cansat-tsniimash/KNPN-2023/construction/Sat/plata_dop_asm_final_naverno.stl

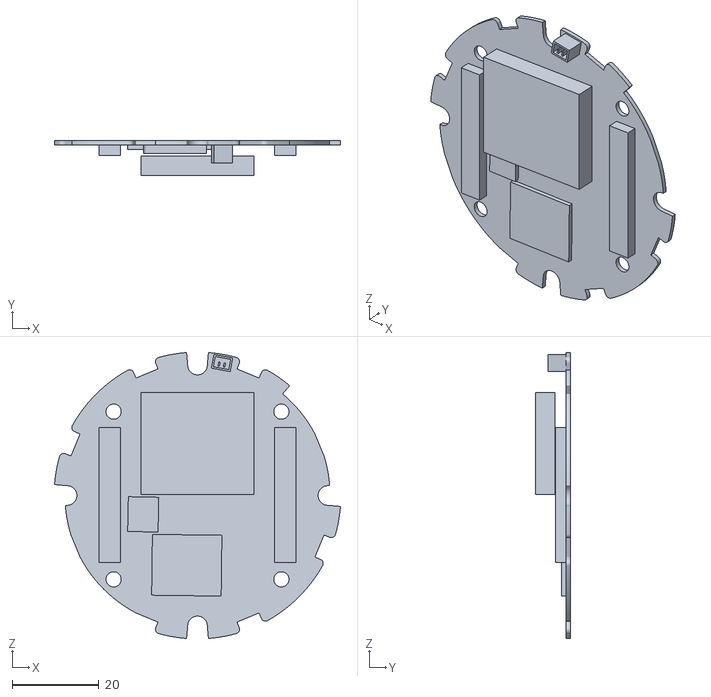
[picture p1: CAD file, 2023-04-08]
construction/Sat/plata_dop_asm_final_naverno.stl
65.8 x 8.00 x 65.8
