cansat-tsniimash/KNPN-2023/construction/Sat/print/plata_dop_pla_down.stl

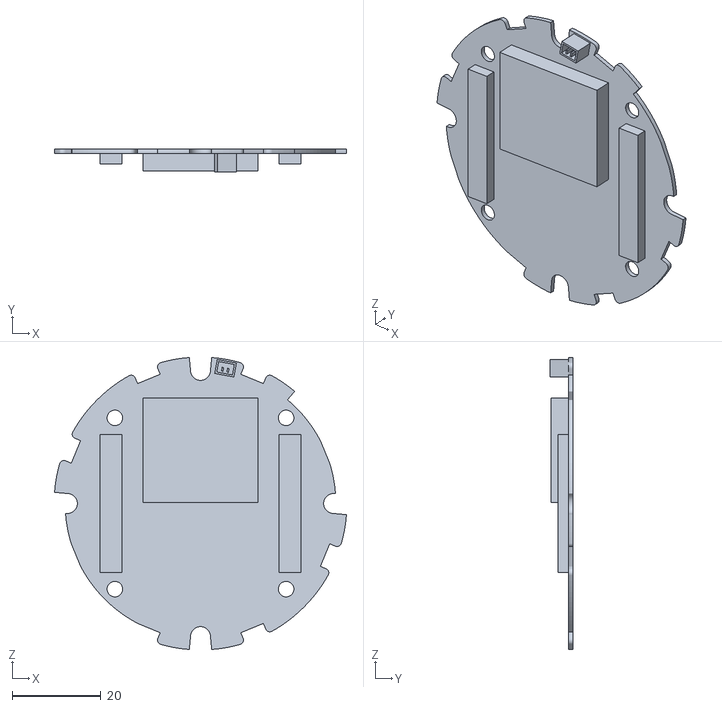
[picture p2: CAD file, 2023-05-27]
construction/Sat/print/plata_dop_pla_down.stl
65.8 x 5.20 x 65.8
