cansat-tsniimash/KNPN-2023/construction/Sat/sp_base.stl

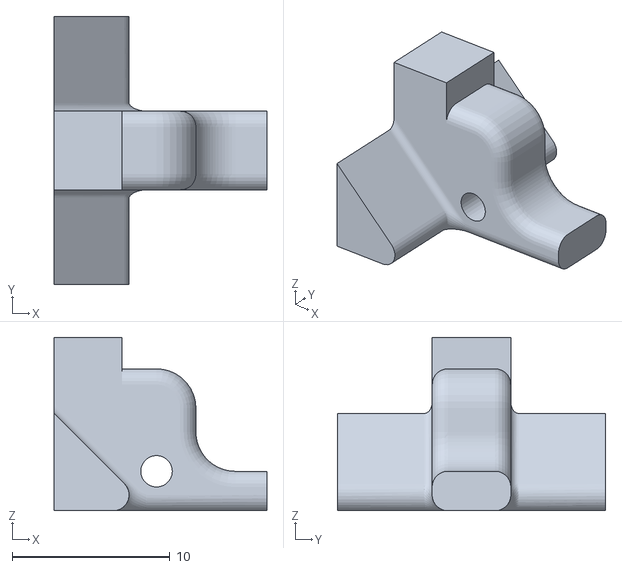
[picture p3: CAD file, 2023-07-02]
construction/Sat/sp_base.stl
13.5 x 17.0 x 11.0
