cansat-tsniimash/KNPN-2023/construction/STL/box.stl

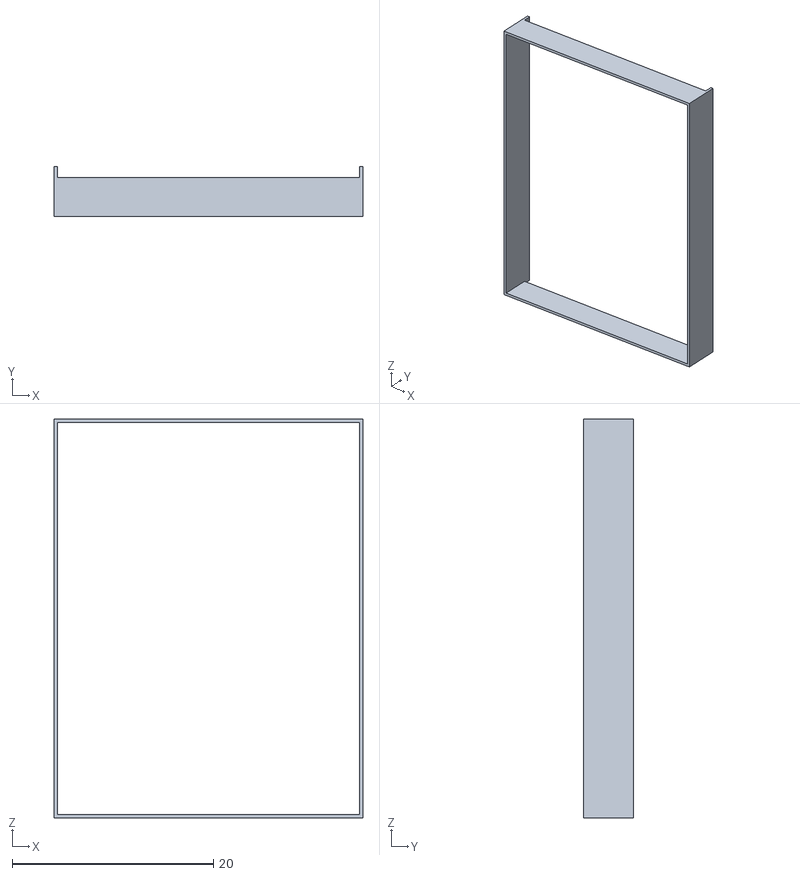
[picture p4: CAD file, 2023-07-02]
construction/STL/box.stl
30.7 x 5.00 x 39.7
