cansat-tsniimash/KNPN-2023/construction/Sat/gear-bot-big.stp

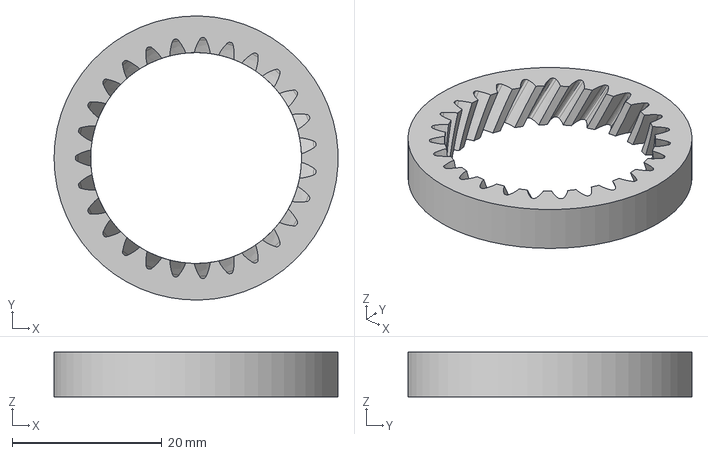
[picture p5: CAD file, 2023-06-05]
construction/Sat/gear-bot-big.stp
38.0 x 38.0 x 6.00 mm
