cansat-tsniimash/KNPN-2023/construction/Sat/print/sp_krepezh_plata2.stl

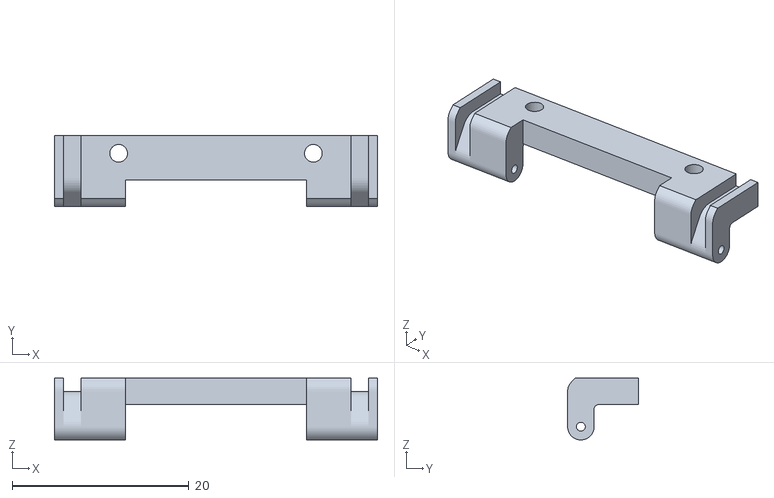
[picture p6: CAD file, 2023-05-27]
construction/Sat/print/sp_krepezh_plata2.stl
36.5 x 8.00 x 7.00
