cansat-tsniimash/KNPN-2023/construction/STL/sp_krepezh_plata1.stl

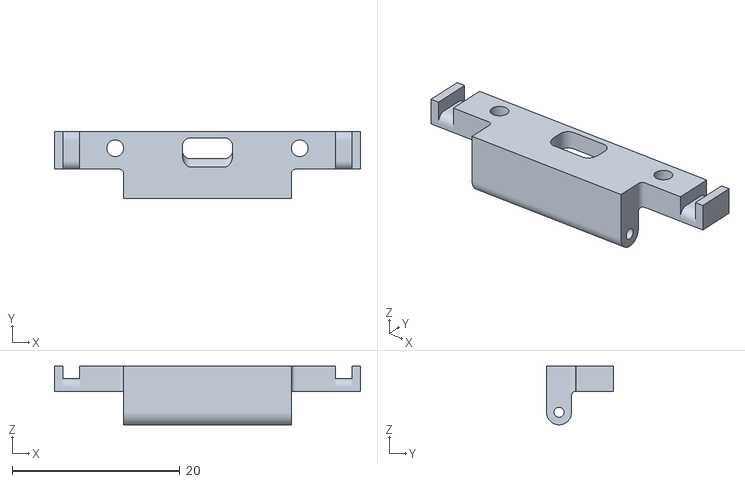
[picture p7: CAD file, 2023-07-02]
construction/STL/sp_krepezh_plata1.stl
36.5 x 8.00 x 7.00
