cansat-tsniimash/KNPN-2023/construction/Sat/gear-bot-small.stp

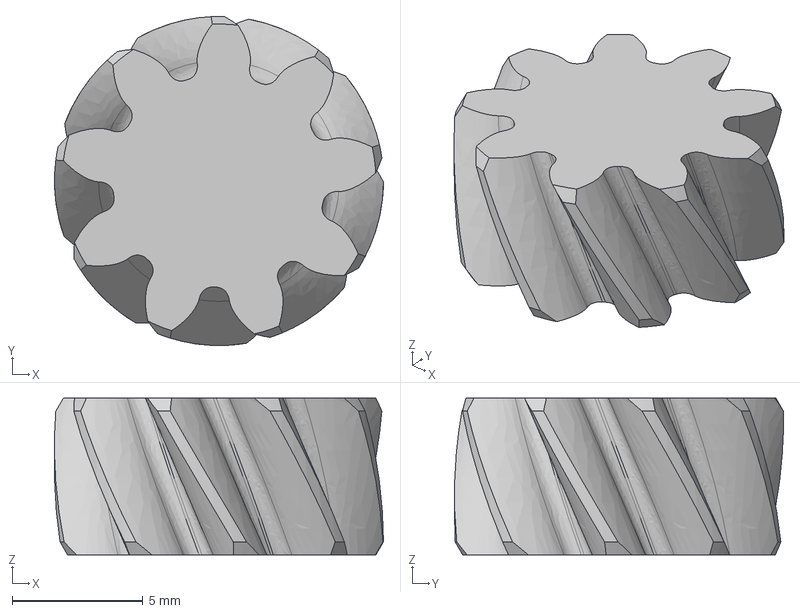
[picture p8: CAD file, 2023-06-05]
construction/Sat/gear-bot-small.stp
12.6 x 12.6 x 6.00 mm
