cansat-tsniimash/KNPN-2023/construction/STL/gear_motor_2axis_max.stl

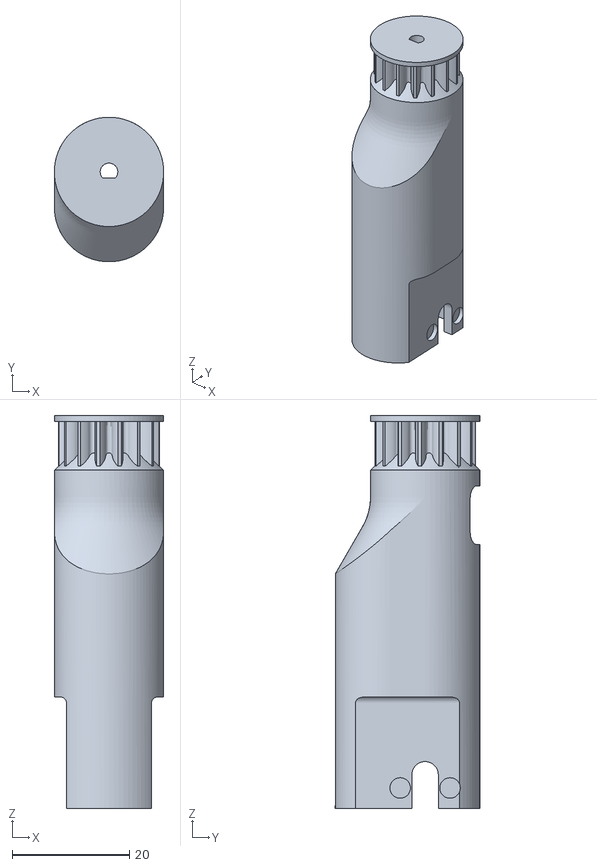
[picture p9: CAD file, 2023-07-02]
construction/STL/gear_motor_2axis_max.stl
18.6 x 24.6 x 67.0
