cansat-tsniimash/KNPN-2023/construction/Sat/krishka_akkum.stl

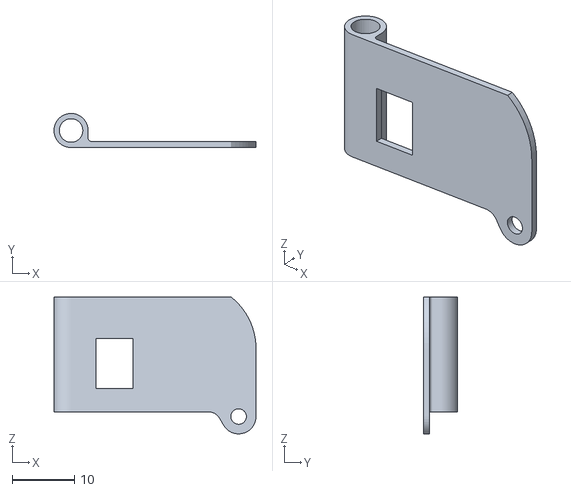
[picture p10: CAD file, 2023-05-27]
construction/Sat/krishka_akkum.stl
32.5 x 5.50 x 22.0
