cansat-tsniimash/KNPN-2023/construction/Sat/print/parachut_gps.stl

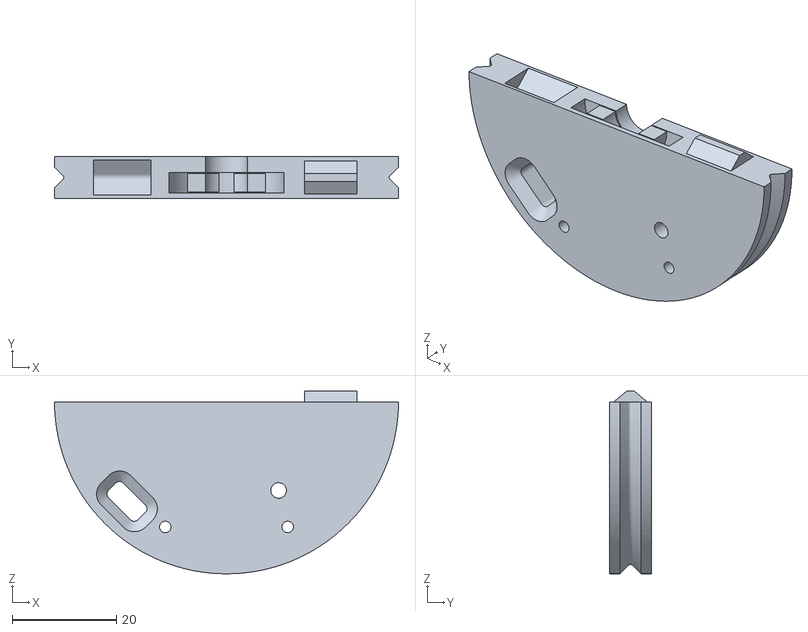
[picture p11: CAD file, 2023-05-27]
construction/Sat/print/parachut_gps.stl
66.0 x 8.00 x 35.1
