cansat-tsniimash/KNPN-2023/construction/STL/blinchik-down_1_low.stl

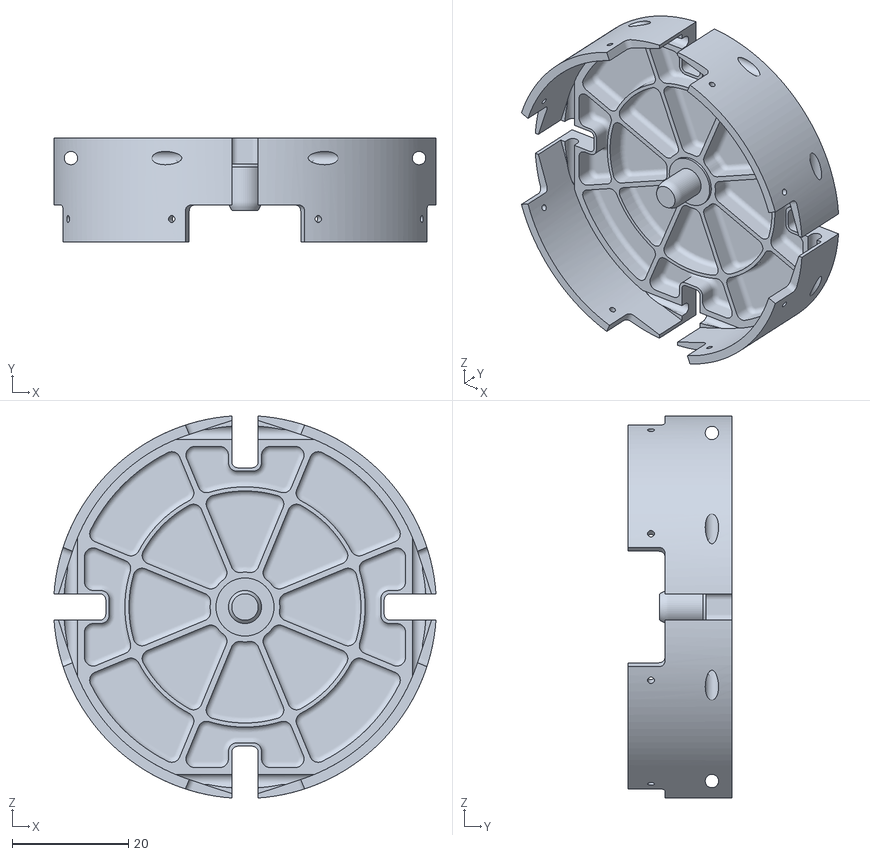
[picture p12: CAD file, 2023-07-02]
construction/STL/blinchik-down_1_low.stl
65.8 x 18.0 x 65.8
