cansat-tsniimash/KNPN-2023/construction/Sat/kreplenie_motor_i_akkum_niz.stl

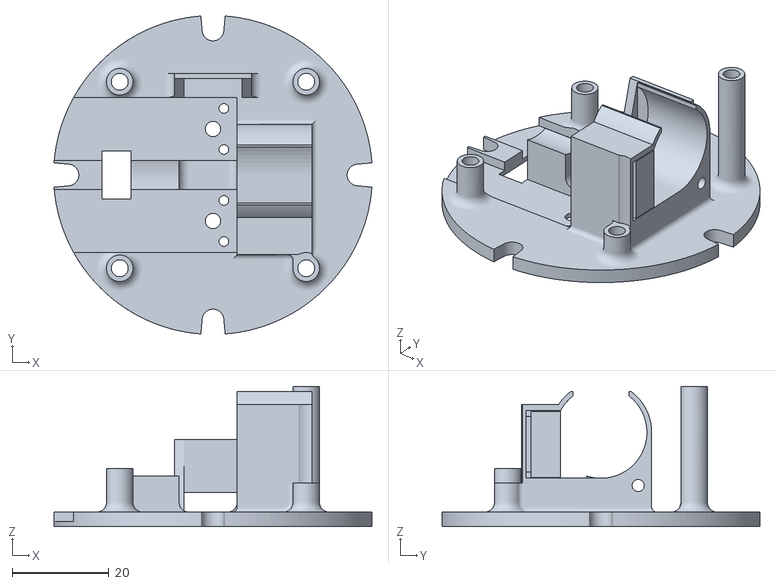
[picture p13: CAD file, 2023-05-27]
construction/Sat/kreplenie_motor_i_akkum_niz.stl
65.8 x 65.8 x 29.0
