cansat-tsniimash/KNPN-2023/construction/Sat/print/blinchik_for_kreplenie.stl

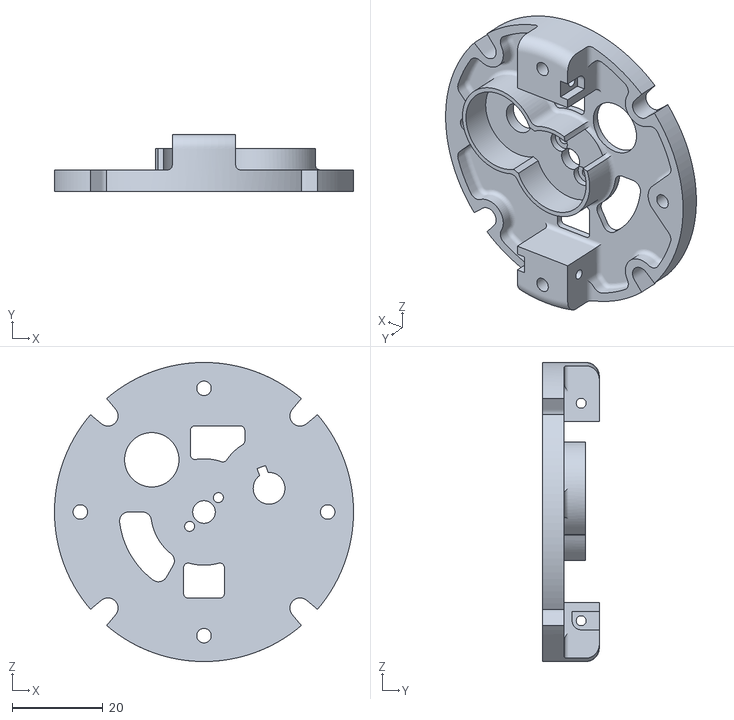
[picture p14: CAD file, 2023-05-27]
construction/Sat/print/blinchik_for_kreplenie.stl
66.0 x 12.5 x 66.0
