cansat-tsniimash/KNPN-2023/construction/STL/sp_zaglushka.stl

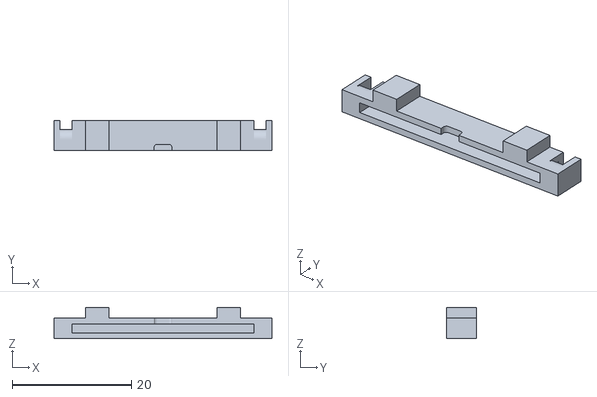
[picture p15: CAD file, 2023-07-02]
construction/STL/sp_zaglushka.stl
36.5 x 5.00 x 5.20
