cansat-tsniimash/KNPN-2023/construction/Sat/disk.stl

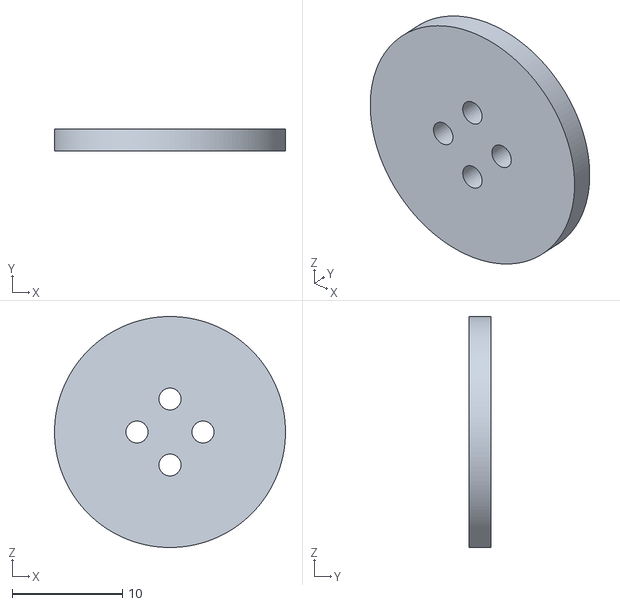
[picture p16: CAD file, 2023-05-27]
construction/Sat/disk.stl
21.0 x 2.00 x 21.0
