cansat-tsniimash/KNPN-2023/construction/STL/kreplenie_motor_i_akkum_niz_2.stl

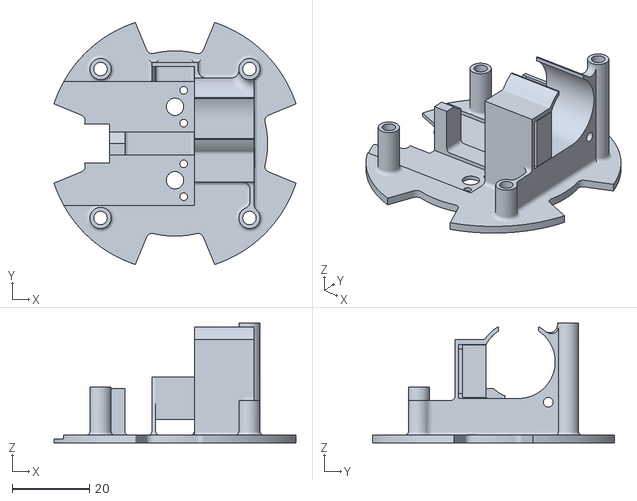
[picture p17: CAD file, 2023-07-02]
construction/STL/kreplenie_motor_i_akkum_niz_2.stl
62.7 x 62.7 x 31.0
