cansat-tsniimash/KNPN-2023/construction/Sat/kreplenie_plata.stl

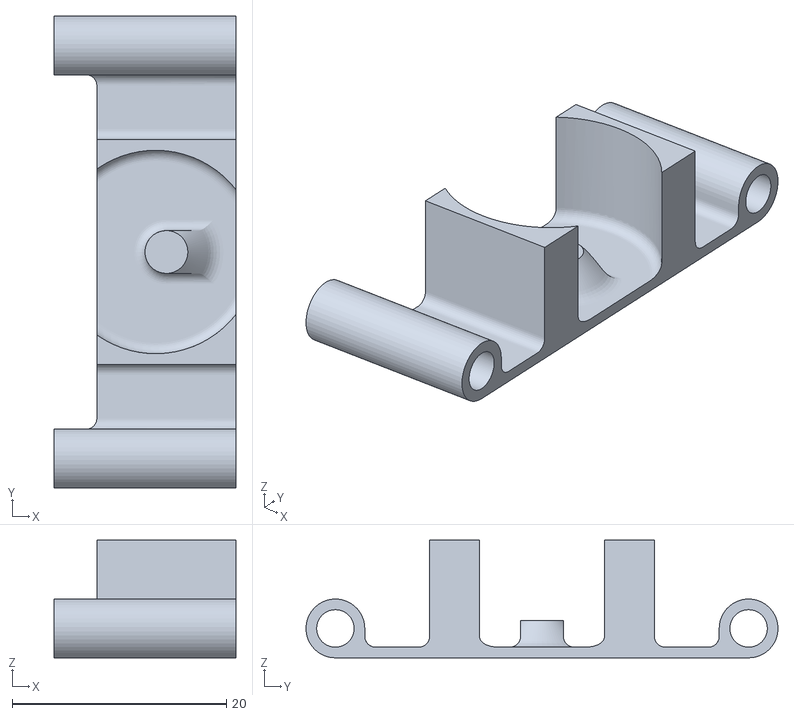
[picture p18: CAD file, 2023-05-27]
construction/Sat/kreplenie_plata.stl
17.0 x 44.1 x 11.0
