cansat-tsniimash/KNPN-2023/construction/STL/cilindr.stl

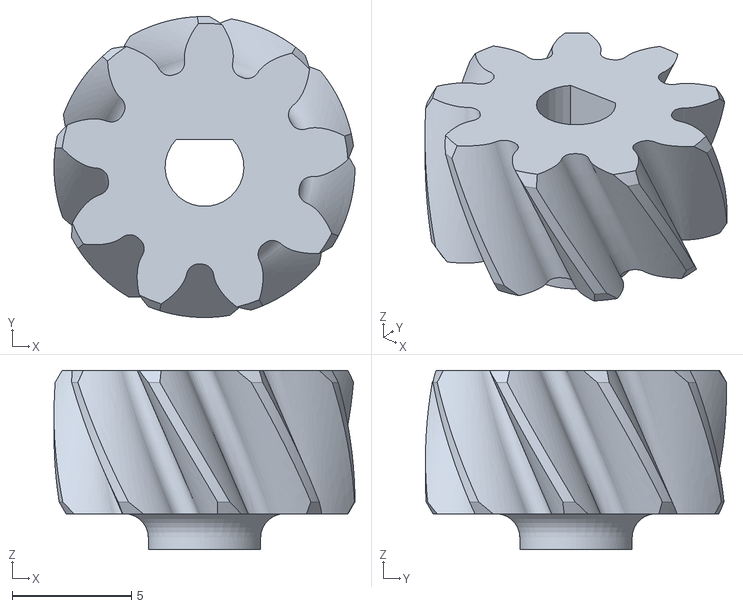
[picture p19: CAD file, 2023-07-02]
construction/STL/cilindr.stl
12.6 x 12.6 x 7.50
