cansat-tsniimash/KNPN-2023/construction/Sat/parachut_gps_final_pechat_100pro.stl

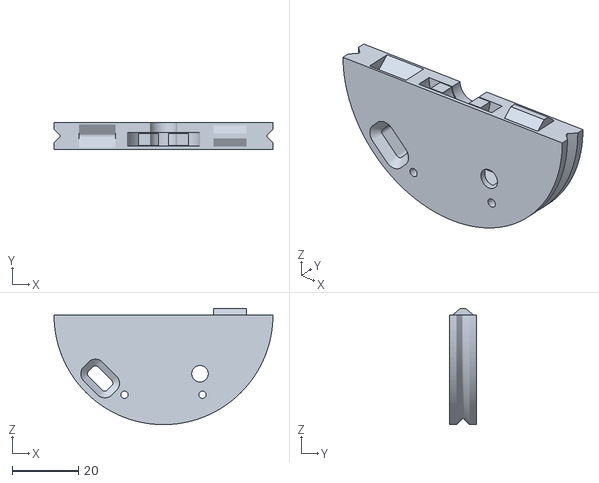
[picture p20: CAD file, 2023-05-27]
construction/Sat/parachut_gps_final_pechat_100pro.stl
66.0 x 8.00 x 35.1
