cansat-tsniimash/KNPN-2023/construction/Sat/print/sp_plata.stl

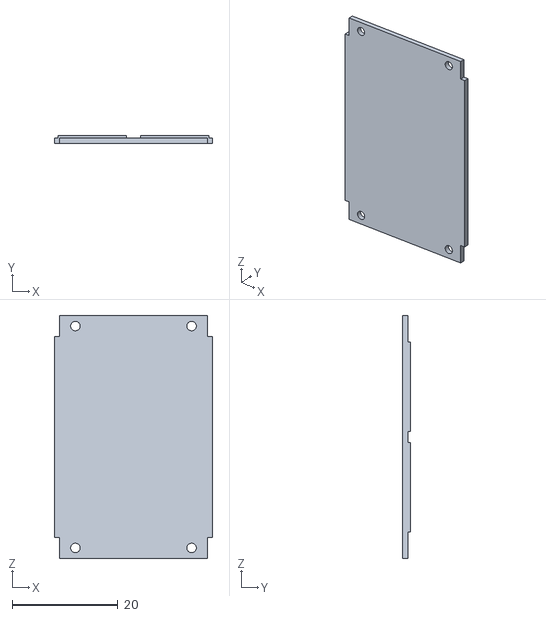
[picture p21: CAD file, 2023-05-27]
construction/Sat/print/sp_plata.stl
30.0 x 1.50 x 46.0
