cansat-tsniimash/KNPN-2023/construction/Sat/plata_dop_pla2.stl

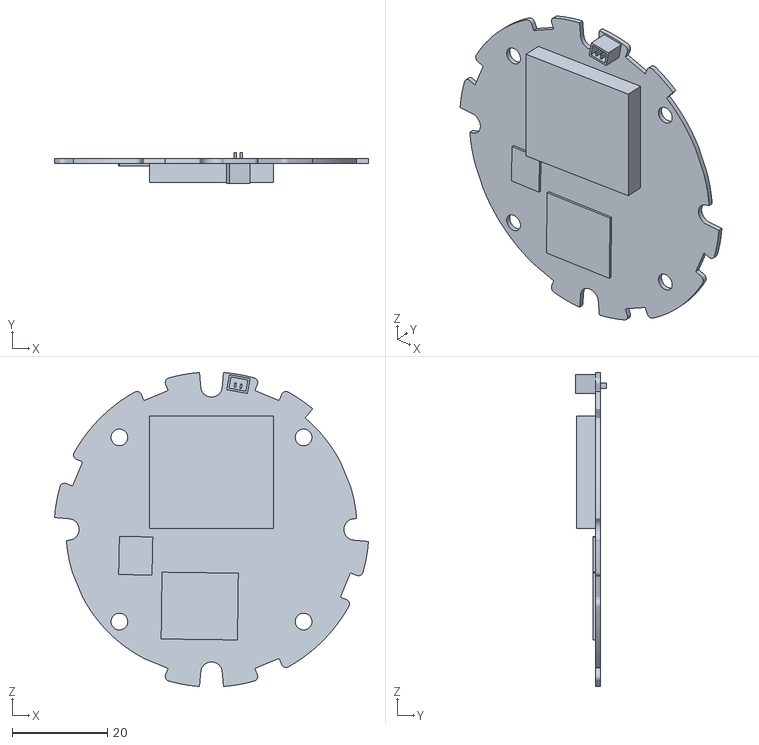
[picture p22: CAD file, 2023-04-08]
construction/Sat/plata_dop_pla2.stl
65.8 x 6.50 x 65.8
