cansat-tsniimash/KNPN-2023/construction/Sat/print/sp_zaglushka.stl

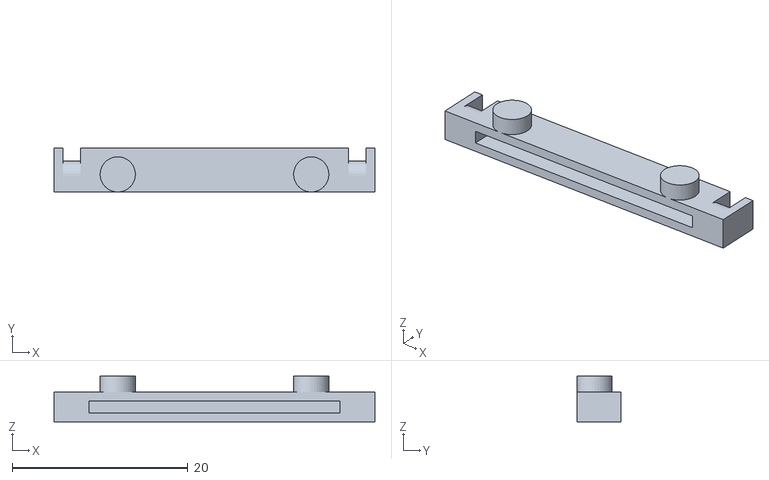
[picture p23: CAD file, 2023-05-27]
construction/Sat/print/sp_zaglushka.stl
36.5 x 5.00 x 5.20
