cansat-tsniimash/KNPN-2023/construction/Sat/plata_dop_pla_fixed2.stl

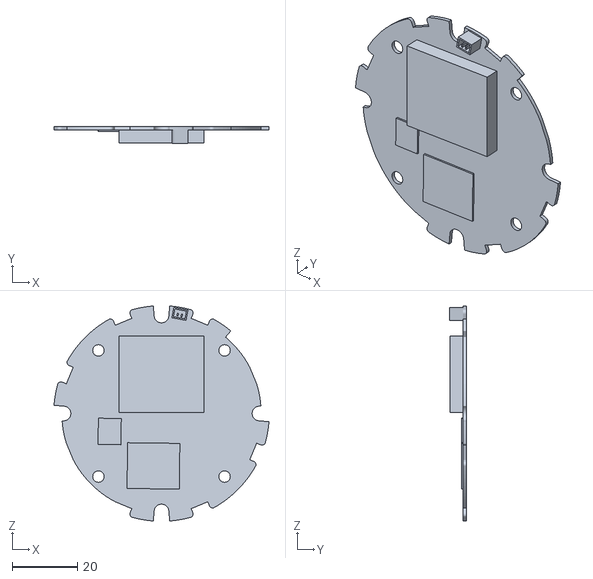
[picture p24: CAD file, 2023-04-08]
construction/Sat/plata_dop_pla_fixed2.stl
65.8 x 5.20 x 65.8
