cansat-tsniimash/KNPN-2023/construction/Sat/print/sp_krepezh_plata_motor.stl

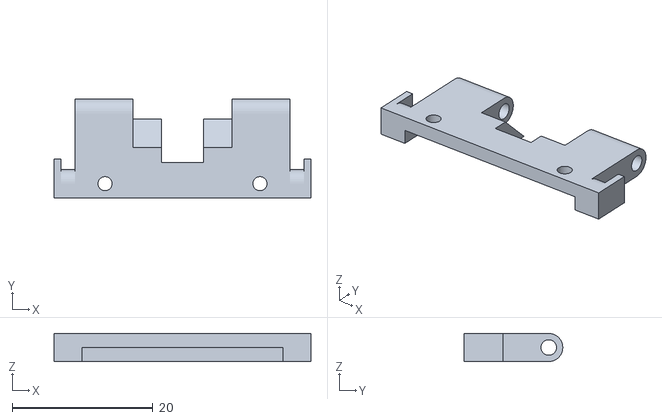
[picture p25: CAD file, 2023-05-27]
construction/Sat/print/sp_krepezh_plata_motor.stl
36.5 x 14.0 x 4.00
