cansat-tsniimash/KNPN-2023/construction/STL/detal_vrashenie_w_spring.stl

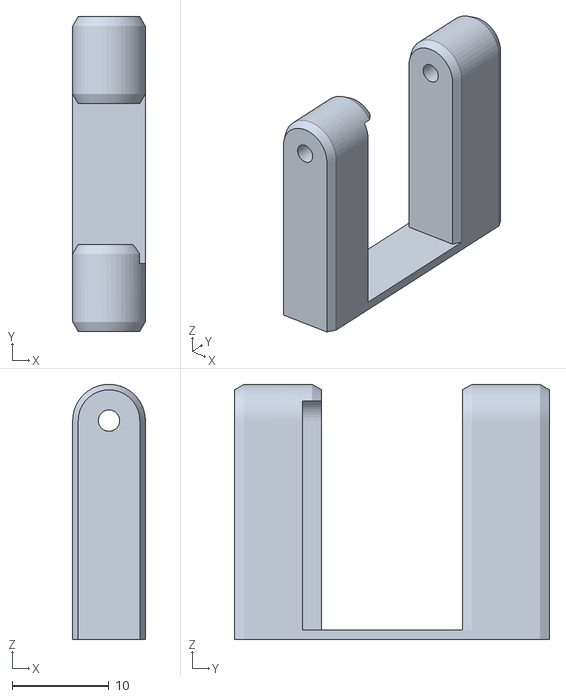
[picture p26: CAD file, 2023-07-02]
construction/STL/detal_vrashenie_w_spring.stl
7.50 x 32.5 x 26.3
