cansat-tsniimash/KNPN-2023/construction/Sat/blinchik-down_2.stl

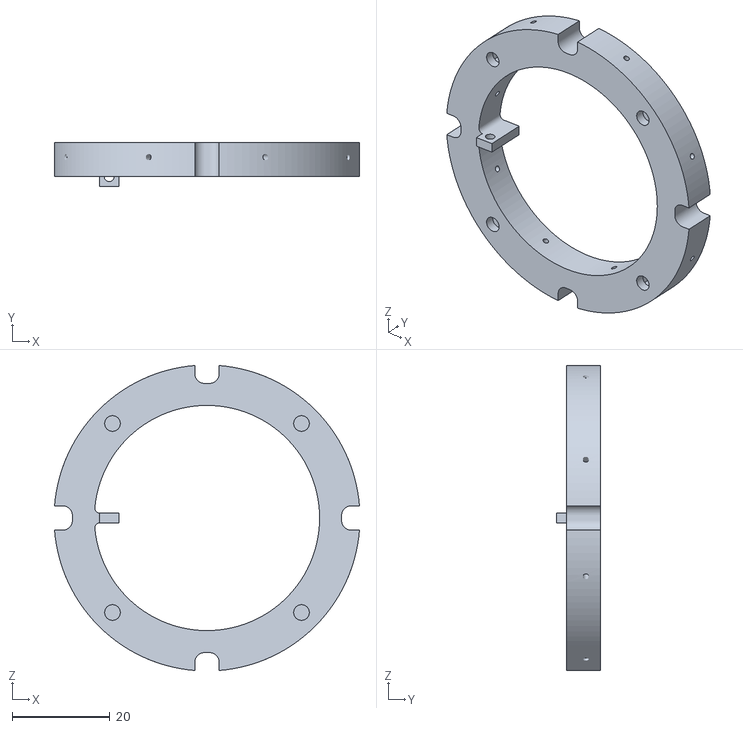
[picture p27: CAD file, 2023-04-08]
construction/Sat/blinchik-down_2.stl
62.3 x 9.00 x 62.3
