cansat-tsniimash/KNPN-2023/construction/Sat/print/plata_dop_pla_up.stl

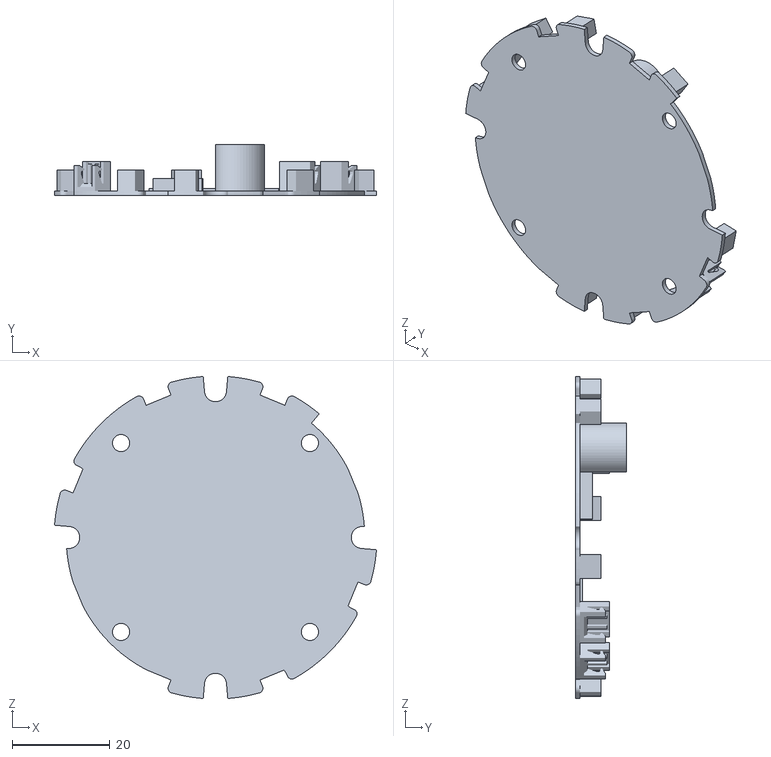
[picture p28: CAD file, 2023-05-27]
construction/Sat/print/plata_dop_pla_up.stl
65.8 x 10.5 x 65.8
