cansat-tsniimash/KNPN-2023/construction/STL/sp_krepezh_plata_motor.stl

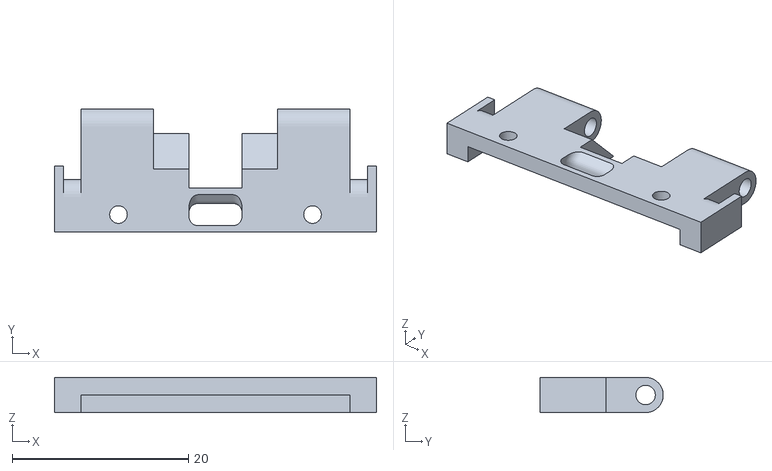
[picture p29: CAD file, 2023-07-02]
construction/STL/sp_krepezh_plata_motor.stl
36.5 x 14.0 x 4.00
