cansat-tsniimash/KNPN-2023/construction/Sat/plata_dop_pla1.stl

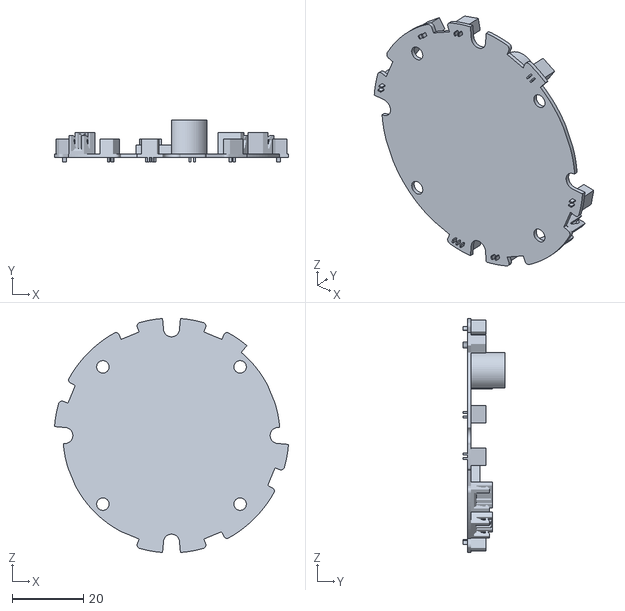
[picture p30: CAD file, 2023-04-08]
construction/Sat/plata_dop_pla1.stl
65.8 x 11.8 x 65.8
