cansat-tsniimash/KNPN-2023/construction/STL/blinchik-down_2_final.stl

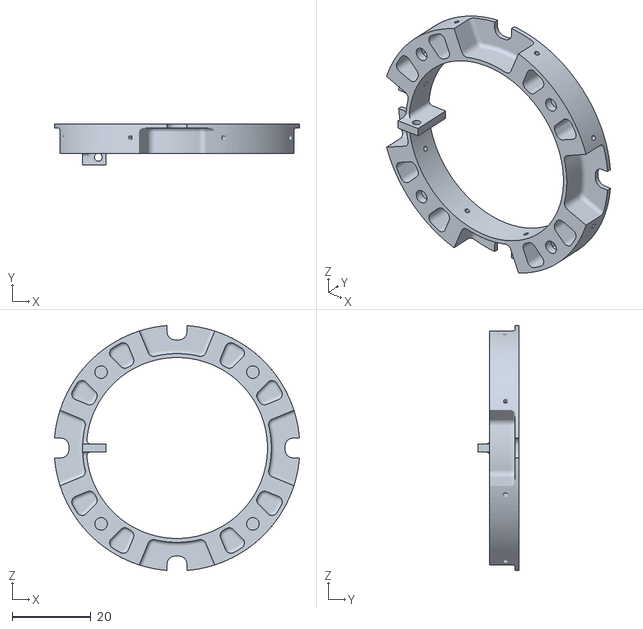
[picture p31: CAD file, 2023-07-02]
construction/STL/blinchik-down_2_final.stl
62.3 x 10.5 x 62.3
