cansat-tsniimash/KNPN-2023/construction/Sat/blinchik-down_1.stl

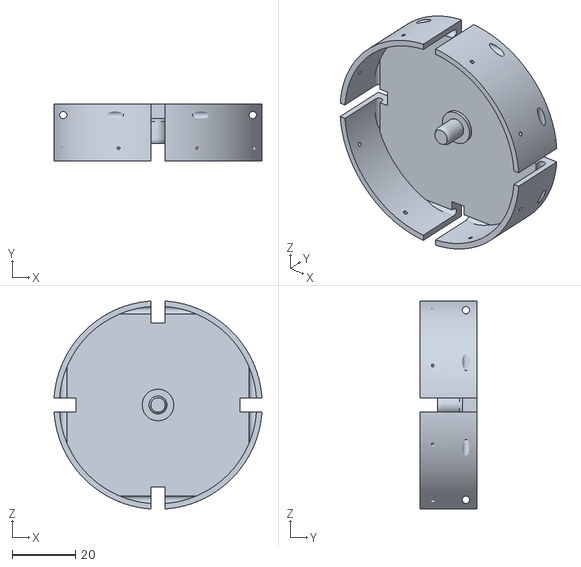
[picture p32: CAD file, 2023-04-08]
construction/Sat/blinchik-down_1.stl
65.8 x 18.0 x 65.8
