cansat-tsniimash/KNPN-2023/construction/Sat/plata_dop_pla_fixed1.stl

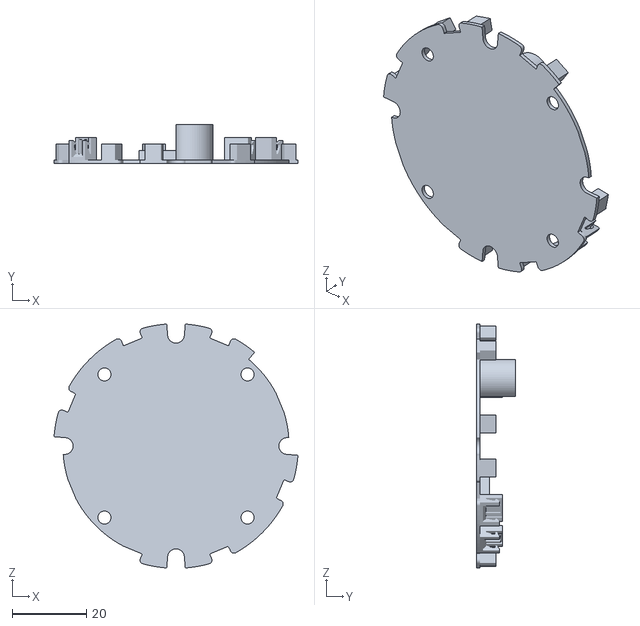
[picture p33: CAD file, 2023-04-08]
construction/Sat/plata_dop_pla_fixed1.stl
65.8 x 10.5 x 65.8
