cansat-tsniimash/KNPN-2023/construction/STL/kreplenie_plata.stl

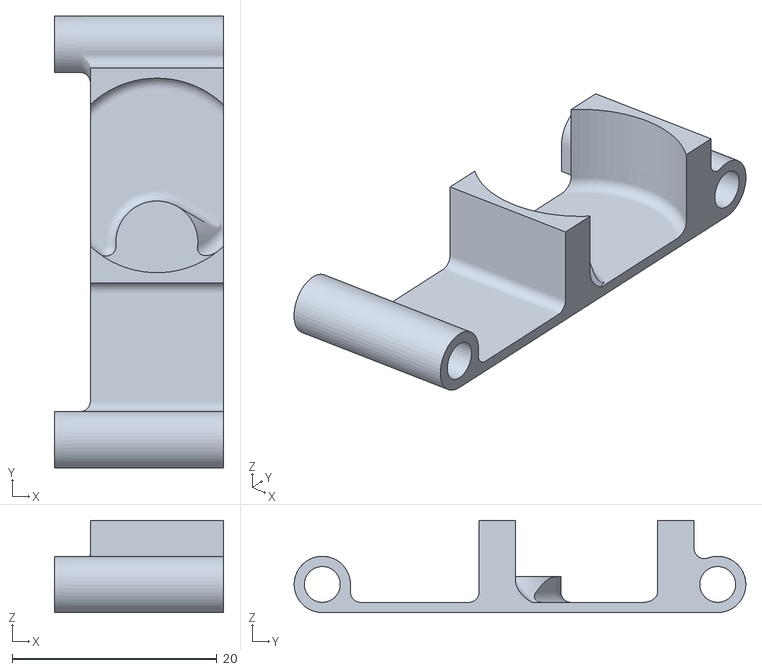
[picture p34: CAD file, 2023-06-05]
construction/STL/kreplenie_plata.stl
16.5 x 44.1 x 9.00
