cansat-tsniimash/KNPN-2023/construction/Sat/kreplenie_camera.stl

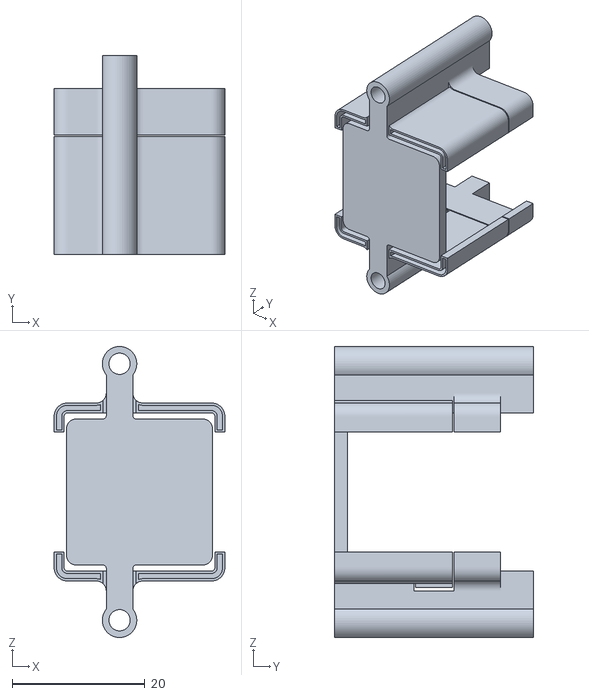
[picture p35: CAD file, 2023-04-08]
construction/Sat/kreplenie_camera.stl
25.7 x 30.0 x 43.8
