cansat-tsniimash/KNPN-2023/construction/Sat/tube_4mm.stl

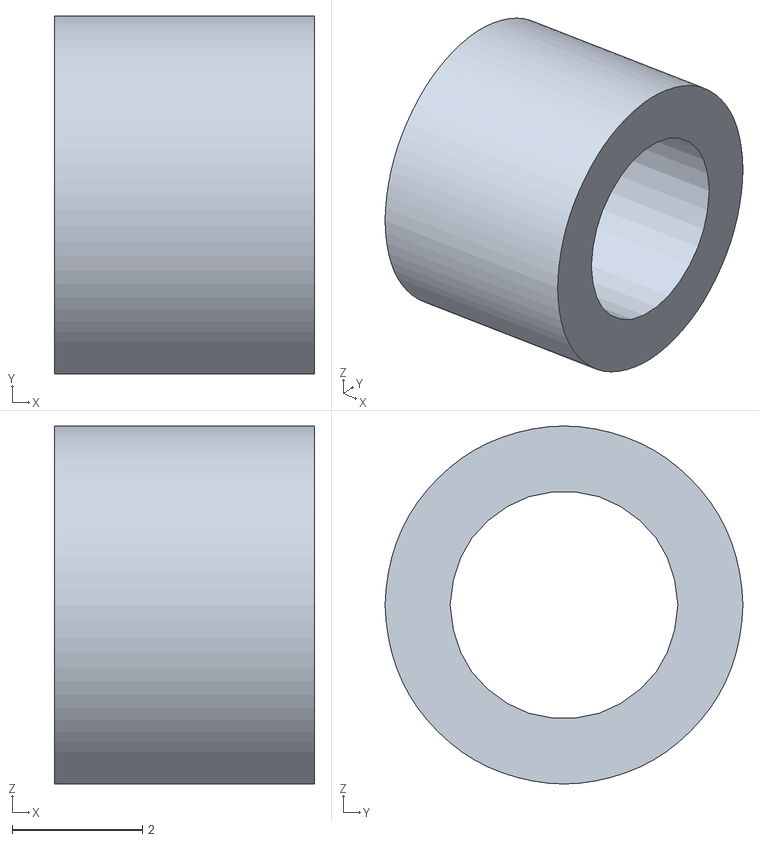
[picture p36: CAD file, 2023-04-08]
construction/Sat/tube_4mm.stl
4.00 x 5.50 x 5.50
