cansat-tsniimash/KNPN-2023/construction/STL/parachut_gps.stl

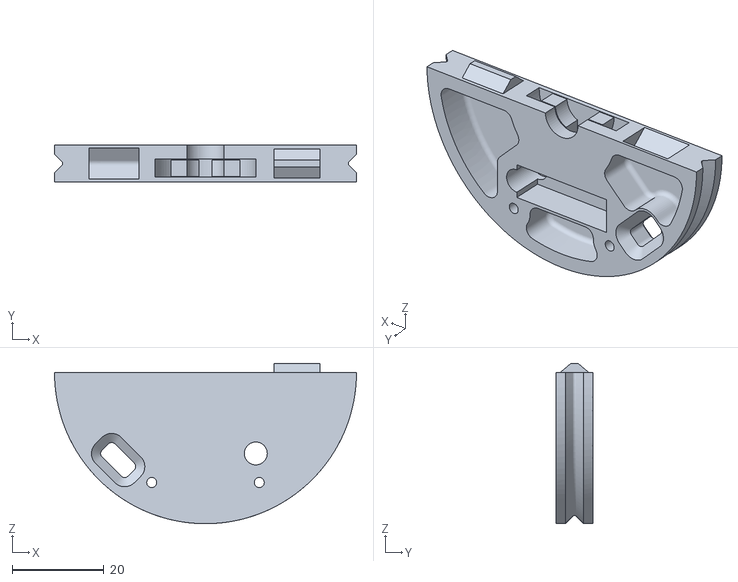
[picture p37: CAD file, 2023-06-05]
construction/STL/parachut_gps.stl
66.0 x 8.00 x 35.1
