cansat-tsniimash/KNPN-2023/construction/Sat/tube_7mm.stl

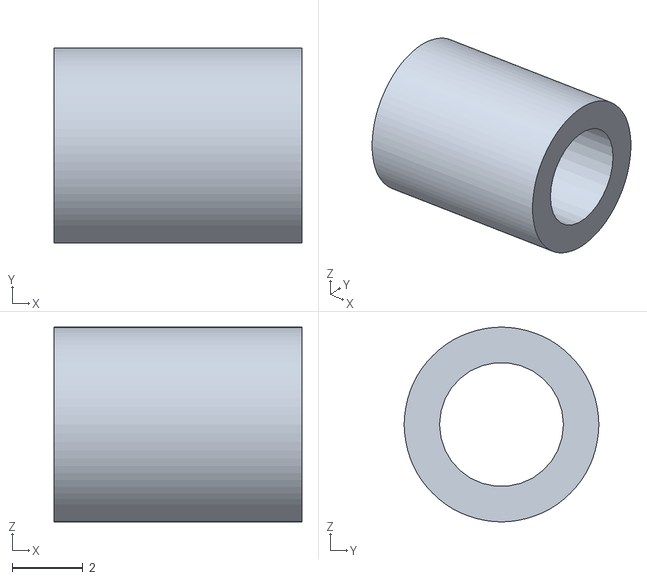
[picture p38: CAD file, 2023-04-08]
construction/Sat/tube_7mm.stl
7.00 x 5.50 x 5.50
