cansat-tsniimash/KNPN-2023/construction/STL/blinchik_kernel_up.stl

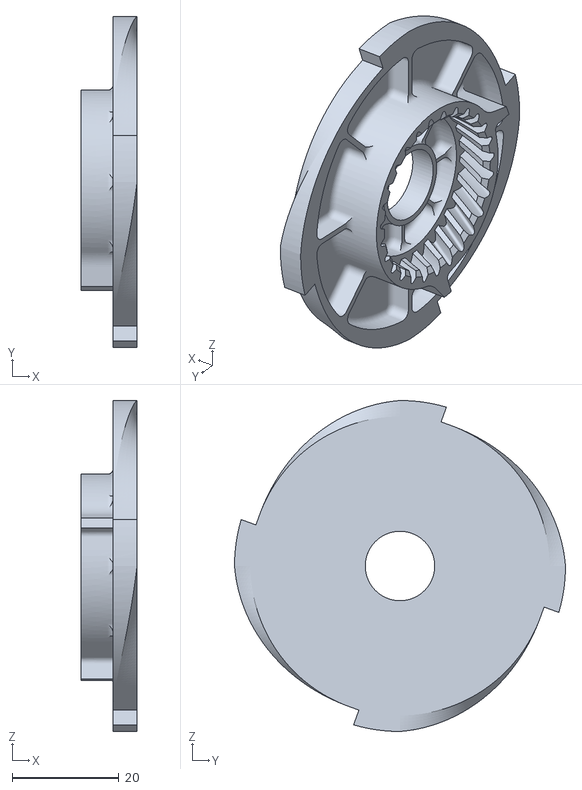
[picture p39: CAD file, 2023-06-05]
construction/STL/blinchik_kernel_up.stl
10.5 x 62.0 x 62.0
