cansat-tsniimash/KNPN-2023/construction/Sat/drw0001.dxf

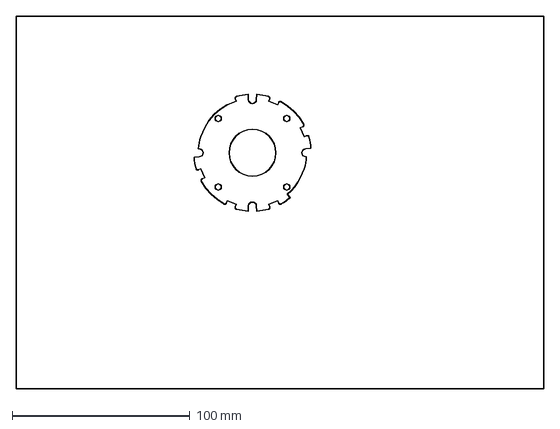
[picture p40: CAD file, 2023-03-27]
construction/Sat/drw0001.dxf
297.0 x 210.0 mm
