cansat-tsniimash/KNPN-2023/construction/STL/blinchik-down_2.stl

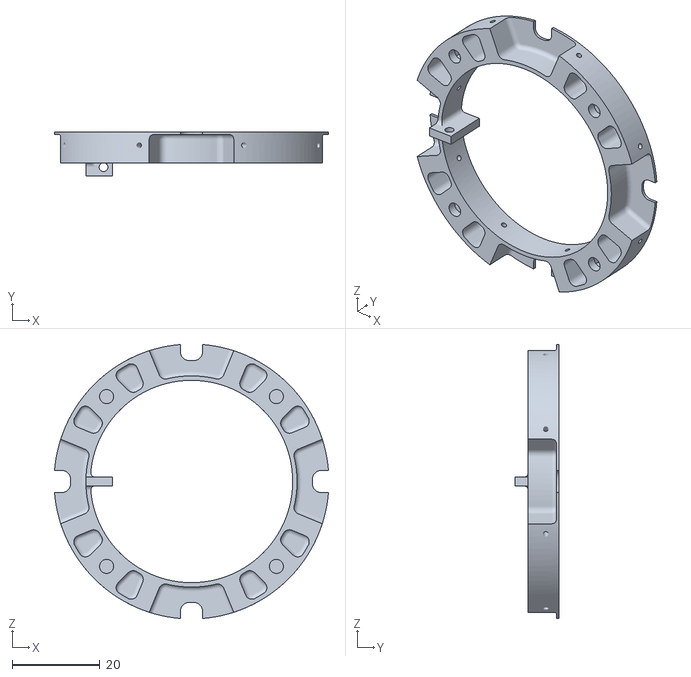
[picture p41: CAD file, 2023-06-05]
construction/STL/blinchik-down_2.stl
62.3 x 10.0 x 62.3
