cansat-tsniimash/KNPN-2023/construction/Sat/vt93n1.dxf

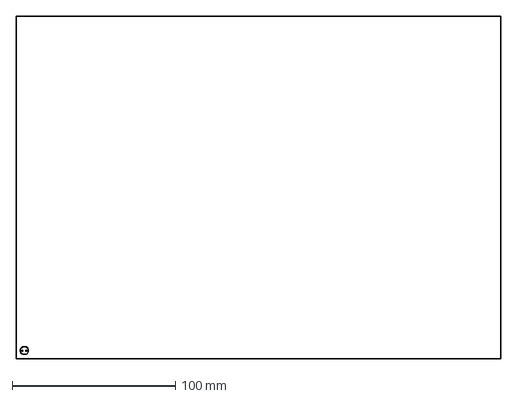
[picture p42: CAD file, 2023-03-25]
construction/Sat/vt93n1.dxf
297.0 x 210.0 mm
