cansat-tsniimash/KNPN-2023/construction/STL/blinchik_for_kreplenie.stl

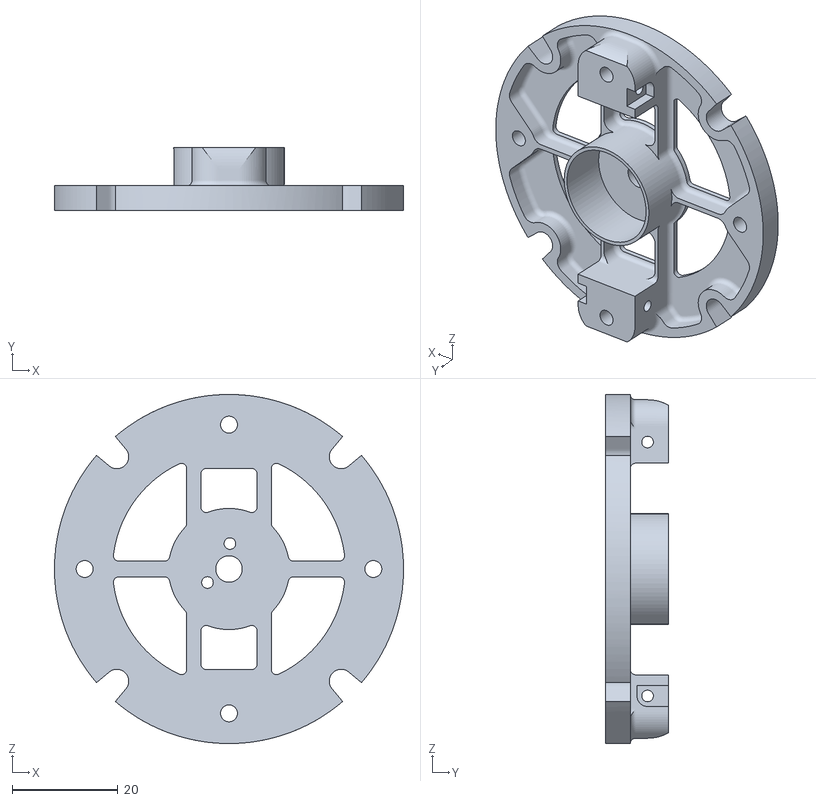
[picture p43: CAD file, 2023-06-05]
construction/STL/blinchik_for_kreplenie.stl
66.0 x 12.0 x 66.0
