cansat-tsniimash/KNPN-2023/construction/Sat/drw0001_2.dxf

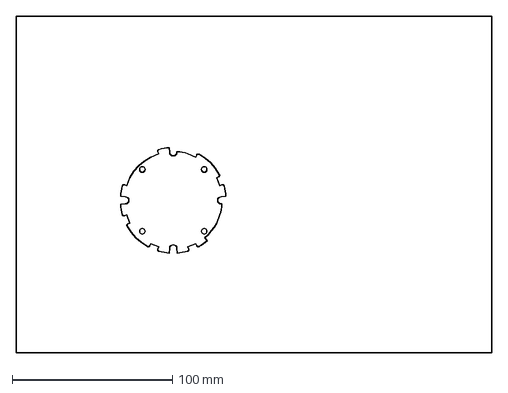
[picture p44: CAD file, 2023-03-25]
construction/Sat/drw0001_2.dxf
297.0 x 210.0 mm
