cansat-tsniimash/KNPN-2023/construction/Sat/blinchik_kernel_up.stl

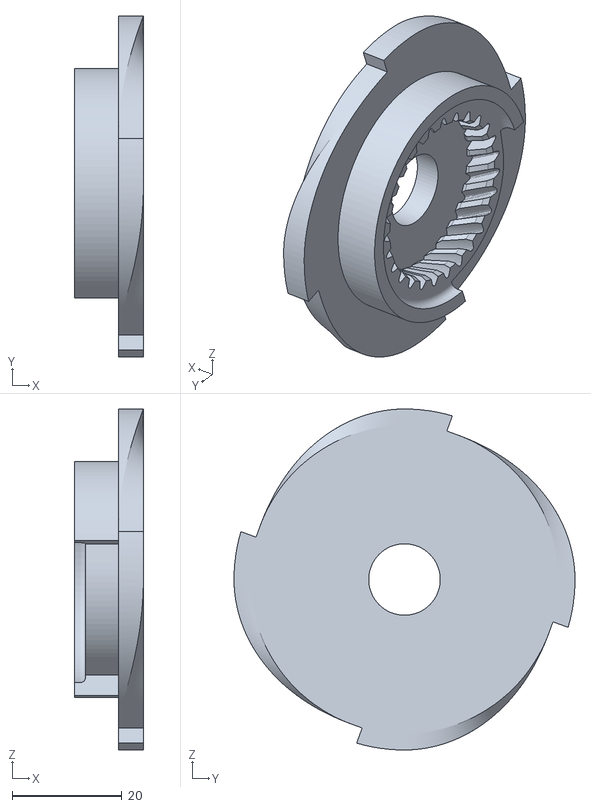
[picture p45: CAD file, 2023-03-03]
construction/Sat/blinchik_kernel_up.stl
12.5 x 62.0 x 62.0
