cansat-tsniimash/KNPN-2023/construction/STL/krishka_akkum.stl

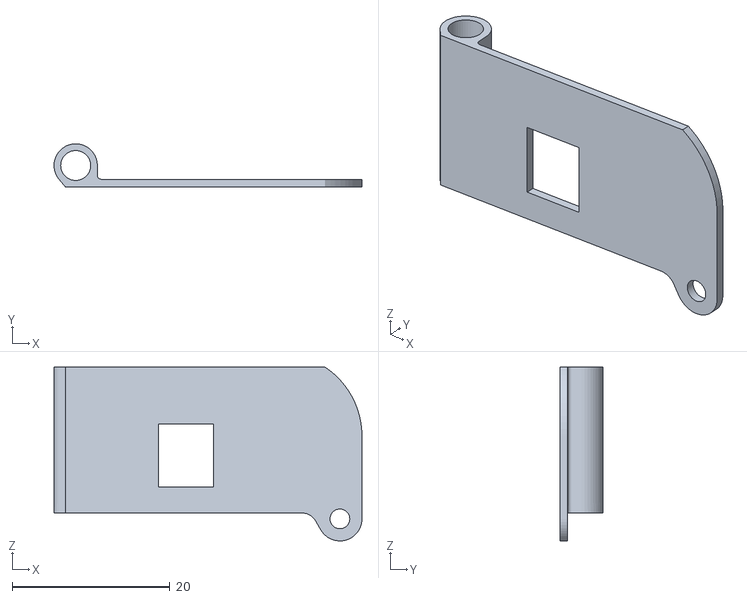
[picture p46: CAD file, 2023-06-05]
construction/STL/krishka_akkum.stl
39.0 x 5.50 x 22.0
