cansat-tsniimash/KNPN-2023/construction/Sat/gear-top-small.stp

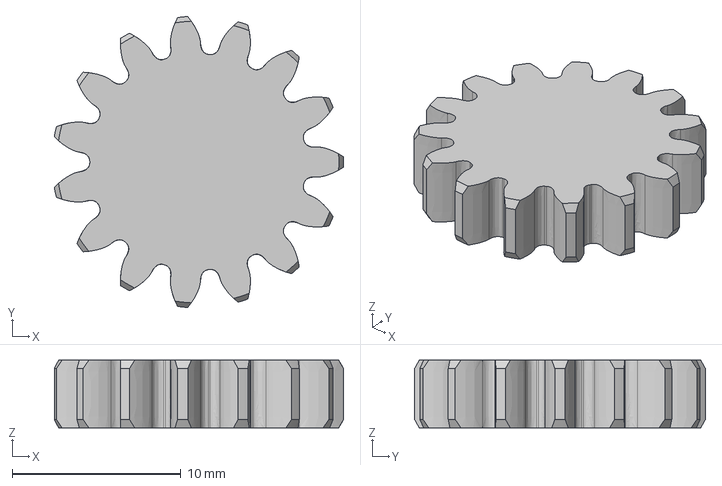
[picture p47: CAD file, 2023-02-19]
construction/Sat/gear-top-small.stp
17.1 x 17.2 x 4.00 mm
