cansat-tsniimash/KNPN-2023/construction/STL/parachut_perezhigatel.stl

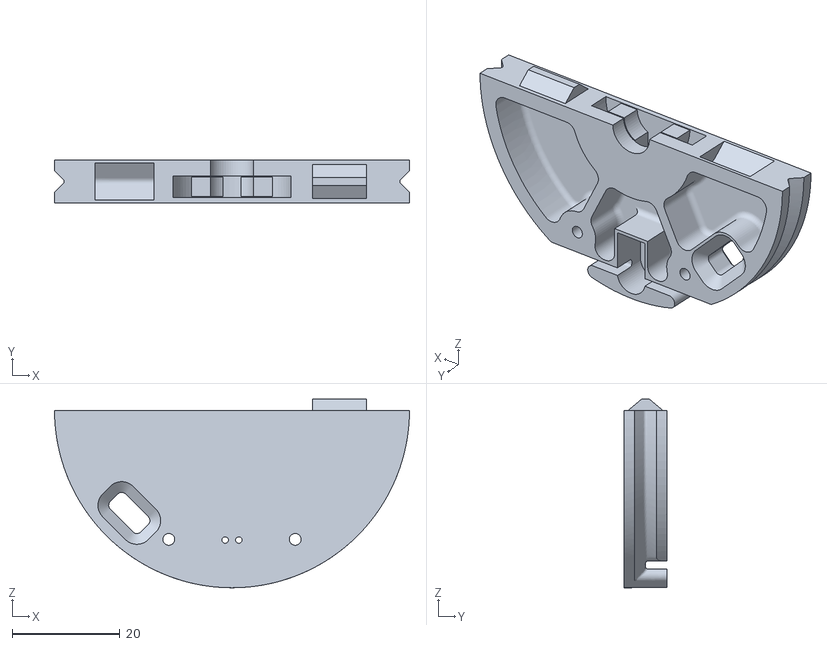
[picture p48: CAD file, 2023-06-05]
construction/STL/parachut_perezhigatel.stl
66.0 x 8.00 x 35.1
