cansat-tsniimash/KNPN-2023/construction/Sat/gear-top-big.stp

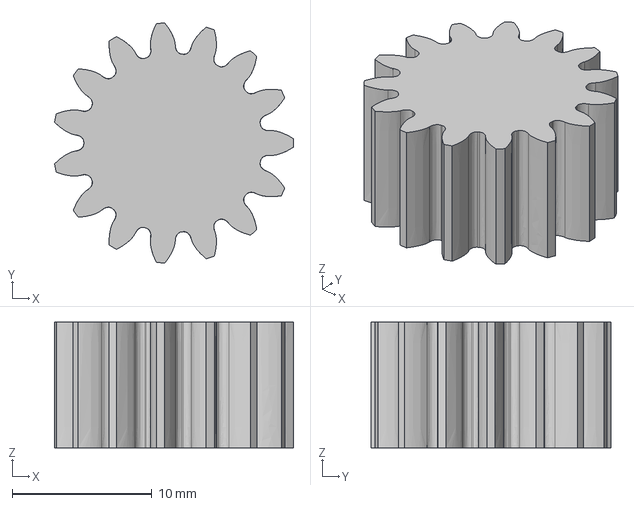
[picture p49: CAD file, 2023-02-19]
construction/Sat/gear-top-big.stp
17.1 x 17.2 x 9.00 mm
