cansat-tsniimash/KNPN-2023/construction/STL/gear_encoder.stl

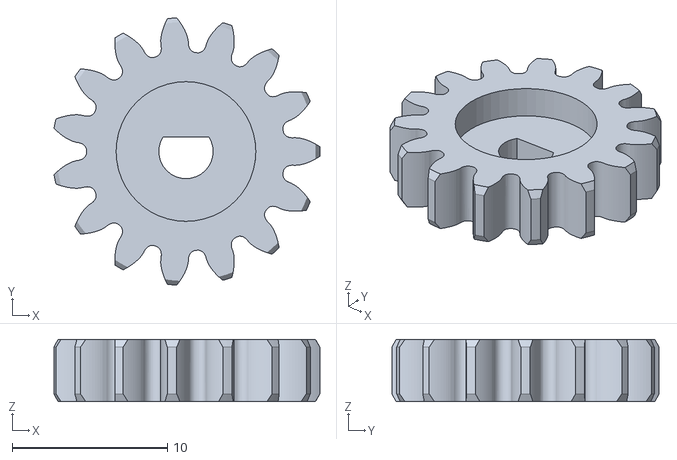
[picture p50: CAD file, 2023-03-25]
construction/STL/gear_encoder.stl
17.1 x 17.2 x 4.00
