cansat-tsniimash/KNPN-2023/construction/STL/sp_base.stl

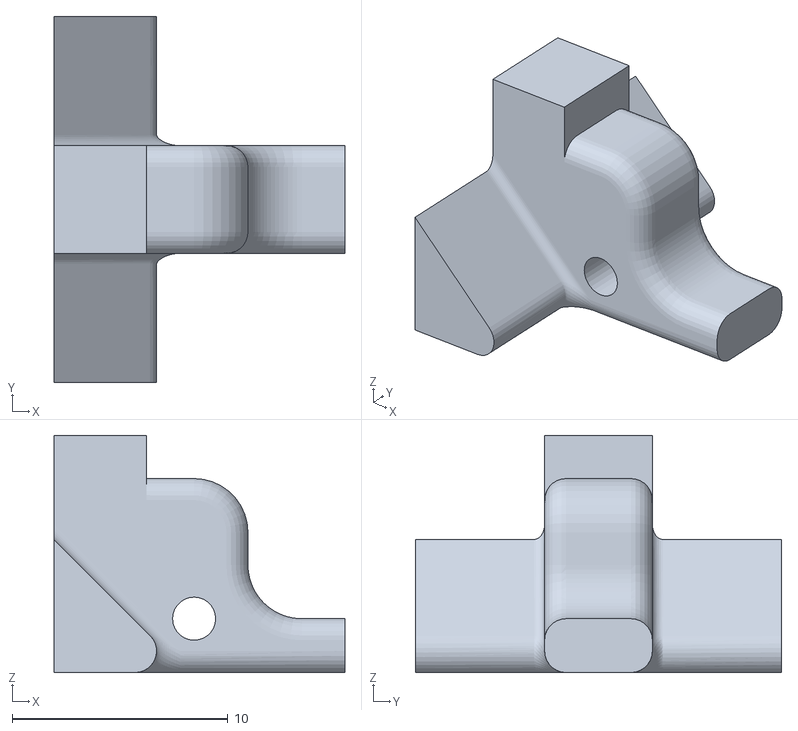
[picture p51: CAD file, 2023-03-25]
construction/STL/sp_base.stl
13.5 x 17.0 x 11.0
