cansat-tsniimash/KNPN-2023/construction/STL/kreplenie_mayak.stl

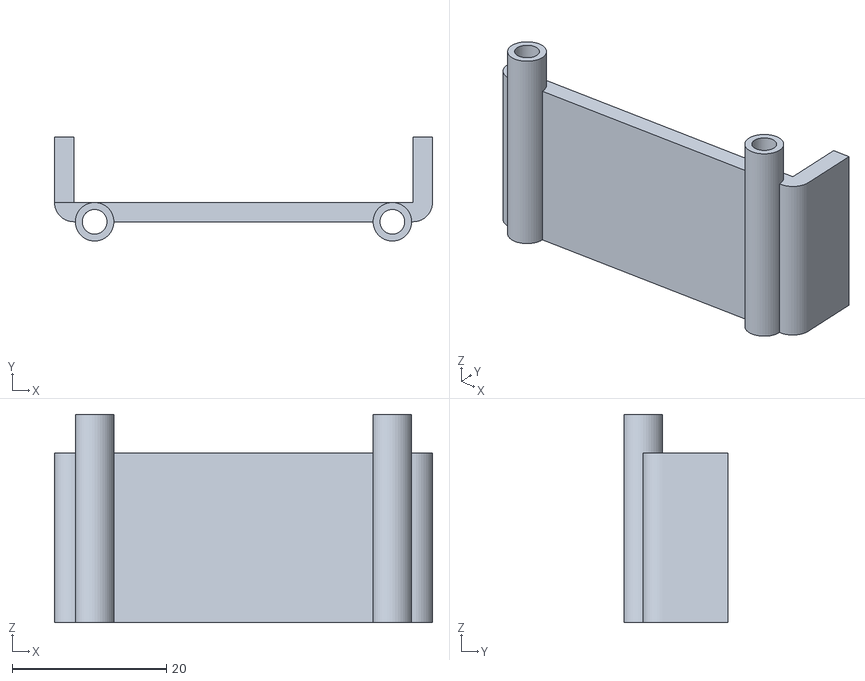
[picture p52: CAD file, 2023-03-25]
construction/STL/kreplenie_mayak.stl
49.0 x 13.5 x 27.0
