cansat-tsniimash/KNPN-2023/construction/STL/detal_vrashenie.stl

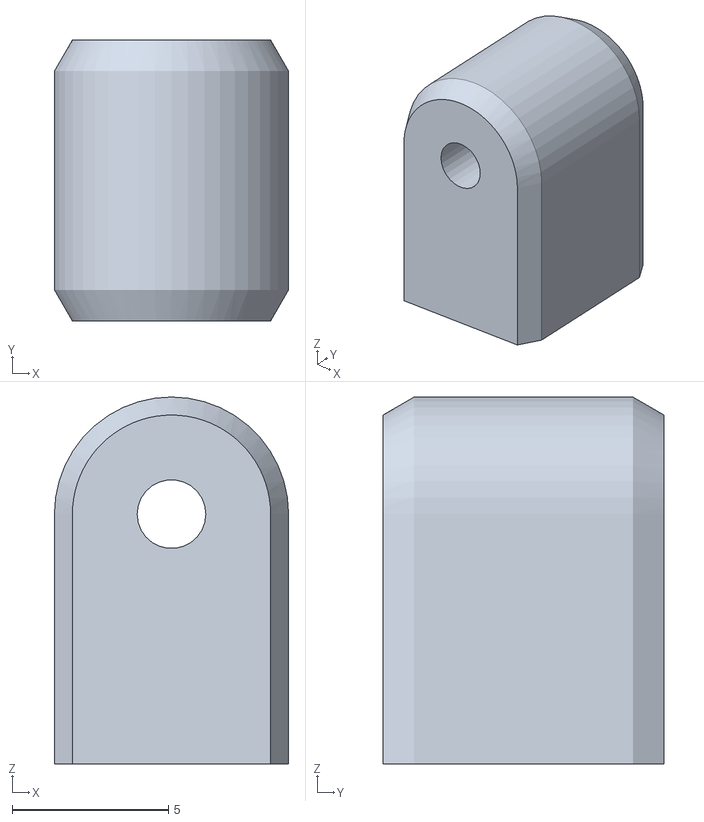
[picture p53: CAD file, 2023-03-25]
construction/STL/detal_vrashenie.stl
7.50 x 9.00 x 11.8
