cansat-tsniimash/KNPN-2023/construction/STL/kreplenie_camera.stl

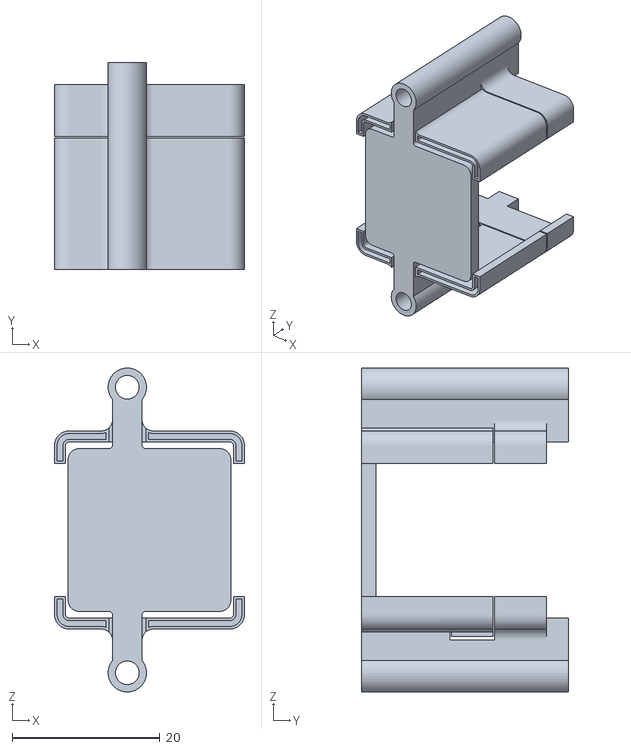
[picture p54: CAD file, 2023-03-03]
construction/STL/kreplenie_camera.stl
25.7 x 28.0 x 43.8
