cansat-tsniimash/KNPN-2023/construction/STL/try1.stl

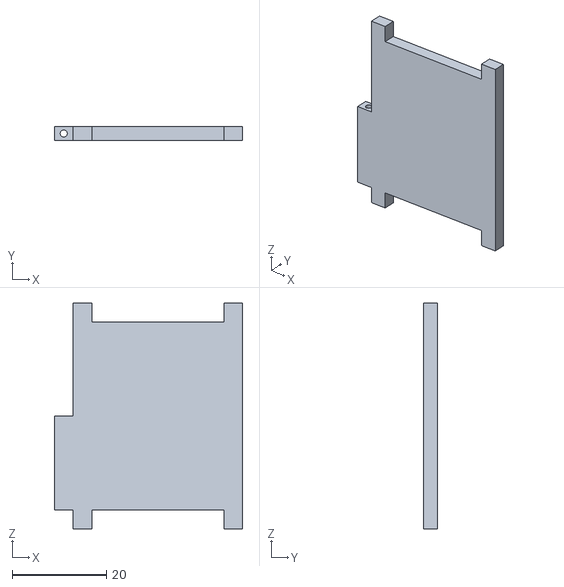
[picture p55: CAD file, 2023-02-19]
construction/STL/try1.stl
40.0 x 3.00 x 48.0
