cansat-tsniimash/KNPN-2023/construction/STL/sp-1.stl

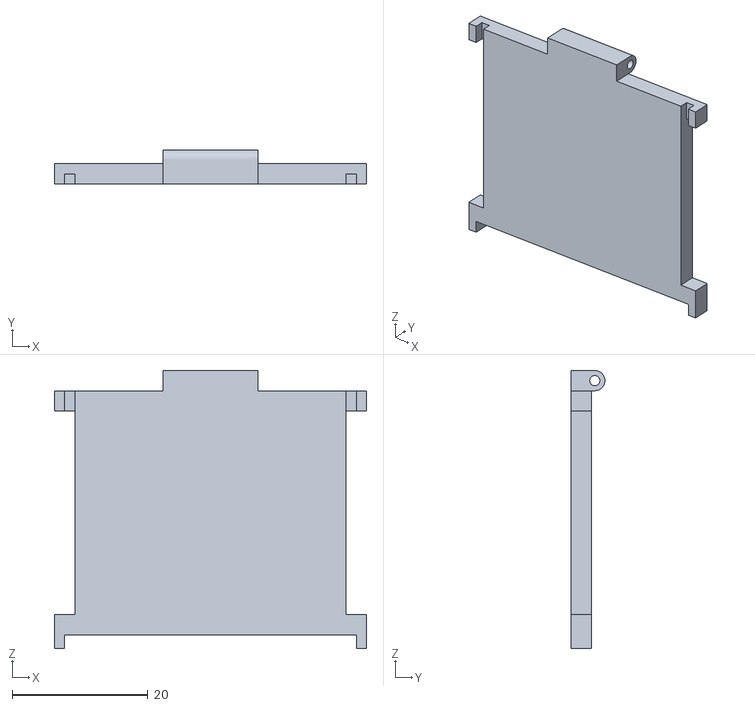
[picture p56: CAD file, 2023-02-19]
construction/STL/sp-1.stl
46.0 x 5.00 x 41.0
