cansat-tsniimash/KNPN-2023/construction/STL/sp-2.stl

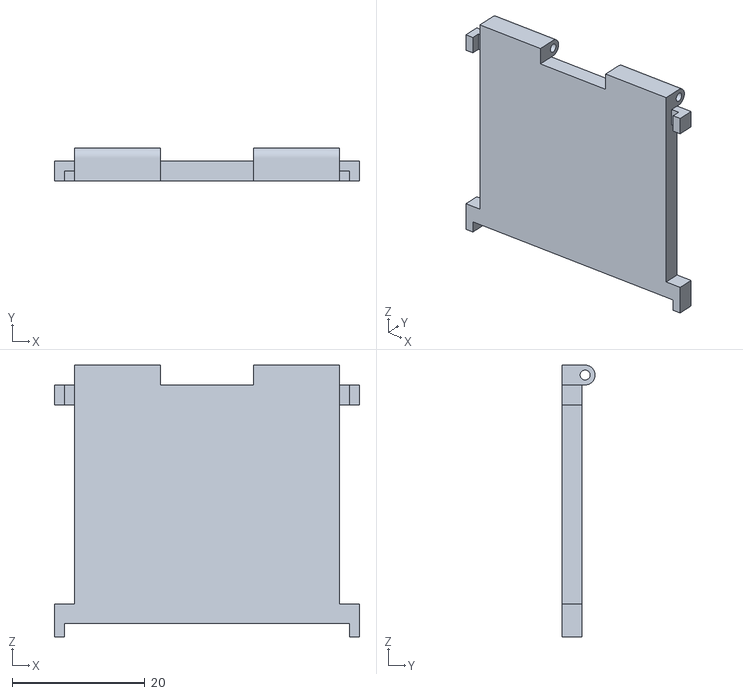
[picture p57: CAD file, 2023-02-19]
construction/STL/sp-2.stl
46.0 x 5.00 x 41.0
