cansat-tsniimash/KNPN-2023/construction/STL/sp_plata.stl

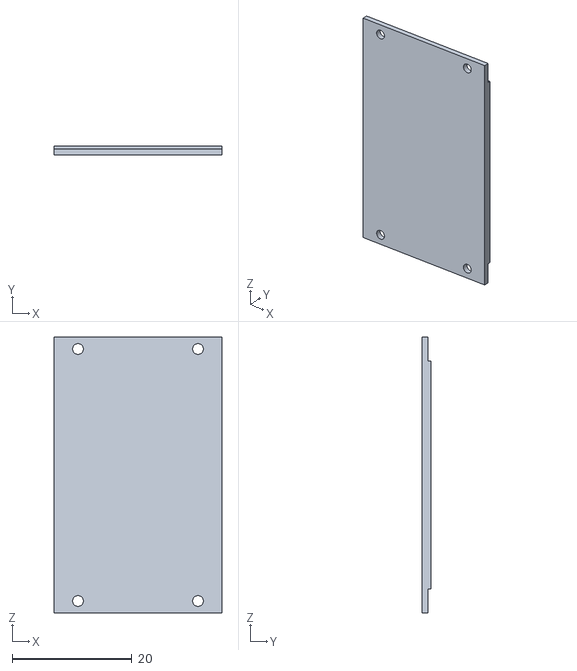
[picture p58: CAD file, 2023-02-19]
construction/STL/sp_plata.stl
28.0 x 1.50 x 46.0
