cansat-tsniimash/KNPN-2023/(list of files, cad)

Other CAD files:
construction/Sat/print/sp_krepezh_plata1.stl
construction/Sat/print/gear_motor_2axis.stl
construction/Sat/print/parachut_perezhigatel.stl
construction/STL/blinchik-down_1_final.stl
construction/STL/sp_krepezh_plata2.stl
construction/STL/gear_motor_2axis.stl
construction/STL/gear_motor_2axis_min.stl
construction/STL/blinchik-down_1.stl
construction/STL/kreplenie_motor_i_akkum_niz.stl
construction/Sat/ad5593.prt
construction/Sat/ads1115.prt
construction/Sat/akkum_18350.prt
construction/Sat/battery_holder.prt
construction/Sat/beacon_mini_rockwell_ibeacon.prt
construction/Sat/blin_up.prt
construction/Sat/blinchik-down.prt
construction/Sat/blinchik-down_1.prt
construction/Sat/blinchik-down_1_low.prt
construction/Sat/blinchik-down_2.prt
construction/Sat/blinchik_for_kreplenie-old.prt
construction/Sat/blinchik_for_kreplenie.prt
construction/Sat/blinchik_kernel.prt
construction/Sat/blinchik_kernel_up.prt
construction/Sat/box.prt
construction/Sat/button.prt
construction/Sat/buzzer.prt
construction/Sat/camera-sq11.prt
construction/Sat/cilindr.prt
construction/Sat/connector-pbs-24r.prt
construction/Sat/connector_b2b-eh-a.prt
construction/Sat/dc-dc_12v.prt
construction/Sat/detal_vrashenie.prt
construction/Sat/detal_vrashenie_w_spring.prt
construction/Sat/disk.prt
construction/Sat/encoder_3315c-101-016l.prt
construction/Sat/es_board.prt
construction/Sat/ftoroplast-botom.prt
construction/Sat/ftoroplast-top.prt
construction/Sat/gear-bot-big.prt
construction/Sat/gear-bot-small.prt
construction/Sat/gear-top-big.prt
construction/Sat/gear-top-small.prt
construction/Sat/gear_encoder.prt
construction/Sat/gear_motor_2axis.prt
construction/Sat/ina219_korpus.prt
construction/Sat/irf7905.prt
construction/Sat/kernel_1mm_10mm.prt
construction/Sat/kernel_2mm.prt
construction/Sat/kernel_2mm_down.prt
construction/Sat/kernel_2mm_rezba.prt
construction/Sat/kernel_2mm_up.prt
construction/Sat/kernel_long.prt
construction/Sat/korotki kernel.prt
construction/Sat/kreplenie_2osi_motot.prt
construction/Sat/kreplenie_akkum.prt
construction/Sat/kreplenie_camera.prt
construction/Sat/kreplenie_mayak.prt
construction/Sat/kreplenie_motor_2axis.prt
construction/Sat/kreplenie_motor_i_akkum_niz.prt
construction/Sat/kreplenie_motor_i_akkum_niz_2.prt
construction/Sat/kreplenie_plata.prt
construction/Sat/krishka_akkum.prt
construction/Sat/krug-up.prt
construction/Sat/mayak_lime.prt
construction/Sat/mayak_onyx.prt
construction/Sat/motor-1axis.prt
construction/Sat/motor-2axis.prt
construction/Sat/motor-reductor.prt
construction/Sat/parachut_gps.prt
construction/Sat/parachut_gps.stl
construction/Sat/parachut_perezhigatel.prt
construction/Sat/parachut_perezhigatel.stl
construction/Sat/parashut.prt
construction/Sat/plata_dop.prt
construction/Sat/plata_mtr.prt
construction/Sat/podshipnik.prt
construction/Sat/prt0003.prt
construction/Sat/razem_2pin.prt
construction/Sat/razem_3pin.prt
construction/Sat/razem_bolshoi_dlya_dop_platu.prt
construction/Sat/si2302.prt
construction/Sat/si2302_ao3407a.prt
construction/Sat/sp-1.prt
construction/Sat/sp-2.prt
construction/Sat/sp_base.prt
construction/Sat/sp_kernel_1mm_39mm.prt
construction/Sat/sp_krepezh_plata1-wide.prt
construction/Sat/sp_krepezh_plata1.prt
construction/Sat/sp_krepezh_plata2-wide.prt
construction/Sat/sp_krepezh_plata2.prt
construction/Sat/sp_krepezh_plata_motor-wide.prt
construction/Sat/sp_krepezh_plata_motor.prt
construction/Sat/sp_kreplenie.prt
construction/Sat/sp_kreplenie_old.prt
construction/Sat/sp_kron_base.prt
construction/Sat/sp_plata.prt
construction/Sat/sp_plata_old.prt
construction/Sat/sp_shtanga.prt
construction/Sat/sp_stik1.prt
construction/Sat/sp_stik2.prt
construction/Sat/sp_try1.prt
construction/Sat/sp_try2.prt
construction/Sat/sp_zaglushka-wide.prt
construction/Sat/sp_zaglushka.prt
construction/Sat/sp_zaglushka.stl
construction/Sat/spring_0_4x2_4x19_6.prt
construction/Sat/spring_0_5x3_5x180deg_6turns.prt
construction/Sat/spring_0_5x3_6x180deg_12turns.prt
construction/Sat/spring_0_6x4x180deg_12turns.prt
construction/Sat/spring_0_6x5x180deg_5turns.prt
construction/Sat/spring_0_8x5x180deg_4turns.prt
construction/Sat/spring_1x5x180deg_6turns.prt
construction/Sat/svetodiod.prt
construction/Sat/switch_ss-12d10.prt
construction/Sat/switch_ss-12d11.prt
construction/Sat/tube.prt
construction/Sat/tube_15mm.prt
construction/Sat/tube_26mm.prt
construction/Sat/tube_4mm.prt
construction/Sat/tube_7mm.prt
construction/Sat/tube_9mm.prt
construction/Sat/vt93n1.prt
construction/Модели устройств в Creo/10dof_imu_sensor.prt
construction/Модели устройств в Creo/air-valve.prt
construction/Модели устройств в Creo/antenna_2_4ghz.prt
construction/Модели устройств в Creo/antenna_gps-slim.prt
construction/Модели устройств в Creo/barometer_bmp280_module.prt
construction/Модели устройств в Creo/barometr-ms5611.prt
construction/Модели устройств в Creo/battery_li-pol_lp443442.prt
construction/Модели устройств в Creo/battery_li-pol_lp603450.prt
construction/Модели устройств в Creo/beacon_mini_rockwell_ibeacon.prt
construction/Модели устройств в Creo/bluetooth_hc-05.prt
construction/Модели устройств в Creo/bme280_module.prt
construction/Модели устройств в Creo/camera_sq13.prt
construction/Модели устройств в Creo/connector-pbd-20r.prt
construction/Модели устройств в Creo/connector-pbs-14r.prt
construction/Модели устройств в Creo/connector-pls-20.prt
construction/Модели устройств в Creo/connector-pls-4.prt
construction/Модели устройств в Creo/connector-pls-6.prt
construction/Модели устройств в Creo/connector_usb-type-c.prt
construction/Модели устройств в Creo/dc-dc-boost-converter_u007v.prt
construction/Модели устройств в Creo/dc-dc-boost-converter_xl6019.prt
construction/Модели устройств в Creo/dc-dc-buck-converter_d068v.prt
construction/Модели устройств в Creo/dcdc-lowering.prt
construction/Модели устройств в Creo/dosimeter.prt
construction/Модели устройств в Creo/end-sensor_kw11-3z.prt
construction/Модели устройств в Creo/gcs_battery-indicator.prt
construction/Модели устройств в Creo/gps_antenna.prt
construction/Модели устройств в Creo/gps_ublox_neo-6m.prt
construction/Модели устройств в Creo/gps_ublox_neo-7m-0-000.prt
construction/Модели устройств в Creo/gy-lsm6ds3_lsm6ds3.prt
construction/Модели устройств в Creo/ir-photodiode_bpv23nf.prt
construction/Модели устройств в Creo/kompressor-528.prt
construction/Модели устройств в Creo/li-ion-cell_imr26650.prt
construction/Модели устройств в Creo/li-ion-cell_inr18650-25r.prt
construction/Модели устройств в Creo/magnetometer_lis3mdl.prt
construction/Модели устройств в Creo/micro-sd_module_robotdyn.prt
construction/Модели устройств в Creo/microkontroller_esp32-wroom.prt
construction/Модели устройств в Creo/microsd_connector_502774-0891.prt
construction/Модели устройств в Creo/mics-6814.prt
construction/Модели устройств в Creo/motor-reductor.prt
construction/Модели устройств в Creo/onboard-antenna-433mhz.prt
construction/Модели устройств в Creo/oxigen-sensor_me2-o2-f20.prt
construction/Модели устройств в Creo/photoresistor_vt93n1.prt
construction/Модели устройств в Creo/radio-module_nrf24l01.prt
construction/Модели устройств в Creo/radio-mudule-e01-ml01dp5.prt
construction/Модели устройств в Creo/rasberry-pi_zero_w.prt
construction/Модели устройств в Creo/servo_mg90s.prt
construction/Модели устройств в Creo/servo_pz-15320.prt
construction/Модели устройств в Creo/spring_1x5x180deg_6turns.prt
construction/Модели устройств в Creo/step-motor_sy20sth30-0604a.prt
construction/Модели устройств в Creo/stm32-h405.prt
construction/Модели устройств в Creo/wireless_module_e22-400t30s.prt
construction/Модели устройств в Creo/xq_02a_usilitel.prt
