cansat-tsniimash/KNPN-2023/test/01.07.23 1/knpn_1.csv

Time Pack | Number | Temp BME | Pressure | Height BME | Current" | Bus voltage | State | Photo
366 | 1 | 2583 | 97178 | -0.09298974275588989 | 0.0 | 931 | 0 | 0
443 | 2 | 2585 | 97178 | -0.15323473513126373 | 0.6750860214233398 | 915 | 0 | 0
520 | 3 | 2588 | 97178 | -0.16668082773685455 | 0.6750860214233398 | 915 | 0 | 142
597 | 4 | 2590 | 97179 | -0.19046956300735474 | 0.6750860214233398 | 915 | 0 | 826
725 | 5 | 2595 | 97179 | -0.18096841871738434 | 0.6750860214233398 | 915 | 0 | 2003
802 | 6 | 2598 | 97179 | -0.23017695546150208 | 0.6750860214233398 | 915 | 0 | 1104
879 | 7 | 2601 | 97179 | -0.2462654560804367 | 0.6750860214233398 | 915 | 0 | 1130
956 | 8 | 2603 | 97180 | -0.28782451152801514 | 0.6750860214233398 | 915 | 0 | 567
1094 | 9 | 2608 | 97180 | -0.3205139935016632 | 0.6750860214233398 | 915 | 0 | 850
1171 | 10 | 2610 | 97181 | -0.36646899580955505 | 0.6750860214233398 | 915 | 0 | 2743
1248 | 11 | 2612 | 97181 | -0.3548402488231659 | 0.6750860214233398 | 915 | 0 | 4936
1325 | 12 | 2613 | 97181 | -0.35732901096343994 | 0.6750860214233398 | 915 | 0 | 7183
1453 | 13 | 2616 | 97180 | -0.34673038125038147 | 0.6750860214233398 | 915 | 0 | 8858
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
