cansat-tsniimash/KNPN-2023/test/01.07.23 1/knpn_2.csv

Time Pack | Number | Mag x | Mag y | Mag z | Accel x | Accel y | Accel z | Gyro x | Gyro y | Gyro z
392 | 1 | 499 | -67 | -259 | 947 | -860 | 23 | -24042 | -31462 | 17716
469 | 2 | 377 | -133 | -279 | 798 | -998 | 80 | -5880 | -12406 | -18808
546 | 3 | 292 | -177 | -278 | 566 | -946 | 8 | -25270 | -31376 | 17328
623 | 4 | 206 | -202 | -248 | 462 | -1003 | -153 | -11814 | -23940 | 32114
751 | 5 | 75 | -147 | -138 | 273 | -1127 | -157 | 15502 | 25200 | 17134
828 | 6 | 39 | -110 | -63 | 218 | -1117 | -2 | 20682 | -16536 | 9504
905 | 7 | 39 | -77 | -2 | 108 | -1222 | -93 | 17866 | 4394 | 15750
982 | 8 | 73 | -71 | 14 | 116 | -1314 | 71 | 2940 | 21124 | 20020
1120 | 9 | 141 | -82 | 14 | 132 | -1129 | -183 | -14576 | 23154 | 15470
1197 | 10 | 193 | -134 | -37 | 255 | -1171 | -245 | -24252 | 17694 | -30326
1274 | 11 | 208 | -185 | -104 | 265 | -1013 | -183 | 11744 | -3166 | 14420
1351 | 12 | 230 | -209 | -188 | 205 | -878 | -202 | 13284 | -5546 | -7210
1479 | 13 | 287 | -186 | -268 | 134 | -804 | -253 | -32706 | 26250 | 5110
1556 | 14 | 291 | -184 | -275 | 147 | -1042 | -421 | 1540 | -1540 | 18690
1633 | 15 | 278 | -192 | -247 | 47 | -1146 | -358 | -1524 | -15190 | 6580
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
