cansat-tsniimash/KNPN-2023/test/01.07.23 1/knpn_3.csv

Time Pack | Number | Temp DS | Latitude | Longitude | Height | Time, s | Time, mks | Fix
674 | 1 | -18328 | 0.0 | 0.0 | 0.0 | 0 | 0 | 0
1033 | 2 | -18328 | 0.0 | 0.0 | 0.0 | 0 | 0 | 0
1402 | 3 | 26 | 0.0 | 0.0 | 0.0 | 0 | 0 | 0
1761 | 4 | 26 | nan | nan | nan | 4294963635 | 4294967295 | 0
2129 | 5 | 26 | nan | nan | nan | 4294963635 | 4294967295 | 0
2488 | 6 | 26 | nan | nan | nan | 4294963635 | 4294967295 | 0
2857 | 7 | 30 | nan | nan | nan | 4294963635 | 4294967295 | 0
3216 | 8 | 30 | nan | nan | nan | 4294963635 | 4294967295 | 0
3585 | 9 | 26 | nan | nan | nan | 4294963635 | 4294967295 | 0
3944 | 10 | 26 | nan | nan | nan | 4294963635 | 4294967295 | 0
4312 | 11 | 26 | nan | nan | nan | 4294963635 | 4294967295 | 0
4671 | 12 | 26 | nan | nan | nan | 4294963635 | 4294967295 | 0
5040 | 13 | 26 | nan | nan | nan | 4294963635 | 4294967295 | 0
5399 | 14 | 26 | nan | nan | nan | 4294963635 | 4294967295 | 0
5768 | 15 | 26 | nan | nan | nan | 4294963635 | 4294967295 | 0
6127 | 16 | 26 | nan | nan | nan | 4294963635 | 4294967295 | 0
6486 | 17 | 26 | nan | nan | nan | 4294963635 | 4294967295 | 0
6855 | 18 | 26 | nan | nan | nan | 4294963635 | 4294967295 | 0
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
