cansat-tsniimash/KNPN-2023/test/01.07.23 2/knpn_1.csv

Time Pack | Number | Temp BME | Pressure | Height BME | Current" | Bus voltage | State | Photo
585 | 1 | 2535 | 97174 | -0.06149989366531372 | 0.6750860214233398 | 915 | 0 | 811
678 | 2 | 2539 | 97175 | -0.10927756875753403 | 0.6750860214233398 | 915 | 0 | 145
764 | 3 | 2542 | 97175 | -0.16175240278244019 | 0.6750860214233398 | 915 | 0 | 0
844 | 4 | 2545 | 97176 | -0.17557300627231598 | 0.6750860214233398 | 915 | 0 | 0
984 | 5 | 2550 | 97176 | -0.21513764560222626 | 0.6750860214233398 | 915 | 0 | 222
1066 | 6 | 2553 | 97176 | -0.23812730610370636 | 0.6750860214233398 | 915 | 0 | 198
1157 | 7 | 2556 | 97176 | -0.19166994094848633 | 0.6750860214233398 | 915 | 0 | 133
1238 | 8 | 2557 | 97175 | -0.1662435382604599 | 0.6750860214233398 | 915 | 0 | 247
1371 | 9 | 2560 | 97175 | -0.13270489871501923 | 0.6750860214233398 | 915 | 0 | 79
1455 | 10 | 2562 | 97175 | -0.13386701047420502 | 0.6750860214233398 | 915 | 0 | 123
1538 | 11 | 2564 | 97176 | -0.17411945760250092 | 0.6750860214233398 | 915 | 0 | 74
1625 | 12 | 2565 | 97176 | -0.17363449931144714 | 0.6750860214233398 | 915 | 0 | 57
1764 | 13 | 2567 | 97176 | -0.181255504488945 | 0.6750860214233398 | 915 | 0 | 12
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
