cansat-tsniimash/KNPN-2023/test/01.07.23 2/knpn_2.csv

Time Pack | Number | Mag x | Mag y | Mag z | Accel x | Accel y | Accel z | Gyro x | Gyro y | Gyro z
622 | 1 | 0 | 372 | -744 | 365 | 119 | 1047 | -6790 | -10990 | 26988
708 | 2 | 38 | 385 | -756 | 191 | -22 | 959 | 26826 | 22556 | -27978
794 | 3 | 81 | 390 | -766 | 305 | -175 | 972 | -490 | -18394 | -29136
875 | 4 | 119 | 396 | -776 | 420 | -203 | 949 | 8189 | -8540 | 30482
1014 | 5 | 87 | 382 | -762 | 418 | 21 | 969 | -1330 | 18270 | -24430
1105 | 6 | 72 | 385 | -767 | 355 | 18 | 976 | 14910 | 9870 | 10010
1187 | 7 | 68 | 384 | -764 | 340 | -22 | 1012 | 9730 | 11410 | -27090
1268 | 8 | 61 | 392 | -762 | 306 | -28 | 983 | 8400 | 11270 | -9240
1403 | 9 | 42 | 392 | -760 | 281 | 31 | 966 | 10500 | 7210 | -17430
1485 | 10 | 41 | 392 | -757 | 288 | 25 | 1007 | 4130 | -770 | 1330
1568 | 11 | 43 | 392 | -760 | 326 | 3 | 1001 | 1960 | -14140 | 10290
1658 | 12 | 50 | 394 | -758 | 301 | -2 | 936 | 2730 | -17710 | -30116
1794 | 13 | 64 | 394 | -762 | 353 | 16 | 1048 | 7210 | -15120 | -5250
1886 | 14 | 68 | 395 | -763 | 347 | 12 | 1016 | 1190 | 3920 | -10990
1967 | 15 | 60 | 393 | -760 | 348 | 14 | 1009 | -3710 | 16660 | -18550
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
