cansat-tsniimash/KNPN-2023/test/01.07.23 2/knpn_3.csv

Time Pack | Number | Temp DS | Latitude | Longitude | Height | Time, s | Time, mks | Fix
927 | 1 | -18360 | 0.0 | 0.0 | 0.0 | 0 | 0 | 0
1320 | 2 | 25 | 0.0 | 0.0 | 0.0 | 0 | 0 | 0
1712 | 3 | 25 | nan | nan | nan | 4294963635 | 4294967295 | 0
2100 | 4 | 25 | nan | nan | nan | 4294963635 | 4294967295 | 0
2490 | 5 | 25 | nan | nan | nan | 4294963635 | 4294967295 | 0
2882 | 6 | 25 | nan | nan | nan | 4294963635 | 4294967295 | 0
3270 | 7 | 25 | nan | nan | nan | 4294963635 | 4294967295 | 0
3663 | 8 | 25 | nan | nan | nan | 4294963635 | 4294967295 | 0
4046 | 9 | 25 | nan | nan | nan | 4294963635 | 4294967295 | 0
4442 | 10 | 25 | nan | nan | nan | 4294963635 | 4294967295 | 0
4820 | 11 | 25 | nan | nan | nan | 4294963635 | 4294967295 | 0
5214 | 12 | 25 | nan | nan | nan | 4294963635 | 4294967295 | 0
5588 | 13 | 25 | nan | nan | nan | 4294963635 | 4294967295 | 0
5988 | 14 | 25 | nan | nan | nan | 4294963635 | 4294967295 | 0
6372 | 15 | 25 | nan | nan | nan | 4294963635 | 4294967295 | 0
6763 | 16 | 27 | nan | nan | nan | 4294963635 | 4294967295 | 0
7146 | 17 | 27 | nan | nan | nan | 4294963635 | 4294967295 | 0
7535 | 18 | 25 | nan | nan | nan | 4294963635 | 4294967295 | 0
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
