cansat-tsniimash/KNPN-2023/test/01.07.23 3/knpn_1.csv

Time Pack | Number | Temp BME | Pressure | Height BME | Current" | Bus voltage | State | Photo
601 | 1 | 2680 | 97169 | -0.027496857568621635 | 0.6750860214233398 | 910 | 0 | 5824
715 | 2 | 2684 | 97169 | -0.05144987627863884 | 1.3501720428466797 | 910 | 0 | 6048
804 | 3 | 2687 | 97170 | -0.08839210867881775 | 1.3501720428466797 | 910 | 0 | 5804
887 | 4 | 2690 | 97170 | -0.11502091586589813 | 0.6750860214233398 | 910 | 0 | 5854
1031 | 5 | 2695 | 97170 | -0.16142287850379944 | 1.3501720428466797 | 910 | 0 | 5634
1122 | 6 | 2698 | 97171 | -0.21718516945838928 | 1.3501720428466797 | 910 | 0 | 5824
1204 | 7 | 2700 | 97172 | -0.2738795280456543 | 0.6750860214233398 | 910 | 0 | 5575
1285 | 8 | 2702 | 97172 | -0.27582383155822754 | 0.6750860214233398 | 910 | 0 | 5834
1420 | 9 | 2705 | 97172 | -0.3173685073852539 | 0.6750860214233398 | 910 | 0 | 5575
1504 | 10 | 2707 | 97172 | -0.3286722004413605 | 1.3501720428466797 | 910 | 0 | 6007
1590 | 11 | 2708 | 97172 | -0.332451194524765 | 1.3501720428466797 | 910 | 0 | 6255
1676 | 12 | 2709 | 97172 | -0.33622506260871887 | 0.6750860214233398 | 910 | 0 | 6172
1810 | 13 | 2711 | 97172 | -0.30317965149879456 | 1.3501720428466797 | 910 | 0 | 6079
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
