cansat-tsniimash/KNPN-2023/test/01.07.23 3/knpn_3.csv

Time Pack | Number | Temp DS | Latitude | Longitude | Height | Time, s | Time, mks | Fix
969 | 1 | -18360 | 0.0 | 0.0 | 0.0 | 0 | 0 | 0
1368 | 2 | 27 | 0.0 | 0.0 | 0.0 | 0 | 0 | 0
1758 | 3 | 27 | nan | nan | nan | 4294963635 | 4294967295 | 0
2148 | 4 | 27 | nan | nan | nan | 4294963635 | 4294967295 | 0
2532 | 5 | 27 | nan | nan | nan | 4294963635 | 4294967295 | 0
2962 | 6 | 27 | nan | nan | nan | 4294963635 | 4294967295 | 0
3355 | 7 | 27 | nan | nan | nan | 4294963635 | 4294967295 | 0
3781 | 8 | 27 | nan | nan | nan | 4294963635 | 4294967295 | 0
4166 | 9 | 27 | nan | nan | nan | 4294963635 | 4294967295 | 0
4562 | 10 | 27 | nan | nan | nan | 4294963635 | 4294967295 | 0
4949 | 11 | 27 | nan | nan | nan | 4294963635 | 4294967295 | 0
5350 | 12 | 27 | nan | nan | nan | 4294963635 | 4294967295 | 0
5754 | 13 | 27 | nan | nan | nan | 4294963635 | 4294967295 | 0
6140 | 14 | 27 | nan | nan | nan | 4294963635 | 4294967295 | 0
6531 | 15 | 27 | nan | nan | nan | 4294963635 | 4294967295 | 0
6920 | 16 | 27 | nan | nan | nan | 4294963635 | 4294967295 | 0
7314 | 17 | 27 | nan | nan | nan | 4294963635 | 4294967295 | 0
7696 | 18 | 27 | nan | nan | nan | 4294963635 | 4294967295 | 0
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
