cansat-tsniimash/KNPN-2023/test/02.07.23 1/knpn_1.csv

Time Pack | Number | Temp BME | Pressure | Height BME | Current" | Bus voltage | State | Photo
632 | 1 | 2920 | 97298 | -0.07805047184228897 | 0.6750860214233398 | 906 | 0 | 0
741 | 2 | 2925 | 97300 | -0.1739054173231125 | 0.6750860214233398 | 906 | 0 | 0
822 | 3 | 2928 | 97300 | -0.18467170000076294 | 0.6750860214233398 | 906 | 0 | 0
922 | 4 | 2931 | 97300 | -0.19816340506076813 | 0.6750860214233398 | 906 | 0 | 0
1066 | 5 | 2936 | 97300 | -0.17732134461402893 | 0.6750860214233398 | 906 | 0 | 0
1157 | 6 | 2939 | 97299 | -0.16700425744056702 | 0.6750860214233398 | 906 | 0 | 0
1239 | 7 | 2940 | 97300 | -0.21776182949543 | 0.6750860214233398 | 906 | 0 | 0
1322 | 8 | 2942 | 97300 | -0.24695055186748505 | 0.6750860214233398 | 906 | 0 | 0
1455 | 9 | 2944 | 97300 | -0.2483208328485489 | 0.6750860214233398 | 906 | 0 | 0
1538 | 10 | 2946 | 97300 | -0.2564888000488281 | 0.6750860214233398 | 906 | 0 | 0
1620 | 11 | 2948 | 97301 | -0.31621259450912476 | 0.6750860214233398 | 906 | 0 | 0
1701 | 12 | 2949 | 97301 | -0.2834493815898895 | 0.6750860214233398 | 906 | 0 | 0
1833 | 13 | 2950 | 97300 | -0.25123172998428345 | 0.6750860214233398 | 906 | 0 | 0
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
