cansat-tsniimash/KNPN-2023/test/02.07.23 1/knpn_2.csv

Time Pack | Number | Mag x | Mag y | Mag z | Accel x | Accel y | Accel z | Gyro x | Gyro y | Gyro z
672 | 1 | 198 | 257 | -946 | -205 | 3 | 994 | -18550 | -8189 | 6860
771 | 2 | 202 | 237 | -954 | -188 | -59 | 1028 | -10080 | -10290 | 4480
873 | 3 | 208 | 231 | -954 | -142 | -78 | 1058 | -10080 | -12880 | 1960
952 | 4 | 208 | 225 | -952 | -134 | -65 | 1023 | -2450 | 3430 | 3780
1106 | 5 | 198 | 212 | -950 | -166 | -74 | 1002 | -13510 | 910 | -3570
1187 | 6 | 193 | 202 | -952 | -160 | -147 | 1025 | -14770 | -70 | -8189
1269 | 7 | 198 | 198 | -948 | -161 | -153 | 1011 | -1540 | -1050 | -2380
1352 | 8 | 195 | 198 | -953 | -173 | -129 | 1018 | 910 | -1330 | -3920
1485 | 9 | 198 | 202 | -946 | -175 | -140 | 997 | 15330 | -18270 | -4270
1571 | 10 | 202 | 210 | -943 | -152 | -112 | 1033 | 20930 | -19810 | -2310
1652 | 11 | 216 | 216 | -946 | -140 | -44 | 1048 | -10500 | 1890 | -9730
1732 | 12 | 210 | 208 | -950 | -169 | -134 | 1039 | -28000 | 7910 | -18900
1874 | 13 | 210 | 187 | -939 | -157 | -183 | 1020 | 4480 | 1750 | -2870
1956 | 14 | 208 | 187 | -945 | -159 | -162 | 1024 | 6370 | 840 | -2100
2040 | 15 | 205 | 192 | -935 | -156 | -151 | 1023 | 1190 | -210 | -4760
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
