cansat-tsniimash/KNPN-2023/test/02.07.23 1/knpn_3.csv

Time Pack | Number | Temp DS | Latitude | Longitude | Height | Time, s | Time, mks | Fix
1004 | 1 | -18360 | 0.0 | 0.0 | 0.0 | 0 | 0 | 0
1403 | 2 | 29 | 0.0 | 0.0 | 0.0 | 0 | 0 | 0
1781 | 3 | 29 | nan | nan | nan | 4294963635 | 4294967295 | 0
2173 | 4 | 29 | nan | nan | nan | 4294963635 | 4294967295 | 0
2560 | 5 | 29 | nan | nan | nan | 4294963635 | 4294967295 | 0
2992 | 6 | 29 | nan | nan | nan | 4294963635 | 4294967295 | 0
3374 | 7 | 29 | nan | nan | nan | 4294963635 | 4294967295 | 0
3767 | 8 | 29 | nan | nan | nan | 4294963635 | 4294967295 | 0
4158 | 9 | 29 | nan | nan | nan | 4294963635 | 4294967295 | 0
4548 | 10 | 29 | nan | nan | nan | 4294963635 | 4294967295 | 0
4938 | 11 | 29 | nan | nan | nan | 4294963635 | 4294967295 | 0
5327 | 12 | 29 | nan | nan | nan | 4294963635 | 4294967295 | 0
5717 | 13 | 29 | nan | nan | nan | 4294963635 | 4294967295 | 0
6112 | 14 | 29 | nan | nan | nan | 4294963635 | 4294967295 | 0
6496 | 15 | 29 | nan | nan | nan | 4294963635 | 4294967295 | 0
6924 | 16 | 29 | nan | nan | nan | 4294963635 | 4294967295 | 0
7325 | 17 | 29 | nan | nan | nan | 4294963635 | 4294967295 | 0
7723 | 18 | 29 | nan | nan | nan | 4294963635 | 4294967295 | 0
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
