cansat-tsniimash/KNPN-2023/test/01.07.23 3/SD/file1.csv

flag | time_pak | n | temp_bme | press | height_bme | current | bus_voltage | state | photor | crc
170 | 601 | 1 | 2680 | 97169 | -0.027497 | 40.675086 | 910 | 0 | 5824 | 48328
170 | 715 | 2 | 2684 | 97169 | -0.051450 | 41.350172 | 910 | 0 | 6048 | 5269
170 | 804 | 3 | 2687 | 97170 | -0.088392 | 41.350172 | 910 | 0 | 5804 | 22693
170 | 887 | 4 | 2690 | 97170 | -0.115021 | 40.675086 | 910 | 0 | 5854 | 21921
170 | 1031 | 5 | 2695 | 97170 | -0.161423 | 41.350172 | 910 | 0 | 5634 | 23709
170 | 1122 | 6 | 2698 | 97171 | -0.217185 | 41.350172 | 910 | 0 | 5824 | 7452
170 | 1204 | 7 | 2700 | 97172 | -0.273880 | 40.675086 | 910 | 0 | 5575 | 14925
170 | 1285 | 8 | 2702 | 97172 | -0.275824 | 40.675086 | 910 | 0 | 5834 | 31018
170 | 1420 | 9 | 2705 | 97172 | -0.317369 | 40.675086 | 910 | 0 | 5575 | 36984
170 | 1504 | 10 | 2707 | 97172 | -0.328672 | 41.350172 | 910 | 0 | 6007 | 1579
170 | 1590 | 11 | 2708 | 97172 | -0.332451 | 41.350172 | 910 | 0 | 6255 | 11801
170 | 1676 | 12 | 2709 | 97172 | -0.336225 | 40.675086 | 910 | 0 | 6172 | 48607
170 | 1810 | 13 | 2711 | 97172 | -0.303180 | 41.350172 | 910 | 0 | 6079 | 24200
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
