cansat-tsniimash/KNPN-2023/test/01.07.23 3/SD/file2.csv

flag | time_pak | n | lis_x | lis_y | lis_z | lsm_a_x | lsm_a_y | lsm_a_z | lsm_g_x | lsm_g_y | lsm_g_z | crc
187 | 749 | 2 | 169 | 435 | -1018 | -21 | 0 | 1036 | 2240 | -3500 | -280 | 30875
187 | 836 | 3 | 169 | 432 | -1020 | -27 | -6 | 1036 | 2170 | -3570 | -350 | 47628
187 | 917 | 4 | 171 | 435 | -1019 | -37 | -23 | 1043 | 1890 | -3430 | -350 | 58245
187 | 1061 | 5 | 167 | 434 | -1018 | -27 | -4 | 1038 | 1890 | -3290 | -210 | 34833
187 | 1152 | 6 | 170 | 438 | -1015 | -23 | -2 | 1039 | 1960 | -3500 | -420 | 9425
187 | 1234 | 7 | 165 | 437 | -1011 | -35 | -12 | 1039 | 2030 | -3220 | -350 | 46024
187 | 1316 | 8 | 168 | 436 | -1016 | -28 | -14 | 1038 | 2170 | -3850 | -280 | 45292
187 | 1451 | 9 | 170 | 436 | -1021 | -21 | -2 | 1040 | 1820 | -3290 | -280 | 3413
187 | 1534 | 10 | 169 | 430 | -1015 | -32 | -11 | 1040 | 1890 | -3640 | -350 | 3287
187 | 1623 | 11 | 170 | 433 | -1018 | -30 | -17 | 1038 | 2100 | -3640 | -350 | 22436
187 | 1706 | 12 | 173 | 438 | -1018 | -27 | -17 | 1036 | 1750 | -3430 | -420 | 20083
187 | 1931 | 14 | 177 | 435 | -1017 | -28 | -6 | 1042 | 1820 | -3500 | -420 | 8880
187 | 2013 | 15 | 172 | 433 | -1019 | -33 | -15 | 1040 | 1820 | -3290 | -350 | 55964
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
