cansat-tsniimash/KNPN-2023/schematics/плата dop.pdf

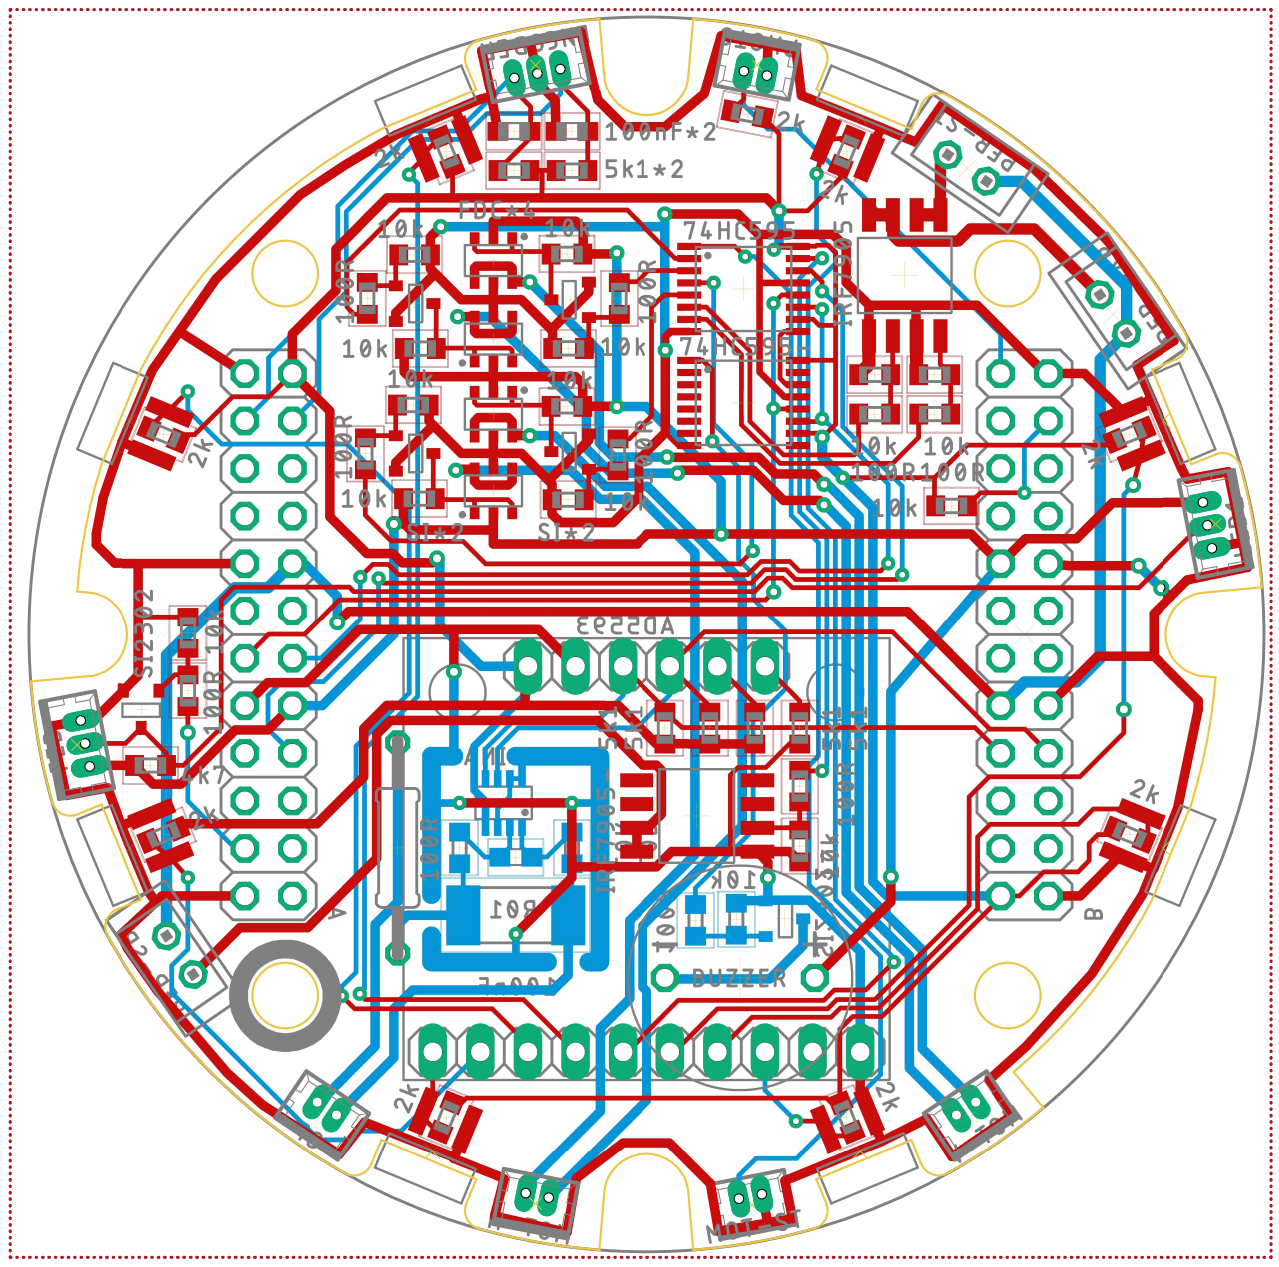
[picture p59: page 1]
