cansat-tsniimash/KNPN-2023/schematics/плата mtr.pdf

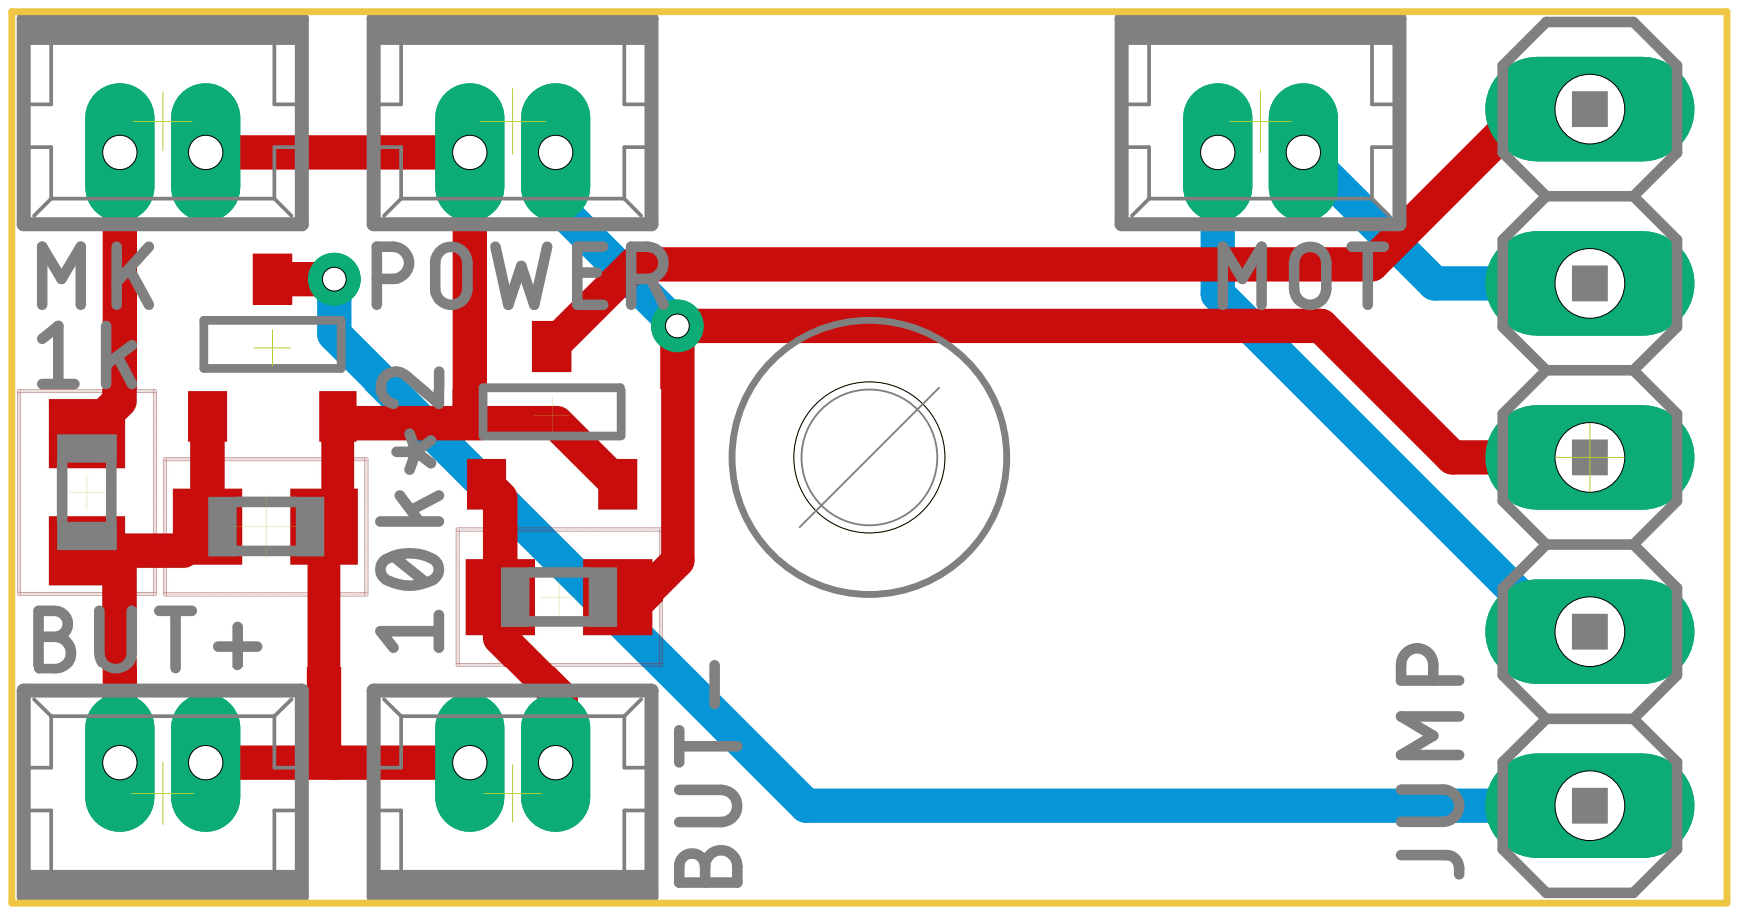
[picture p60: page 1]
