cansat-tsniimash/KNPN-2023/schematics/схема dop.pdf

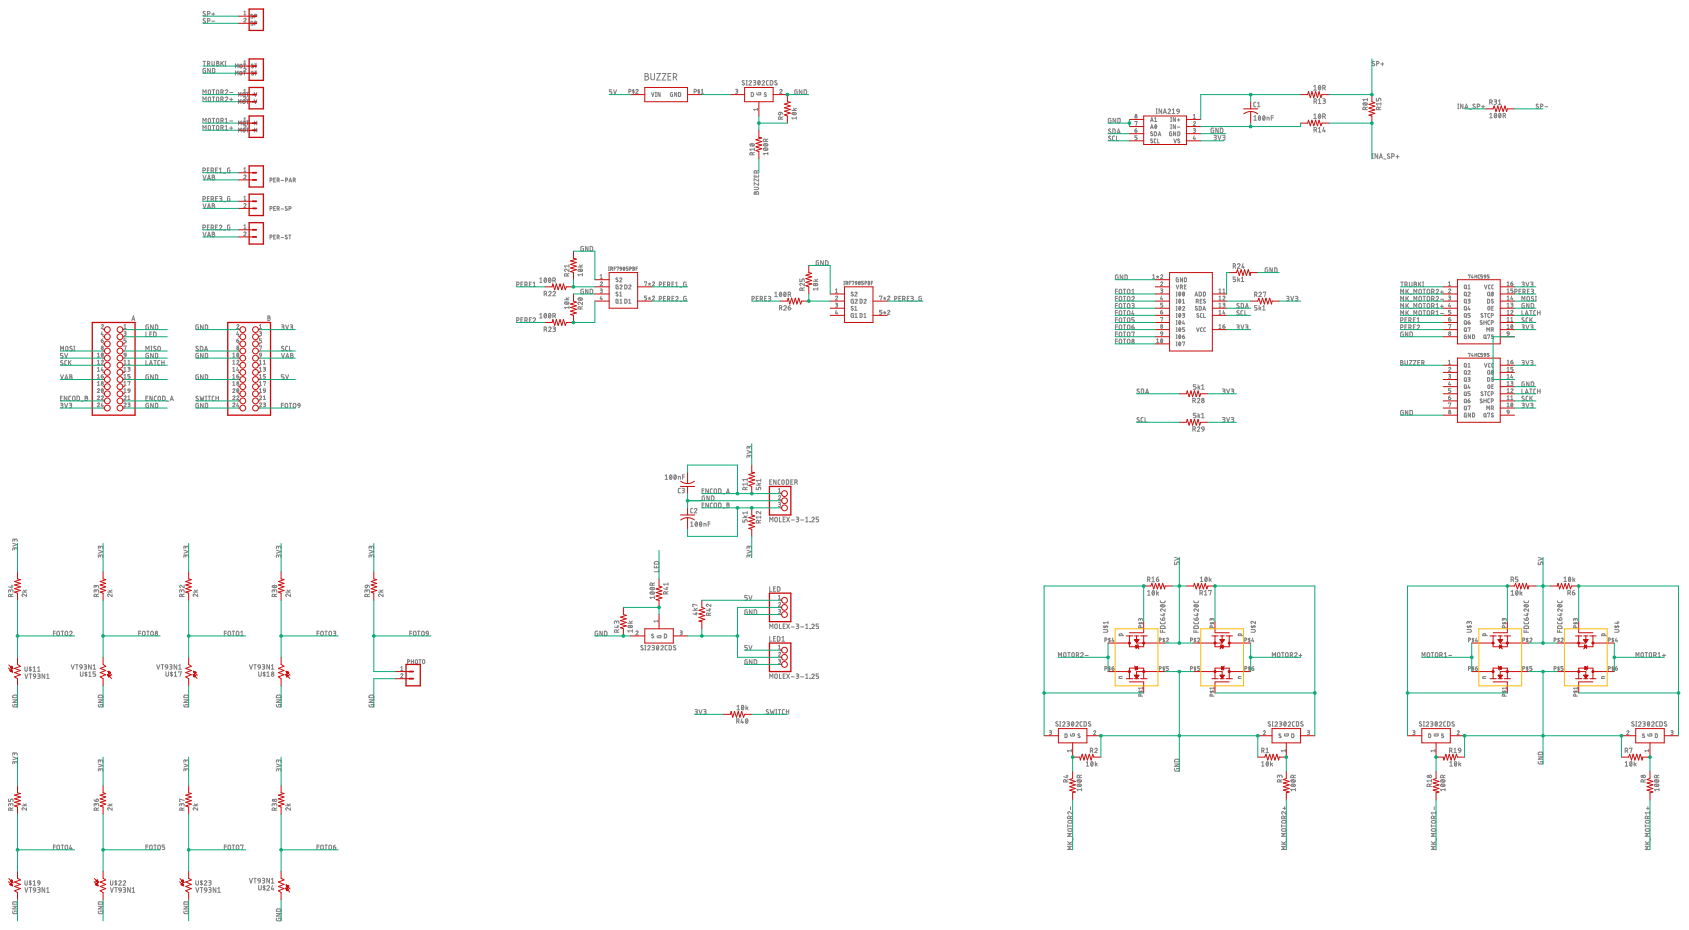
[picture p61: page 1]
