cansat-tsniimash/KNPN-2023/schematics/схема mtr.pdf

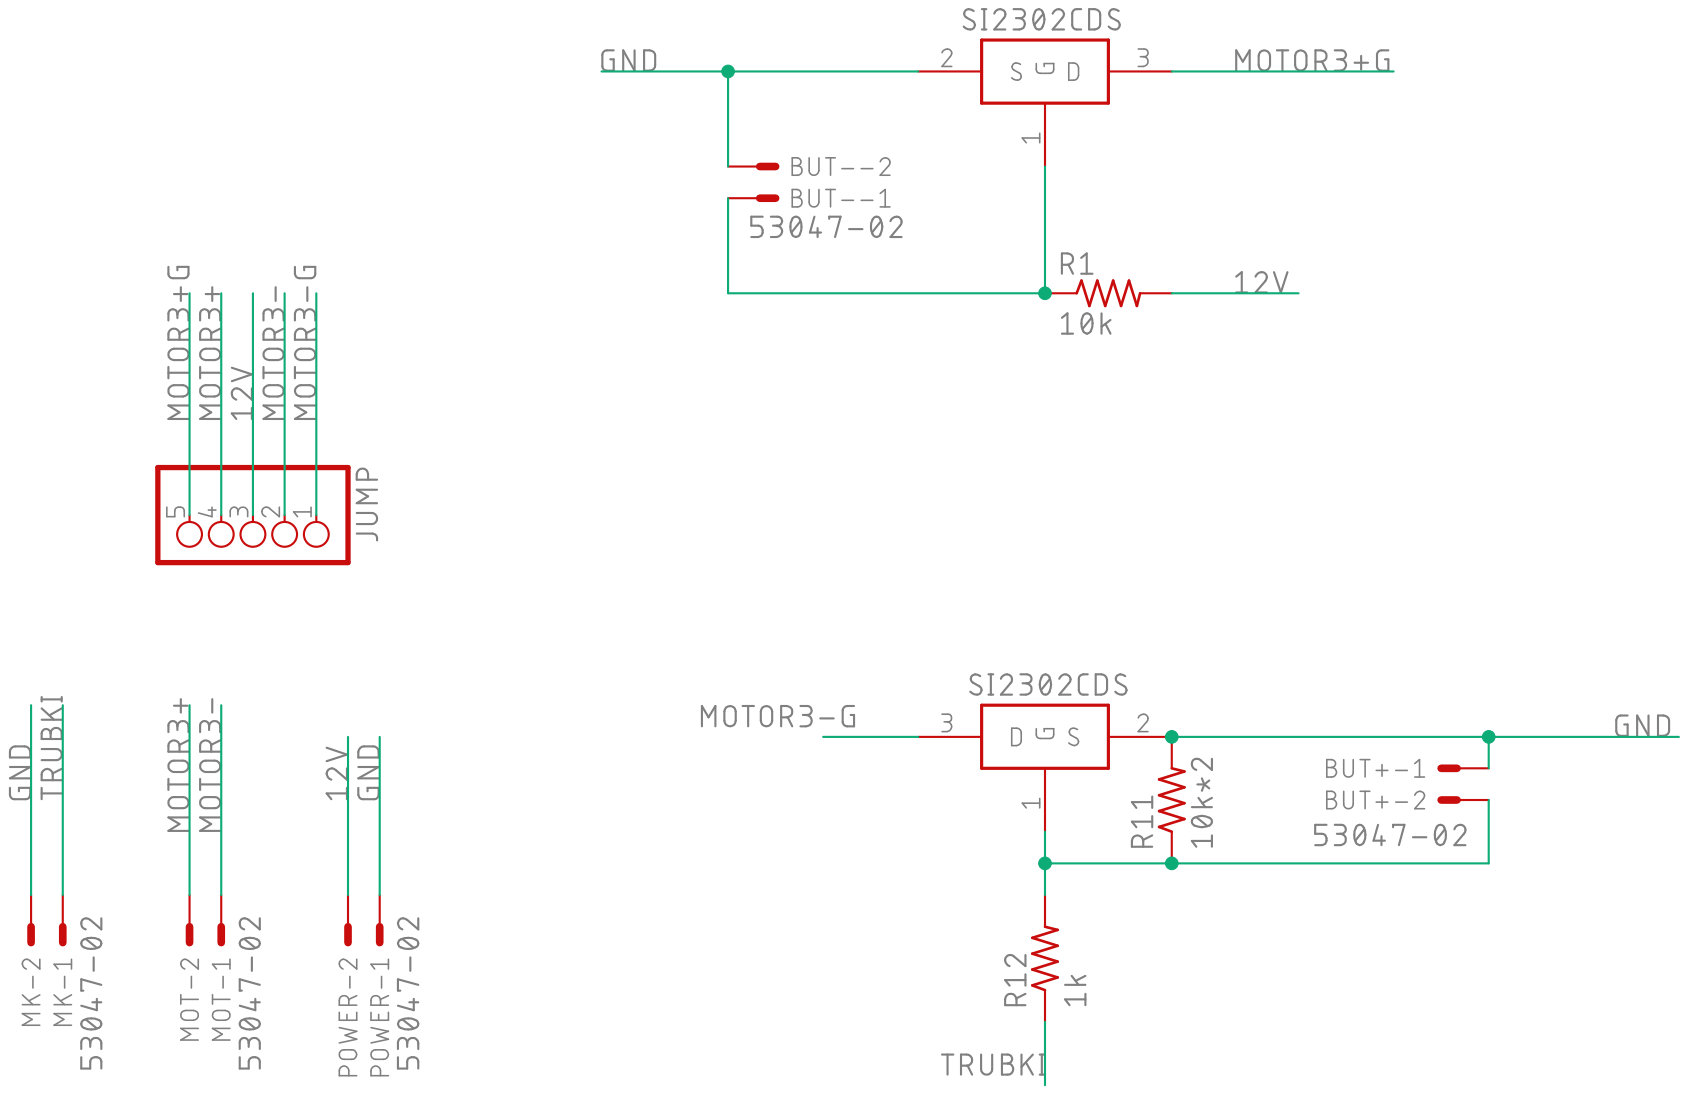
[picture p62: page 1]
