cansat-tsniimash/KNPN-2023/construction/КНПН.0000-0.pdf

## Утв. Формат

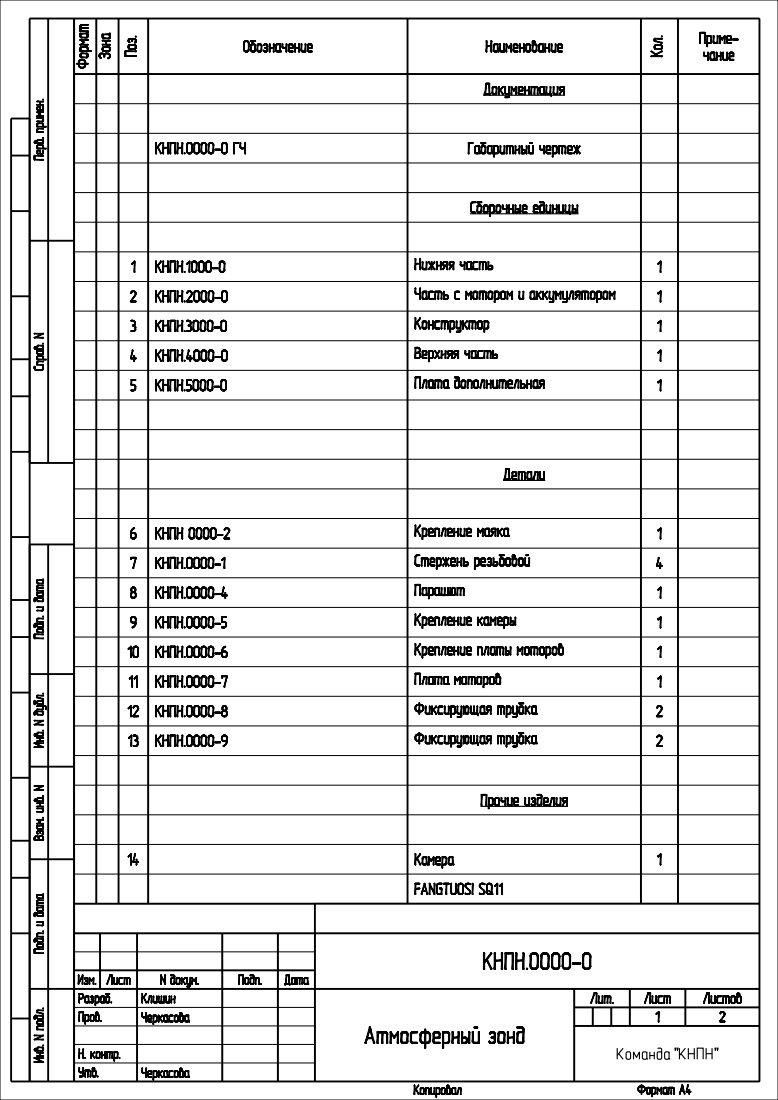
[picture p63: page 1]
Копировал; Формат А4; Черкасова; КНПН.0000-0 ГЧ; Габаритный чертеж; Сборочные единицы; Детали; Прочие изделия; Н. контр.; Команда "КНПН"; Зона; Поз.; Кол.

Обозначение | Наименование | Приме-чание

Документация

Инв. N подл. Подп. и дата Взам. инв. N Инв. N дубл. Подп. и дата Справ. N Перв. примен.

1 | КНПН.1000-0 | Нижняя часть | 1
2 | КНПН.2000-0 | Часть с мотором и аккумулятором | 1
3 | КНПН.3000-0 | Конструктор | 1
4 | КНПН.4000-0 | Верхняя часть | 1
5 | КНПН.5000-0 | Плата дополнительная | 1

6 | КНПН 0000-2 | Крепление маяка | 1
7 | КНПН.0000-1 | Стержень резьбовой | 4
8 | КНПН.0000-4 | Парашют | 1
9 | КНПН.0000-5 | Крепление камеры | 1
10 | КНПН.0000-6 | Крепление платы моторов | 1
11 | КНПН.0000-7 | Плата моторов | 1
12 | КНПН.0000-8 | Фиксирующая трубка | 2
13 | КНПН.0000-9 | Фиксирующая трубка | 2

14 | Камера | 1

FANGTUOSI SQ11

КНПН.0000-0

Изм. | Лист | N докум. | Подп. | Дата
Разраб. | Клишин | | Атмосферный зонд | Лит. | Лист | Листов
Пров. | Черкасова | | | | | | 1 | 2

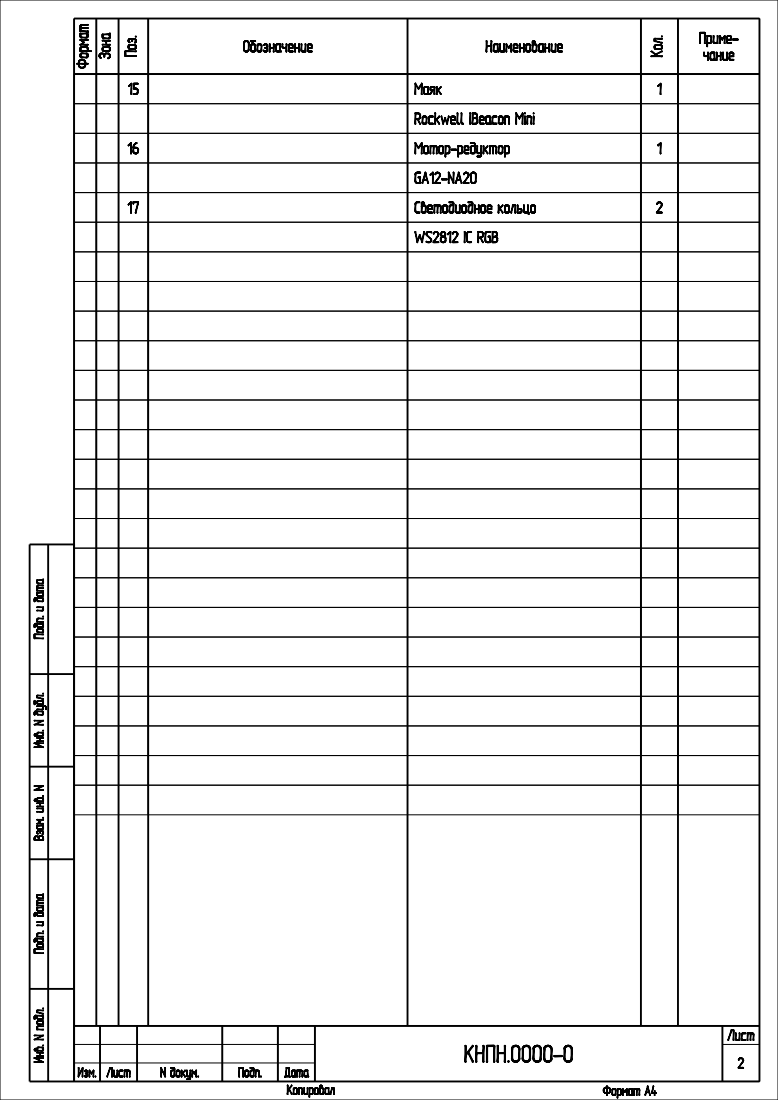
[picture p64: page 2]
Копировал; Формат А4; КНПН.0000-0; Лист; 2 Изм.; N докум.; Подп.; Дата; Формат; Зона; Поз.; Кол.

Обозначение | Наименование | | Приме-чание

15 | | Маяк | 1

Rockwell IBeacon Mini

16 | | Мотор-редуктор | 1

17 | | Светодиодное кольцо | 2

WS2812 IC RGB

Инв. N подл. Подп. и дата Взам. инв. N Инв. N дубл. Подп. и дата
