cansat-tsniimash/KNPN-2023/construction/КНПН.0000-0ГЧ.pdf

# Атмосферный зонд в транспортном состоянии

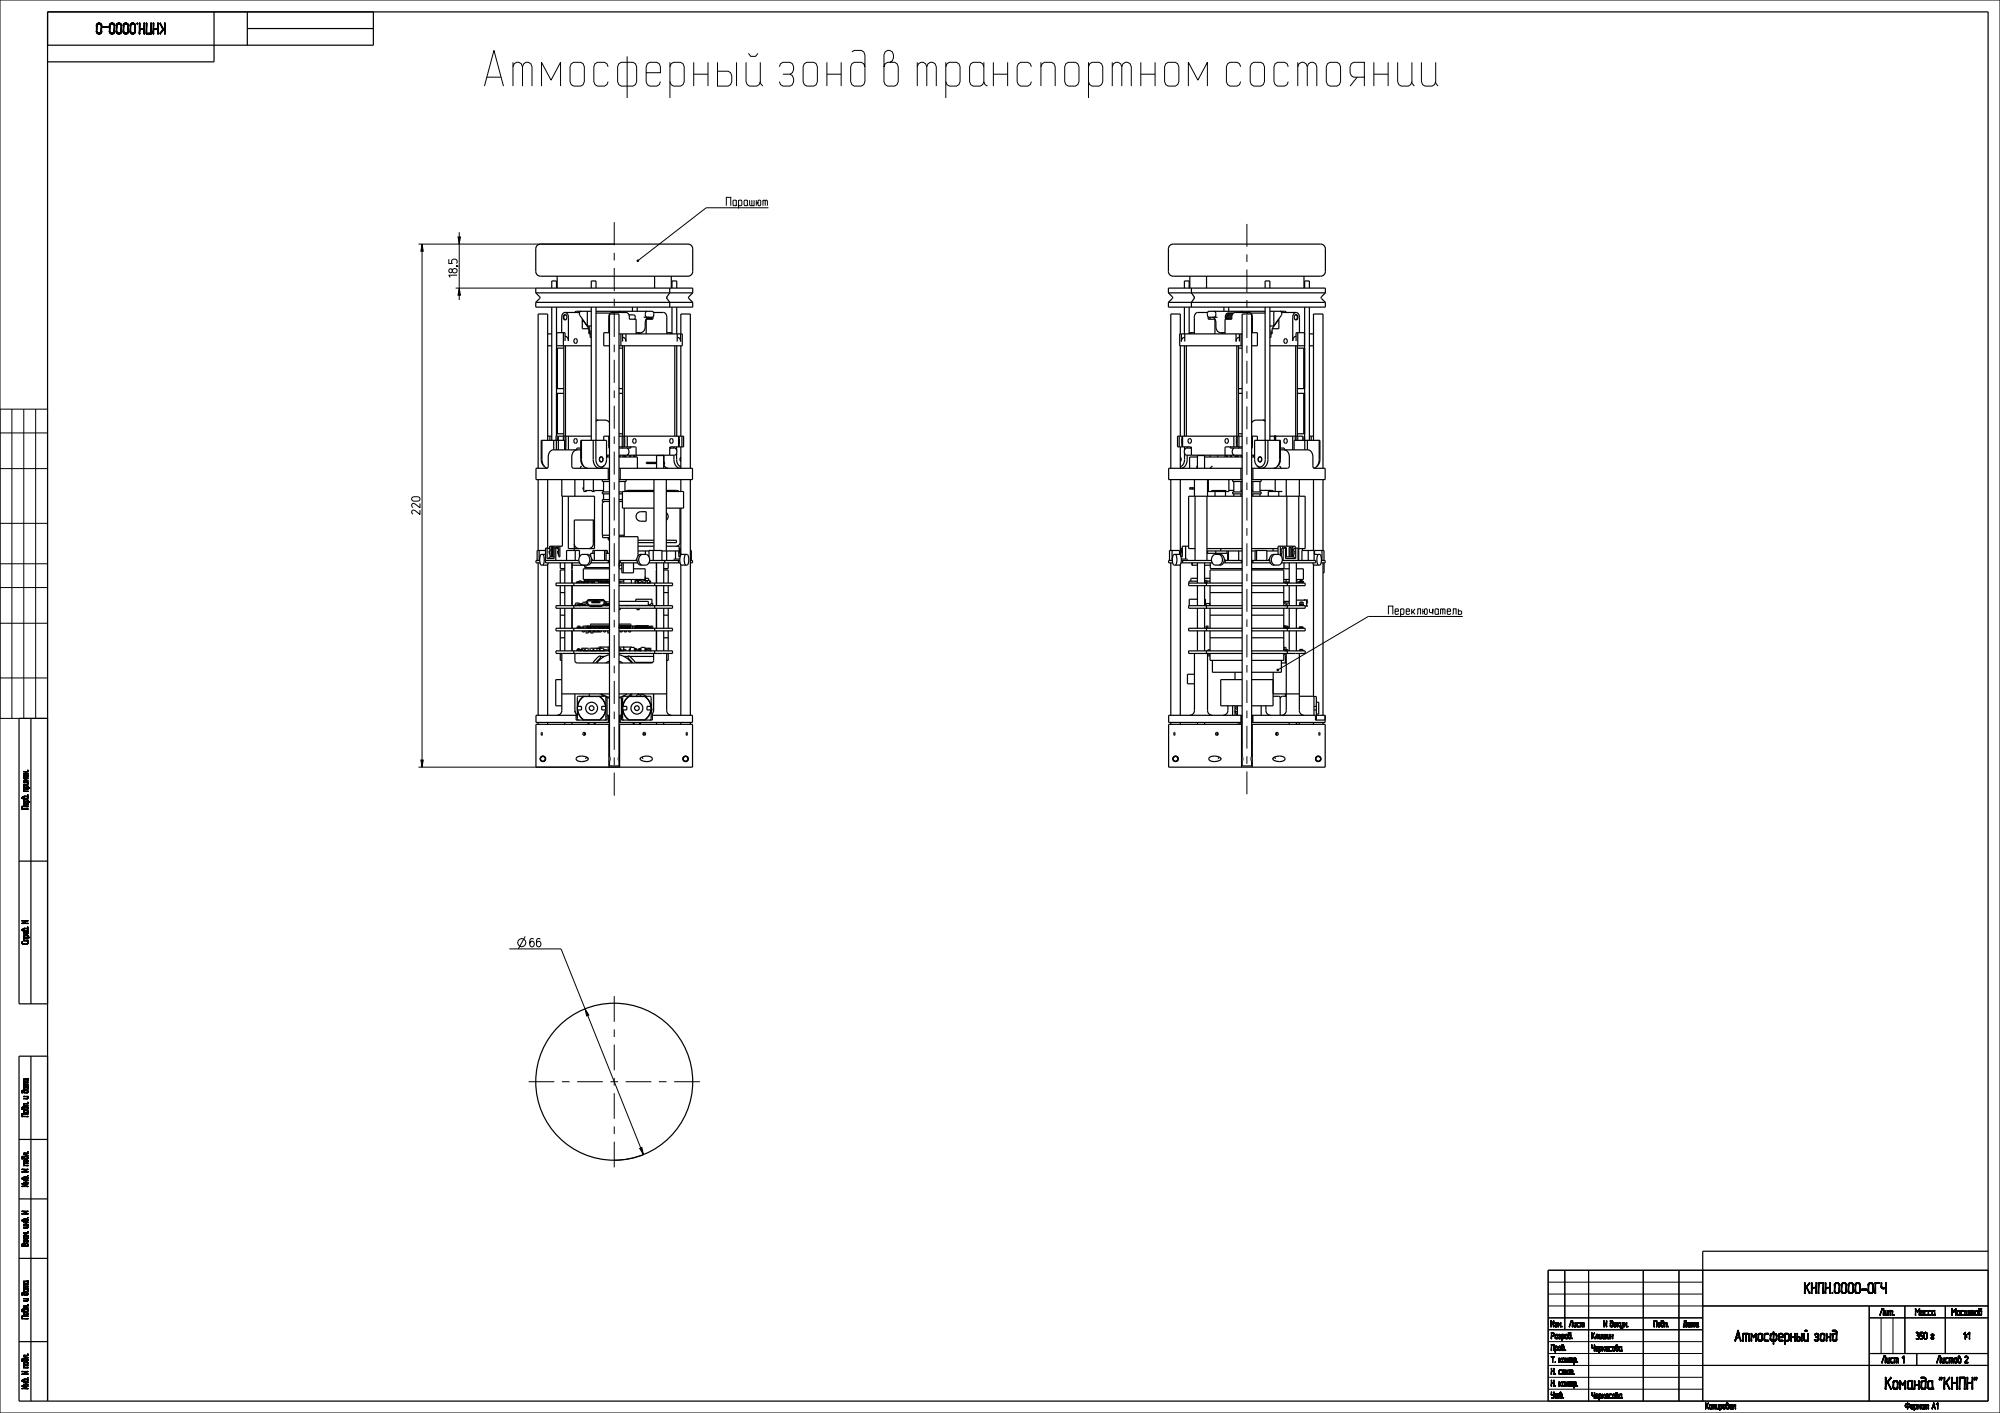
[picture p65: page 1]
Êîïèðîâàë; Ôîðìàò À1; Атмосферный зонд; Óòâ.; Черкасова; Парашют; Переключатель

Èíâ. N ïîäë. Ïîäï. è äàòà Âçàì. èíâ. N Èíâ. N ïîäë. Ïîäï. è äàòà Ñïðàâ. N Ïåðâ. ïðèìåí.

КНПН.0000-0 ГЧ

Ëèò. | Ìàññà | Ìàñøòàá

Èçì. Ëèñò | N äîêóì. | Ïîäï. | Äàòà | | | | | 350 г | 1:1
Ðàçðàá. | Клишин

Ïðîâ. | Черкасова
Ò. êîíòð. | | | | Ëèñò 1 | Ëèñòîâ 2
Í. ñåêò. | | | | Команда "КНПН" Í. êîíòð.

А

# Атмосферный зонд в рабочем состоянии

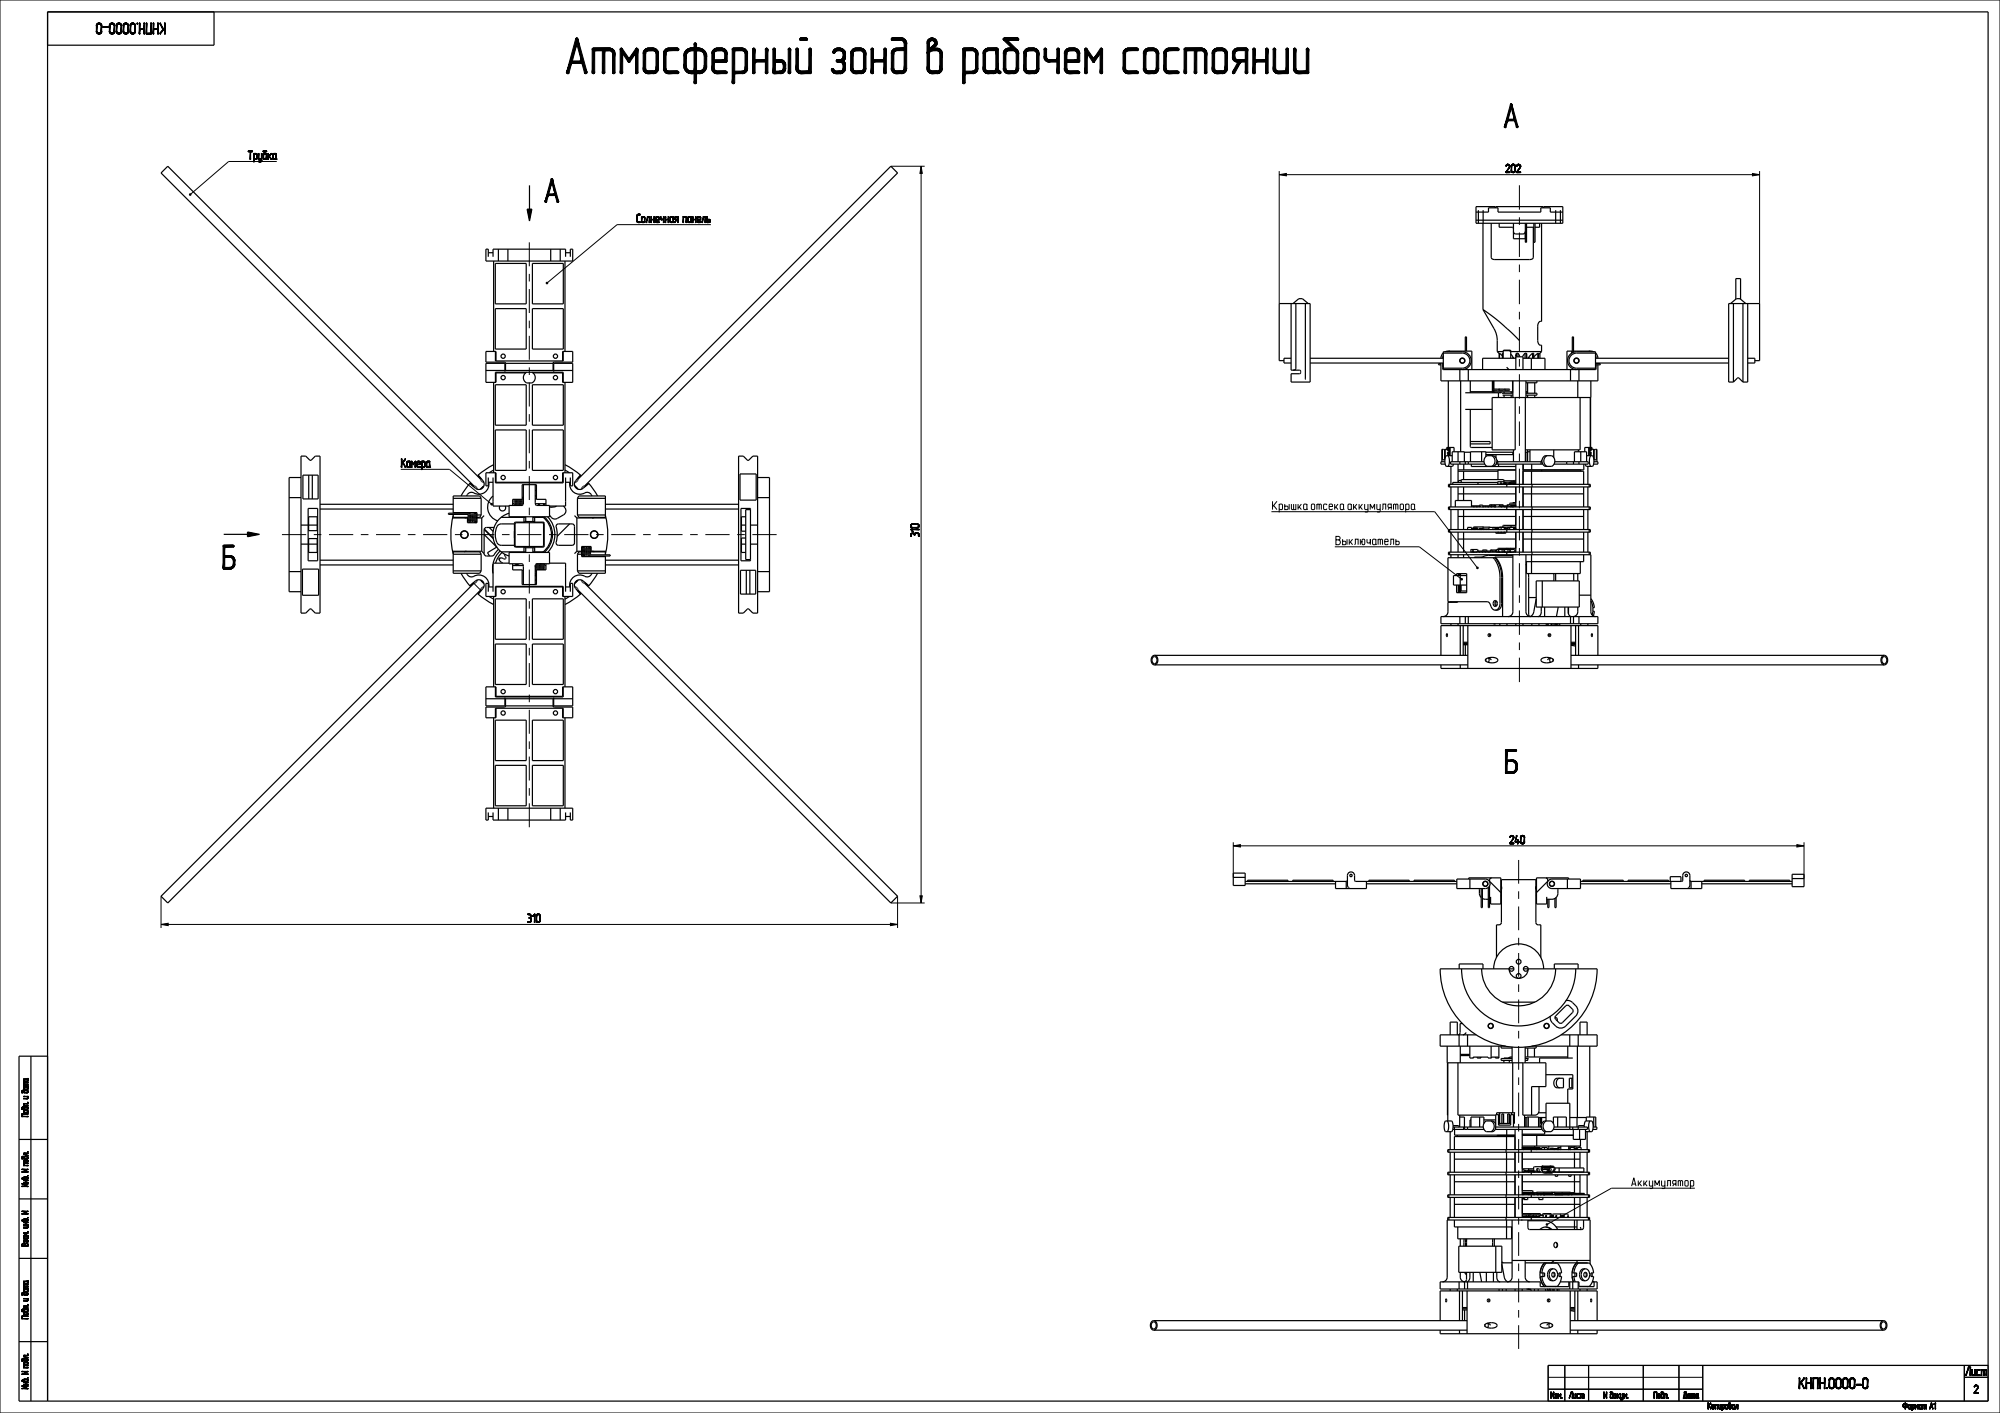
[picture p66: page 2]
Êîïèðîâàë; Ôîðìàò À1; Ëèñò; Солнечная панель; Трубка; Камера; Выключатель; Аккумулятор

Крышка отсека аккумулятора

Èíâ. N ïîäë. Ïîäï. è äàòà Âçàì. èíâ. N Èíâ. N ïîäë. Ïîäï. è äàòà

КНПН.0000-0 | 2 Èçì. Ëèñò
N äîêóì. | Ïîäï. | Äàòà
