cansat-tsniimash/KNPN-2023/construction/КНПН.1000-0.pdf

## Утв. Формат

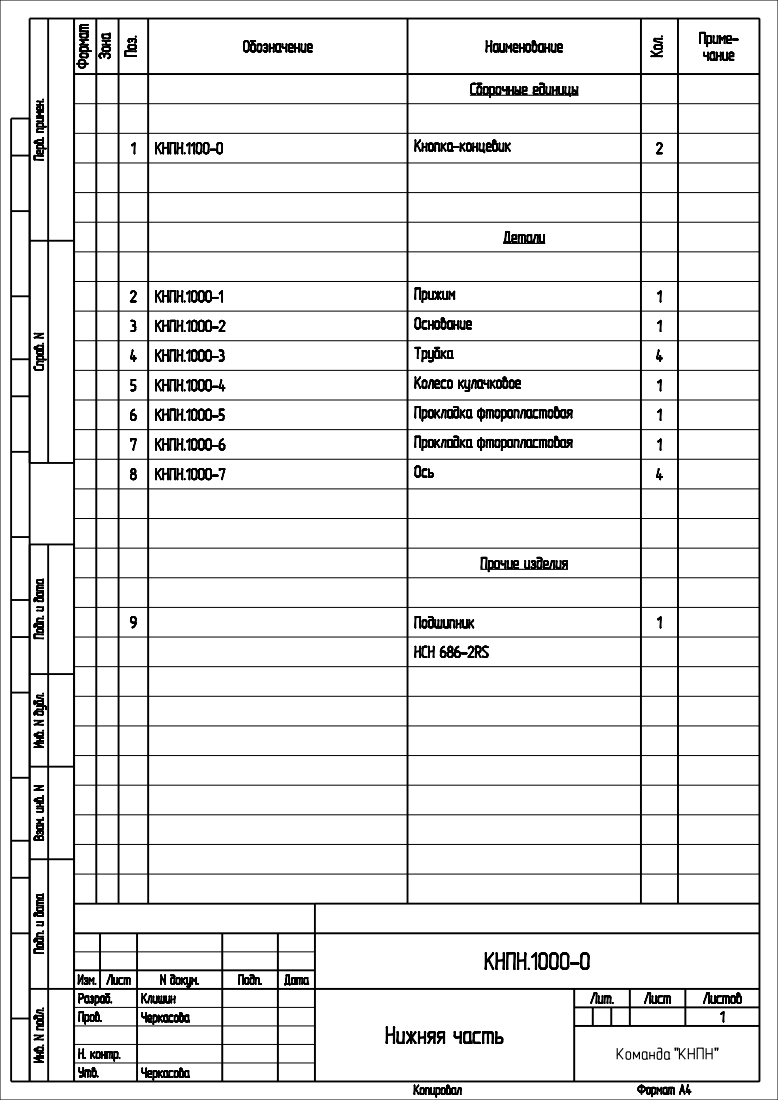
[picture p67: page 1]
Копировал; Формат А4; КНПН.1100-0; Кнопка-концевик; Детали; Прочие изделия; Зона; Поз.; Кол.

Обозначение | Наименование | Приме-чание

Сборочные единицы

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

2 | КНПН.1000-1 | Прижим | 1
3 | КНПН.1000-2 | Основание | 1
4 | КНПН.1000-3 | Трубка | 4
5 | КНПН.1000-4 | Колесо кулачковое | 1
6 | КНПН.1000-5 | Прокладка фторопластовая | 1
7 | КНПН.1000-6 | Прокладка фторопластовая | 1
8 | КНПН.1000-7 | Ось | 4

9 | Подшипник | 1

HCH 686-2RS

КНПН.1000-0

Изм. | Лист | N докум. | Подп. | Дата
Разраб. | Клишин | | Нижняя часть | Лит. | Лист | Листов
Пров. | Черкасова | | | | | | | 1

Н. контр.

Команда "КНПН"

Черкасова
