cansat-tsniimash/KNPN-2023/construction/КНПН.2000-0.pdf

## Утв. Формат

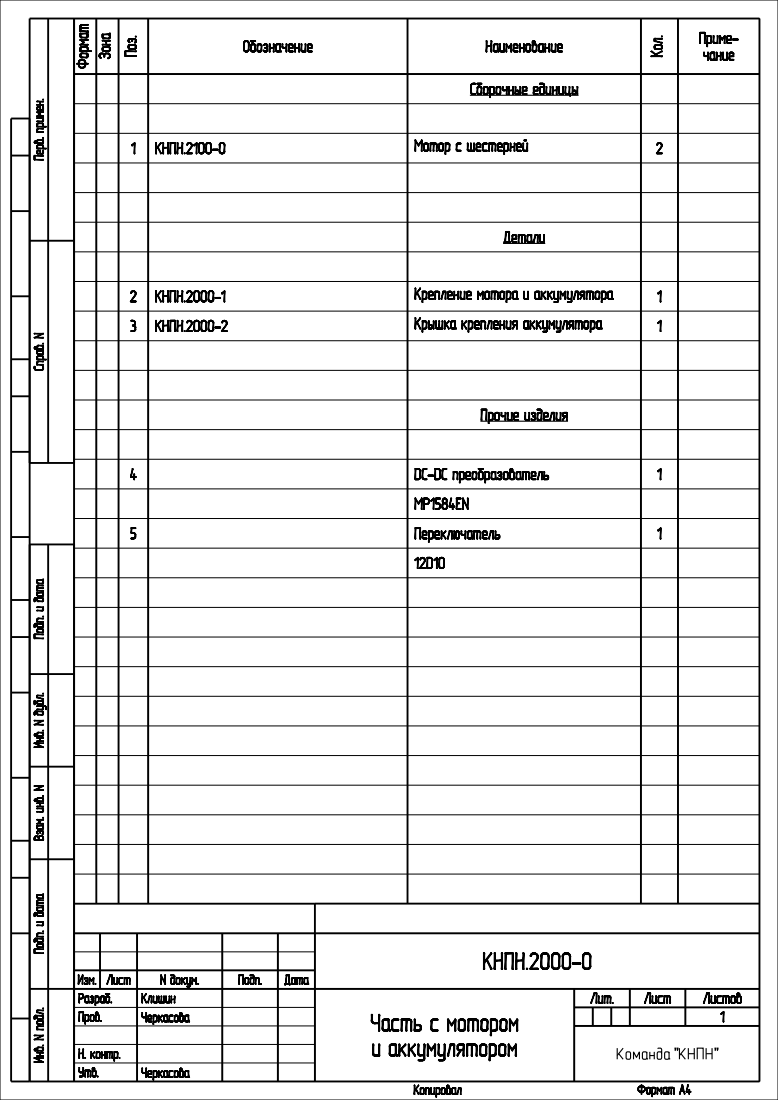
[picture p68: page 1]
Копировал; Формат А4; КНПН.2100-0; Мотор с шестерней; Детали; Прочие изделия; Зона; Поз.; Кол.

Обозначение | Наименование | Приме-чание

Сборочные единицы

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

2 | КНПН.2000-1 | Крепление мотора и аккумулятора | 1
3 | КНПН.2000-2 | Крышка крепления аккумулятора | 1

4 | DC-DC преобразователь | 1

5 | Переключатель | 1

КНПН.2000-0

Изм. | Лист | N докум. | Подп. | Дата
Разраб. | Клишин | | Часть с мотором и аккумулятором | Лит. | Лист | Листов
Пров. | Черкасова | | | | | | | 1

Н. контр.

Команда "КНПН"

Черкасова
