cansat-tsniimash/KNPN-2023/construction/КНПН.4000-0.pdf

## Утв. Формат

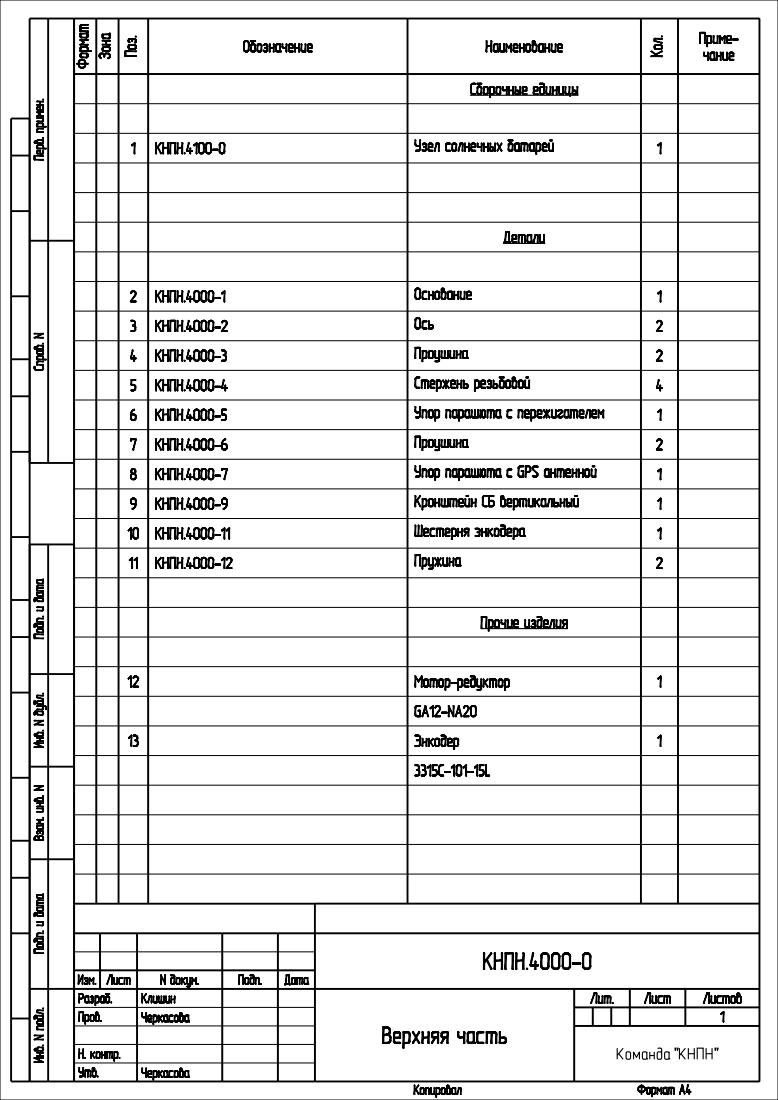
[picture p69: page 1]
Копировал; Формат А4; Черкасова; КНПН.4100-0; Узел солнечных батарей; Детали; Прочие изделия; Н. контр.; Команда "КНПН"; Зона; Поз.; Кол.

Обозначение | Наименование | Приме-чание

Сборочные единицы

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

2 | КНПН.4000-1 | Основание | 1
3 | КНПН.4000-2 | Ось | 2
4 | КНПН.4000-3 | Проушина | 2
5 | КНПН.4000-4 | Стержень резьбовой | 4
6 | КНПН.4000-5 | Упор парашюта с пережигателем | 1
7 | КНПН.4000-6 | Проушина | 2
8 | КНПН.4000-7 | Упор парашюта с GPS антенной | 1
9 | КНПН.4000-9 | Кронштейн СБ вертикальный | 1
10 | КНПН.4000-11 | Шестерня энкодера | 1
11 | КНПН.4000-12 | Пружина | 2

12 | Мотор-редуктор | 1

13 | Энкодер | 1

КНПН.4000-0

Изм. | Лист | N докум. | Подп. | Дата
Разраб. | Клишин | | Верхняя часть | Лит. | Лист | Листов
Пров. | Черкасова | | | | | | | 1
