cansat-tsniimash/KNPN-2023/schematics/board/zakaz 2/SP.brd

## EAGLE design schematics/board/zakaz 2/SP.brd (2023-06-04)

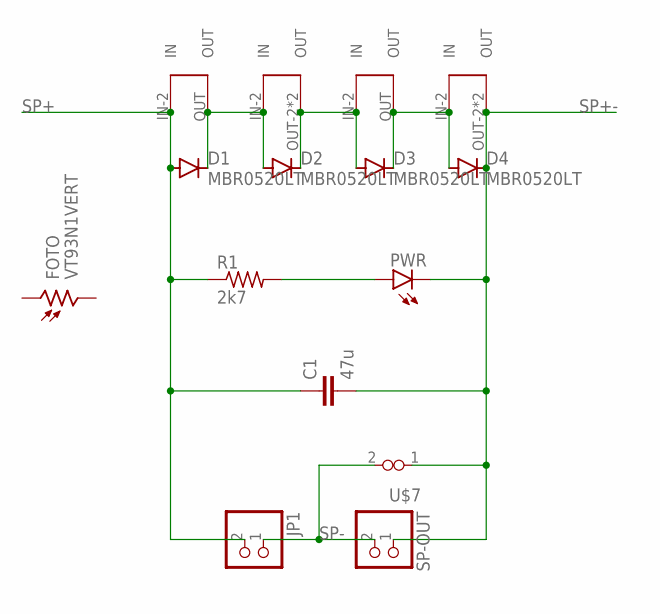
[picture p70: schematic SP.sch]

Parts:
C1: 47u; C1210
D1, D2, D3, D4: MBR0520LT; SOD123
FOTO: VT93N1VERT; VT93N1-VERT
JP1: PINHD-1X2; 1X02
PWR: LEDCHIP-LED0603; CHIP-LED0603
R1: 2k7; R0603
SP-OUT: PINHD-1X2; 1X02
U$1, U$3: SOLAR-2_1; SOLAR_1-2
U$2, U$4: SOLAR-2_0; SOLAR_0-2
U$7: VIAS-CONNECT

Connections:
unnamed: D1.C, D2.A, U$1.OUT, U$2.IN-2 (IN)
unnamed: D2.C, D3.A, U$2.OUT-2 (OUT), U$2.OUT-21 (OUT), U$3.IN-2 (IN)
unnamed: D3.C, D4.A, U$3.OUT, U$4.IN-2 (IN)
unnamed: PWR.A, R1.2
SP+: C1.1, D1.A, JP1.2, R1.1, U$1.IN-2 (IN)
SP+-: C1.2, D4.C, PWR.C, SP-OUT.1, U$4.OUT-2 (OUT), U$4.OUT-21 (OUT), U$7.1
SP-: JP1.1, SP-OUT.2, U$7.2

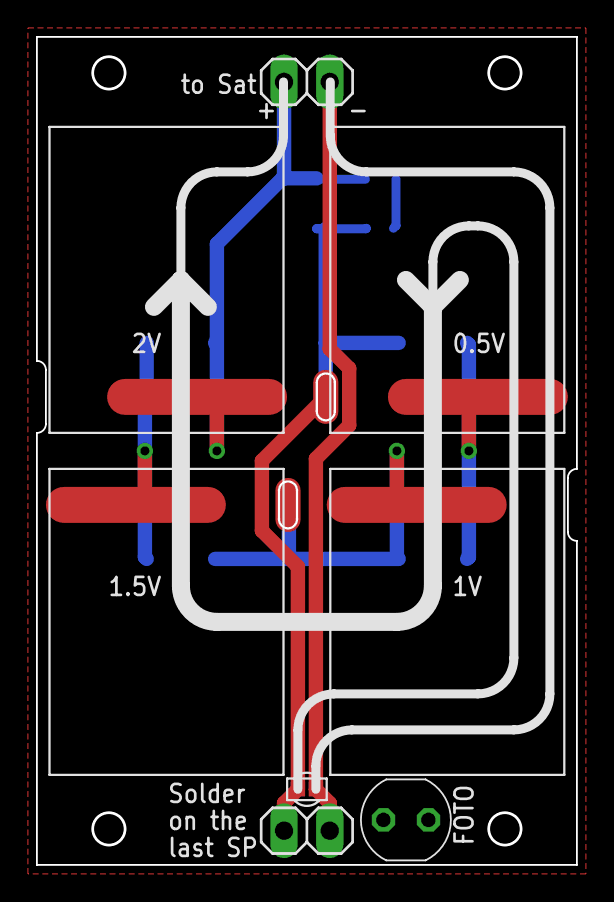
[picture p71: board SP.brd from above]

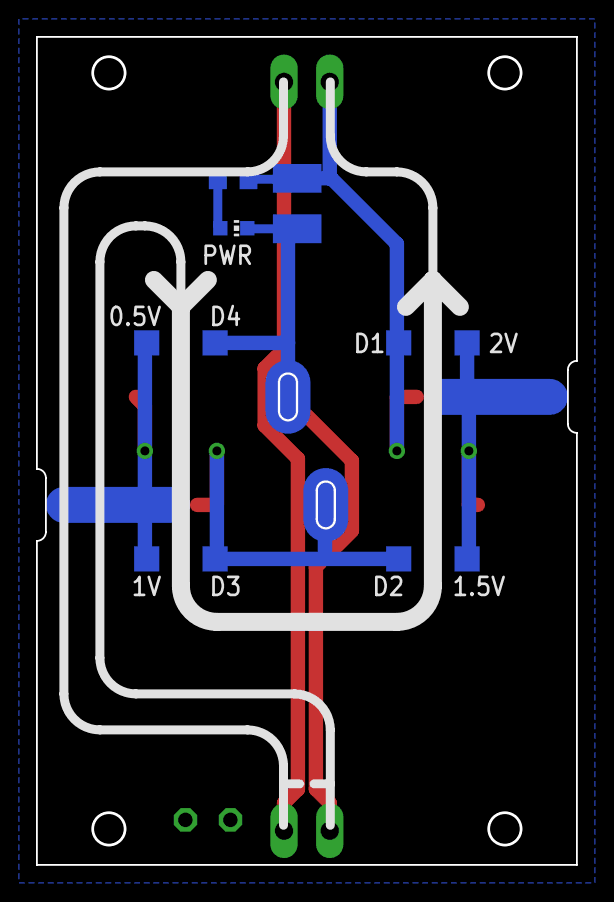
[picture p72: board SP.brd from below]

Board: 2 copper layers, 30.0 x 46.0 mm, 15 parts (7 on the bottom side), 7 nets.
