cansat-tsniimash/KNPN-2023/schematics/board/zakaz 2/dop.brd

## EAGLE design schematics/board/zakaz 2/dop.brd (2023-06-04)

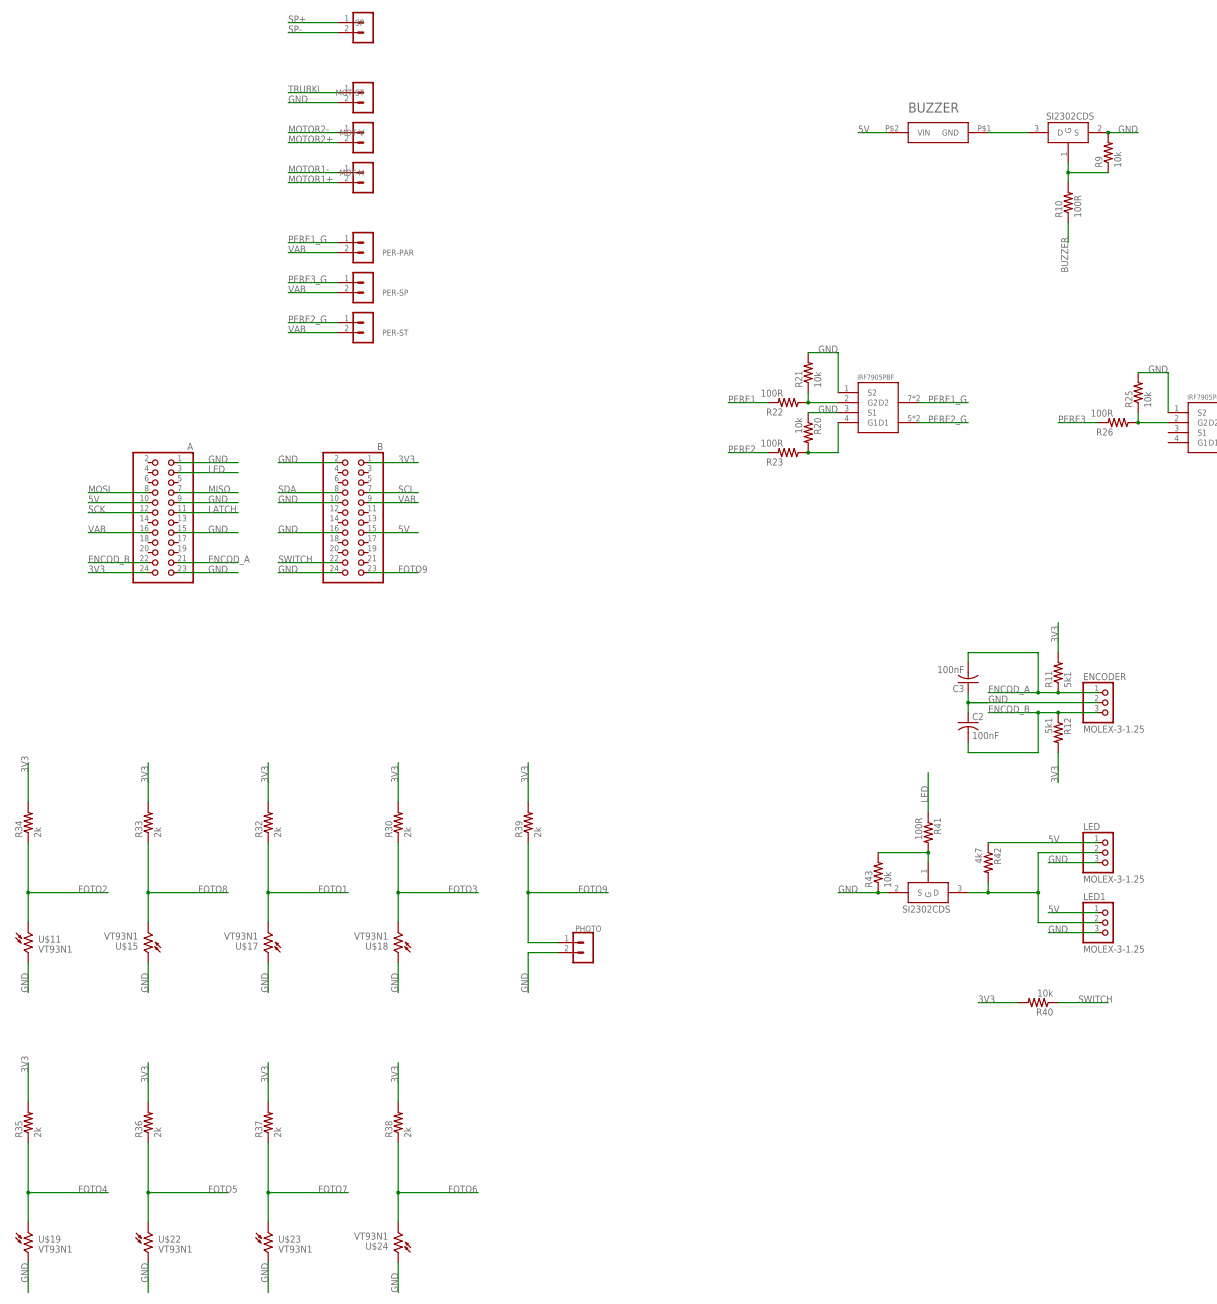
[picture p73: schematic dop.sch, part in row 1, column 1]

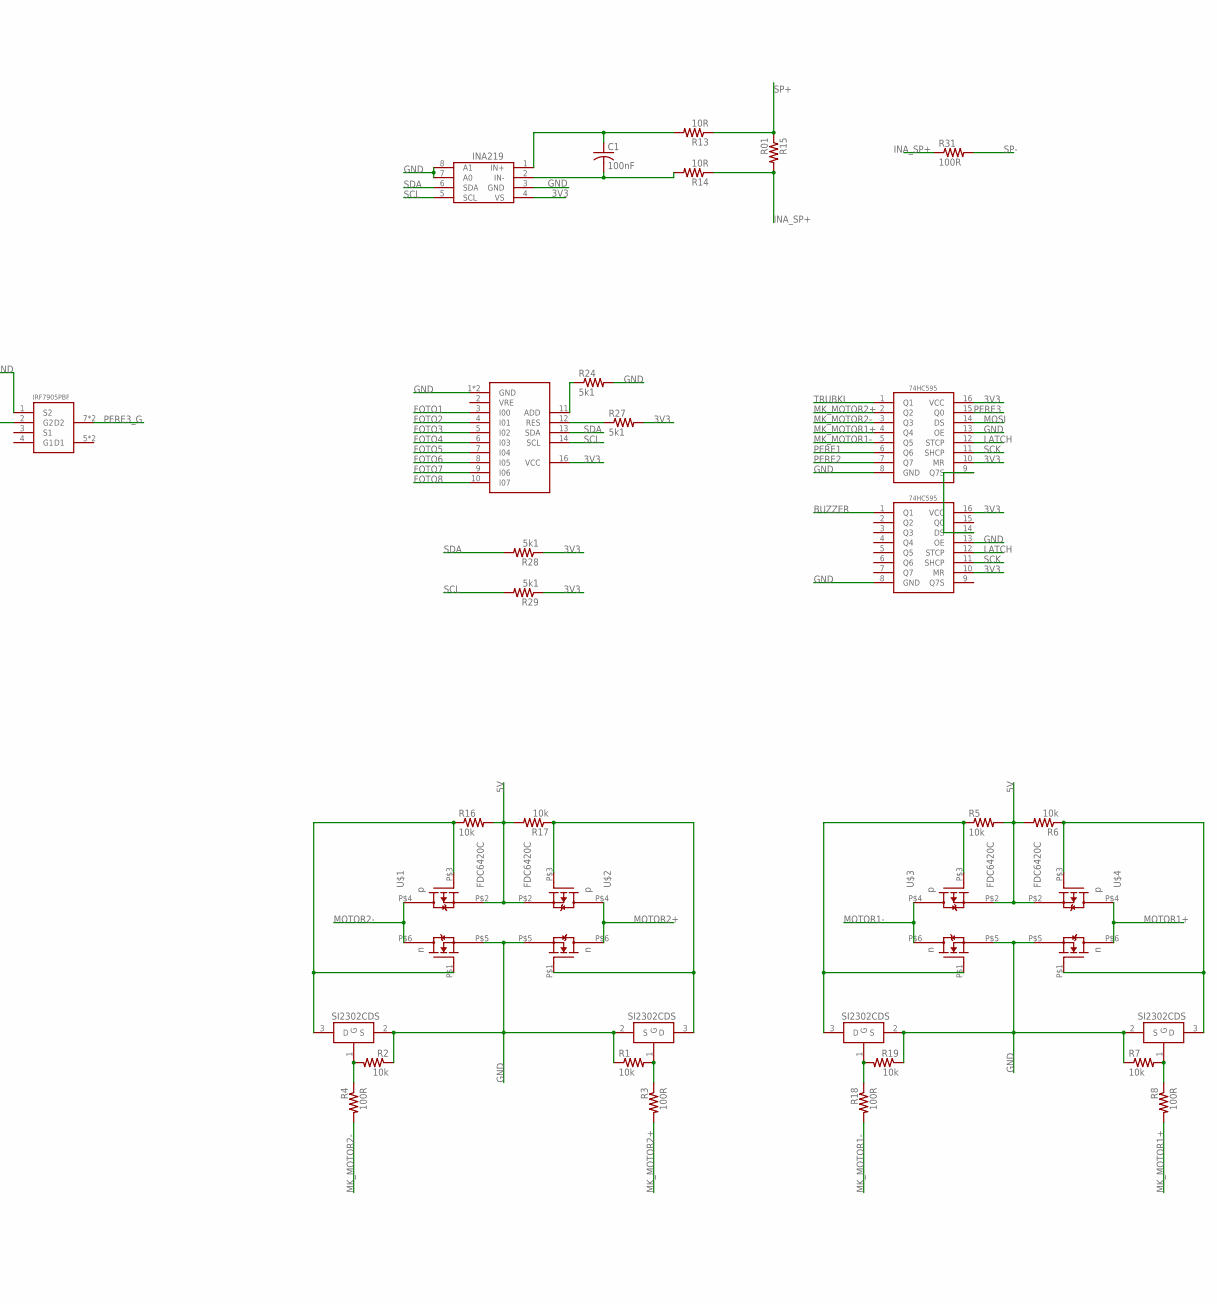
[picture p74: schematic dop.sch, part in row 1, column 2]

Parts:
74HC595, 74HC595-: 74HC595; TSSOP16
A: PINHD-2X12; 2X12
AD5593: AD5593
B: PINHD-2X12; 2X12
BUZZER: BUZZERS8R6; BUZZER-S8R12
C1, C2, C3: 100nF; C0603
ENCODER: MOLEX-3-1.25; 53047-03
INA: INA219AID; SOT23-8
IRF7905, IRF7905-: IRF7905; SO8
LED, LED1: MOLEX-3-1.25; 53047-03
MOT-H: MOLEX-2-1.25; 53047-02
MOT-ST: MOLEX-2-1.25; 53047-02
MOT-V: MOLEX-2-1.25; 53047-02
PER-PAR: JST-2-2.5
PER-SP: JST-2-2.5
PER-ST: JST-2-2.5
PHOTO: MOLEX-2-1.25; 53047-02
R1, R2, R5, R6, R7, R9, R16, R17, R19, R20, R21, R25, R40, R43: 10k; R0603
R3, R4, R8, R10, R18, R22, R23, R26, R41: 100R; R0603
R11, R12, R24, R27, R28, R29: 5k1; R0603
R13, R14: 10R; R0603
R15: R01; R2512
R30, R32, R33, R34, R35, R36, R37, R38, R39: 2k; R0603
R31: 100R; 0207/15
R42: 4k7; R0603
SI2302, SI2302-, SI2302-1, SI2302-2, SI2302-3, SI2302-4: SI2302CDS; SOT23-3
SP: MOLEX-2-1.25; 53047-02
U$1, U$2, U$3, U$4: FDC6420C; TSOP-6
U$11, U$15, U$17, U$18, U$19, U$22, U$23, U$24: VT93N1

Connections:
3V3: 74HC595.10 (MR), 74HC595.16 (VCC), 74HC595-.10 (MR), 74HC595-.16 (VCC), A.24, AD5593.16 (VCC), B.1, INA.4 (VS), R11.2, R12.2, R27.2, R28.1, R29.1, R30.2, R32.2, R33.2, R34.2, R35.2, R36.2, R37.2, R38.2, R39.2, R40.2
5V: A.10, B.15, BUZZER.P$2 (VIN), LED.1, LED1.1, R5.2, R6.2, R16.2, R17.2, R42.1, U$1.P$2 (PS), U$2.P$2 (PS), U$3.P$2 (PS), U$4.P$2 (PS)
BUZZER: 74HC595-.1 (Q1), R10.1
ENCOD_A: A.21, C3.2, ENCODER.1, R11.1
ENCOD_B: A.22, C2.2, ENCODER.3, R12.1
FOTO1: AD5593.3 (I00), R32.1, U$17.P$2 (2)
FOTO2: AD5593.4 (I01), R34.1, U$11.P$1 (1)
FOTO3: AD5593.5 (I02), R30.1, U$18.P$2 (2)
FOTO4: AD5593.6 (I03), R35.1, U$19.P$1 (1)
FOTO5: AD5593.7 (I04), R36.1, U$22.P$1 (1)
FOTO6: AD5593.8 (I05), R38.1, U$24.P$2 (2)
FOTO7: AD5593.9 (I06), R37.1, U$23.P$1 (1)
FOTO8: AD5593.10 (I07), R33.1, U$15.P$2 (2)
FOTO9: B.23, PHOTO.1, R39.1
GND: 74HC595.8 (GND), 74HC595.13 (OE), 74HC595-.8 (GND), 74HC595-.13 (OE), A.1, A.9, A.15, A.23, AD5593.1 (GND), AD5593.15 (GND), B.2, B.10, B.16, B.24, C2.1, C3.1, ENCODER.2, INA.3 (GND), INA.7 (A0), INA.8 (A1), IRF7905.1 (S2), IRF7905.3 (S1), IRF7905-.1 (S2), LED.3, LED1.3, MOT-ST.2, PHOTO.2, R1.1, R2.1, R7.1, R9.2, R19.1, R20.1, R21.2, R24.2, R25.2, R43.1, SI2302.2 (S), SI2302-.2 (S), SI2302-1.2 (S), SI2302-2.2 (S), SI2302-3.2 (S), SI2302-4.2 (S), U$1.P$5 (NS), U$2.P$5 (NS), U$3.P$5 (NS), U$4.P$5 (NS), U$11.P$2 (2), U$15.P$1 (1), U$17.P$1 (1), U$18.P$1 (1), U$19.P$2 (2), U$22.P$2 (2), U$23.P$2 (2), U$24.P$1 (1)
INA_SP+: R14.1, R15.2, R31.1
LATCH: 74HC595.12 (STCP), 74HC595-.12 (STCP), A.11
LED: A.3, R41.1
MISO: A.7
MK_MOTOR1+: 74HC595.4 (Q4), R8.2
MK_MOTOR1-: 74HC595.5 (Q5), R18.2
MK_MOTOR2+: 74HC595.2 (Q2), R3.2
MK_MOTOR2-: 74HC595.3 (Q3), R4.2
MOSI: 74HC595.14 (DS), A.8
MOTOR1+: MOT-H.2, U$4.P$4 (PD), U$4.P$6 (ND)
MOTOR1-: MOT-H.1, U$3.P$4 (PD), U$3.P$6 (ND)
MOTOR2+: MOT-V.2, U$2.P$4 (PD), U$2.P$6 (ND)
MOTOR2-: MOT-V.1, U$1.P$4 (PD), U$1.P$6 (ND)
unnamed: R1.2, R3.1, SI2302-3.1 (G)
unnamed: R2.2, R4.1, SI2302-1.1 (G)
unnamed: R5.1, SI2302-2.3 (D), U$3.P$1 (NG), U$3.P$3 (PG)
unnamed: R7.2, R8.1, SI2302-4.1 (G)
unnamed: R18.1, R19.2, SI2302-2.1 (G)
unnamed: R6.1, SI2302-4.3 (D), U$4.P$1 (NG), U$4.P$3 (PG)
unnamed: IRF7905.4 (G1), R20.2, R23.1
unnamed: IRF7905.2 (G2), R21.1, R22.1
unnamed: BUZZER.P$1 (GND), SI2302-.3 (D)
unnamed: R9.1, R10.2, SI2302-.1 (G)
unnamed: C1.1, INA.1 (IN+), R13.2
unnamed: C1.2, INA.2 (IN-), R14.2
unnamed: R41.2, R43.2, SI2302.1 (G)
unnamed: AD5593.12 (RES), R27.1
unnamed: R17.1, SI2302-3.3 (D), U$2.P$1 (NG), U$2.P$3 (PG)
unnamed: AD5593.11 (ADD), R24.1
unnamed: IRF7905-.2 (G2), R25.1, R26.1
unnamed: 74HC595.9 (Q7S), 74HC595-.14 (DS)
unnamed: LED.2, LED1.2, R42.2, SI2302.3 (D)
unnamed: R16.1, SI2302-1.3 (D), U$1.P$1 (NG), U$1.P$3 (PG)
PERE1: 74HC595.6 (Q6), R22.2
PERE1_G: IRF7905.7 (D2), IRF7905.8 (D2), PER-PAR.1
PERE2: 74HC595.7 (Q7), R23.2
PERE2_G: IRF7905.5 (D1), IRF7905.6 (D1), PER-ST.1
PERE3: 74HC595.15 (Q0), R26.2
PERE3_G: IRF7905-.7 (D2), IRF7905-.8 (D2), PER-SP.1
SCK: 74HC595.11 (SHCP), 74HC595-.11 (SHCP), A.12
SCL: AD5593.14 (SCL), B.7, INA.5 (SCL), R29.2
SDA: AD5593.13 (SDA), B.8, INA.6 (SDA), R28.2
SP+: R13.1, R15.1, SP.1
SP-: R31.2, SP.2
SWITCH: B.22, R40.1
TRUBKI: 74HC595.1 (Q1), MOT-ST.1
VAB: A.16, B.9, PER-PAR.2, PER-SP.2, PER-ST.2

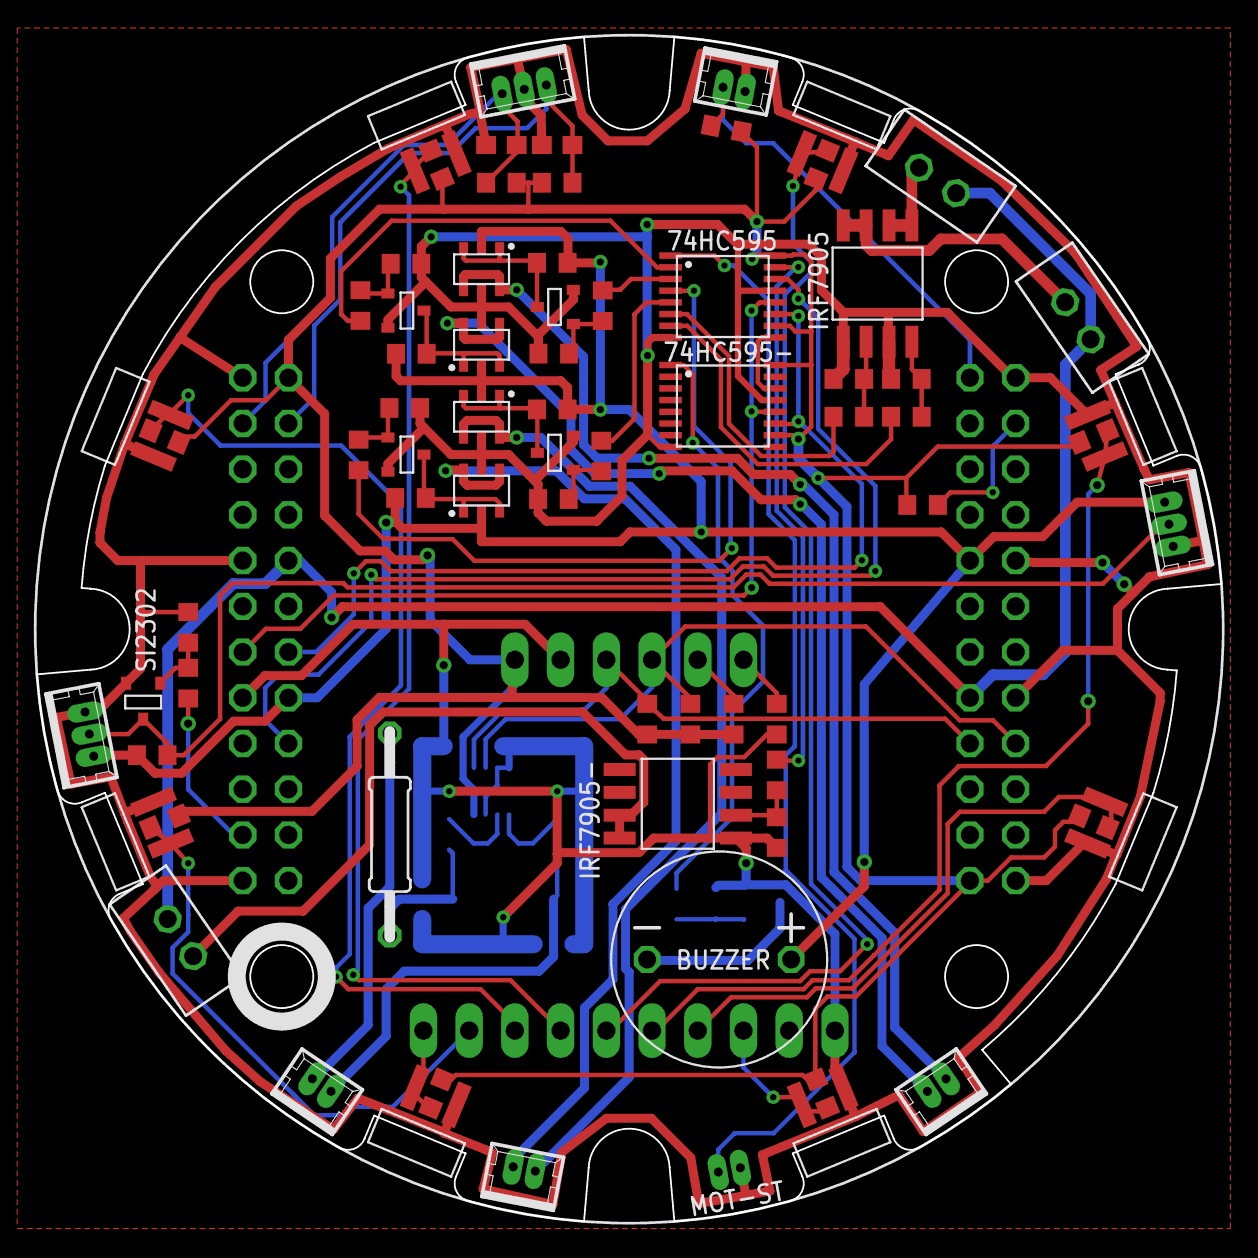
[picture p75: board dop.brd from above]

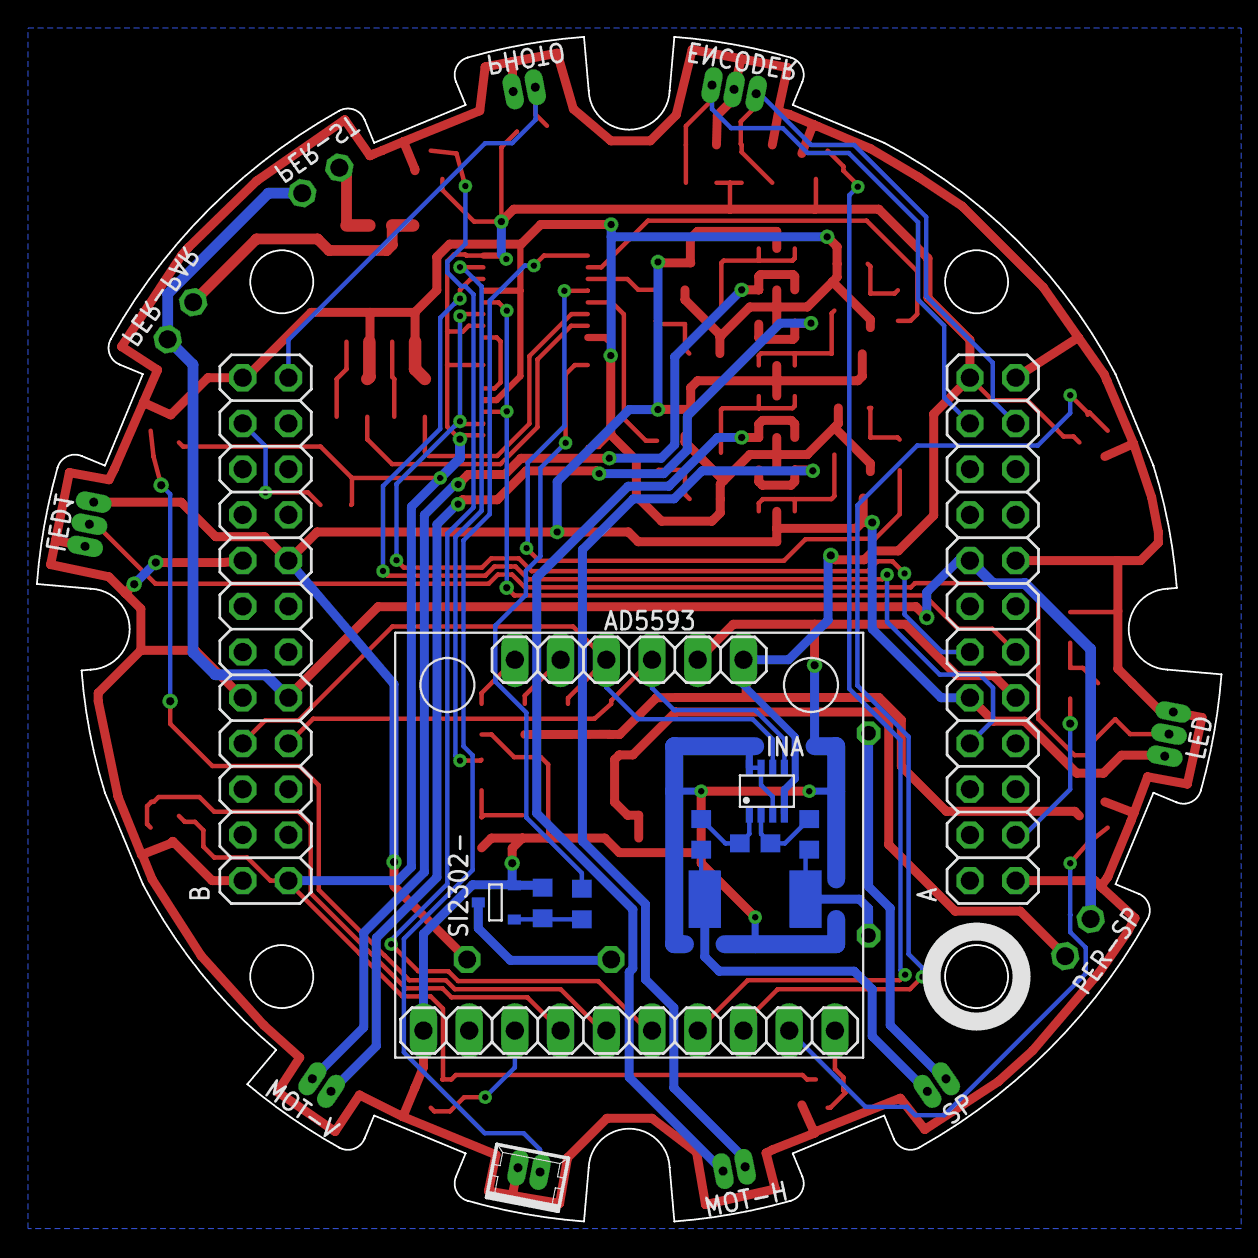
[picture p76: board dop.brd from below]

Board: 2 copper layers, 65.8 x 65.8 mm, 84 parts (12 on the bottom side), 61 nets.
