cansat-tsniimash/KNPN-2023/schematics/board/zakaz 1/mtr.brd

## EAGLE design schematics/board/zakaz 1/mtr.brd (2023-05-27)

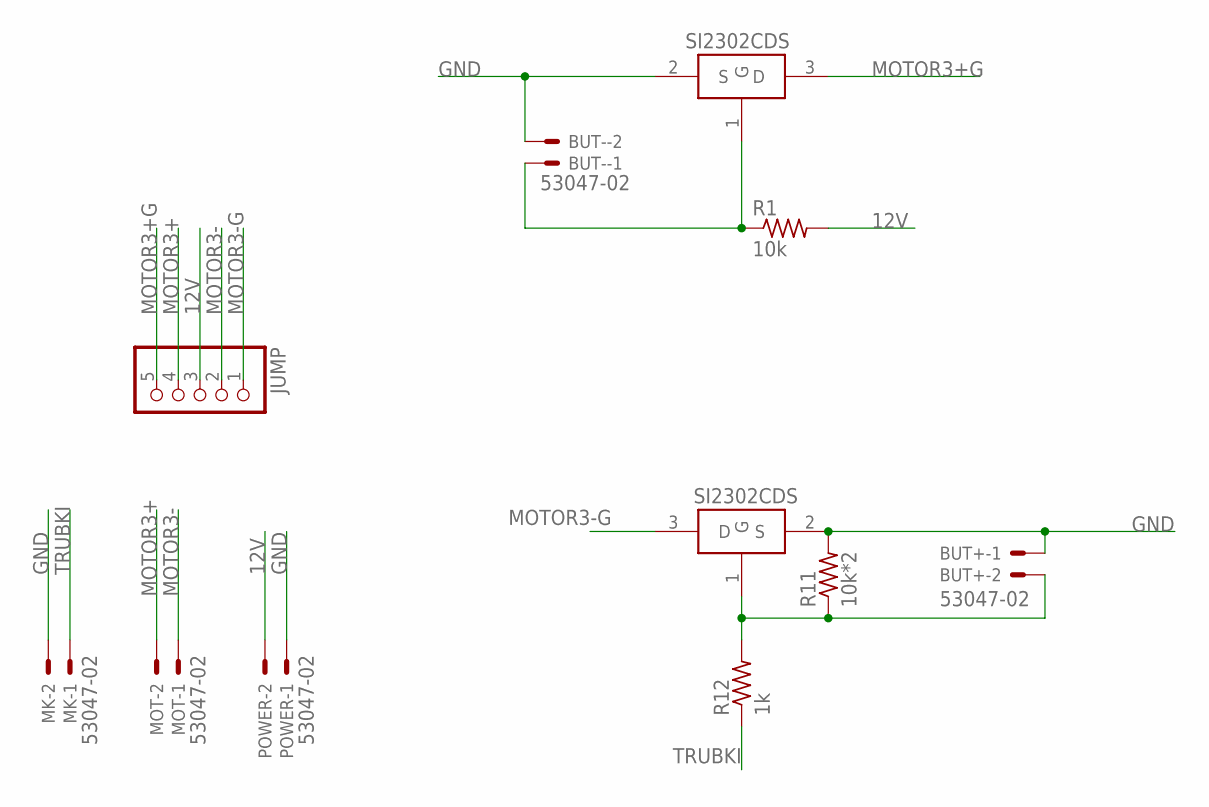
[picture p77: schematic mtr.sch]

Parts:
BUT+: 53047-02
BUT-: 53047-02
JUMP: PINHD-1X5; 1X05
MK: 53047-02
MOT: 53047-02
POWER: 53047-02
R1: 10k; R0603
R11: 10k*2; R0603
R12: 1k; R0603
U$1, U$21: SI2302CDS; SOT23-3

Connections:
12V: JUMP.3, POWER.2, R1.2
GND: BUT+.1, BUT-.2, MK.2, POWER.1, R11.2, U$1.2 (S), U$21.2 (S)
MOTOR3+: JUMP.4, MOT.2
MOTOR3+G: JUMP.5, U$21.3 (D)
MOTOR3-: JUMP.2, MOT.1
MOTOR3-G: JUMP.1, U$1.3 (D)
unnamed: BUT-.1, R1.1, U$21.1 (G)
unnamed: BUT+.2, R11.1, R12.2, U$1.1 (G)
TRUBKI: MK.1, R12.1

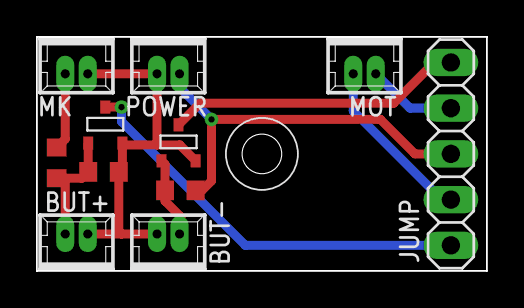
[picture p78: board mtr.brd from above]

Board: 2 copper layers, 25.0 x 13.0 mm, 11 parts (0 on the bottom side), 9 nets.
