cansat-tsniimash/KNPN-2023/schematics/board/SP1.brd

## EAGLE design schematics/board/SP1.brd (2023-03-25)

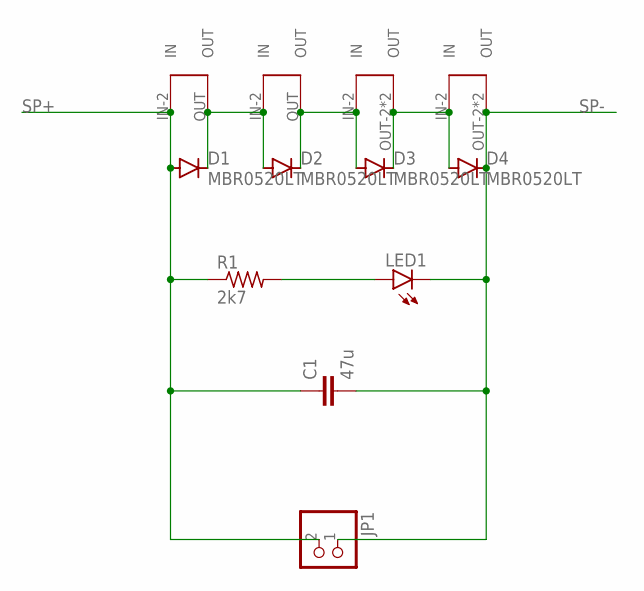
[picture p79: schematic SP1.sch]

Parts:
C1: 47u; C1210
D1, D2, D3, D4: MBR0520LT; SOD123
JP1: PINHD-1X2; 1X02
LED1: LEDCHIP-LED0603; CHIP-LED0603
R1: 2k7; R0603
U$1, U$2: SOLAR-2_1; SOLAR_1-2
U$3, U$4: SOLAR-2_0; SOLAR_0-2

Connections:
unnamed: D1.C, D2.A, U$1.OUT, U$2.IN-2 (IN)
unnamed: D2.C, D3.A, U$2.OUT, U$3.IN-2 (IN)
unnamed: D3.C, D4.A, U$3.OUT-2 (OUT), U$3.OUT-21 (OUT), U$4.IN-2 (IN)
unnamed: LED1.A, R1.2
SP+: C1.1, D1.A, JP1.2, R1.1, U$1.IN-2 (IN)
SP-: C1.2, D4.C, JP1.1, LED1.C, U$4.OUT-2 (OUT), U$4.OUT-21 (OUT)

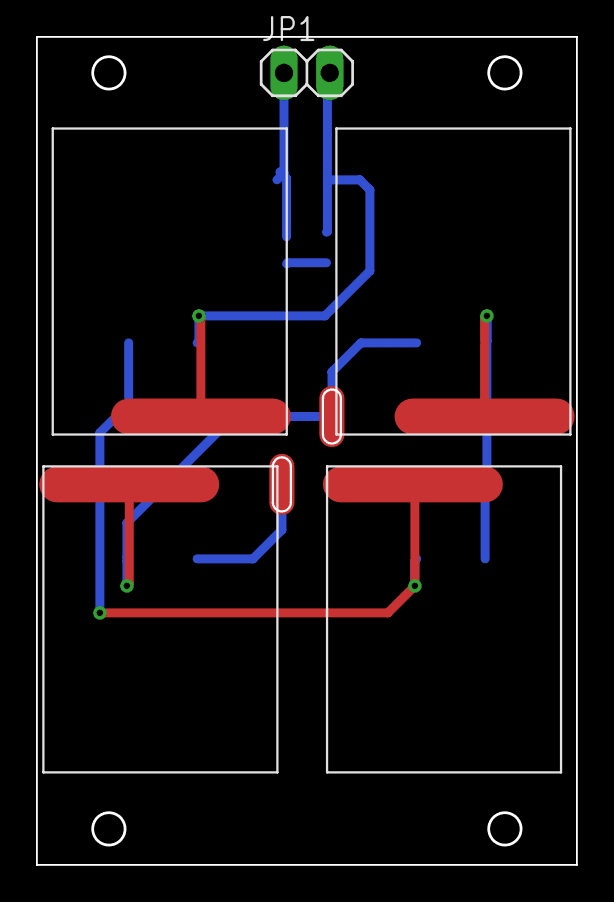
[picture p80: board SP1.brd from above]

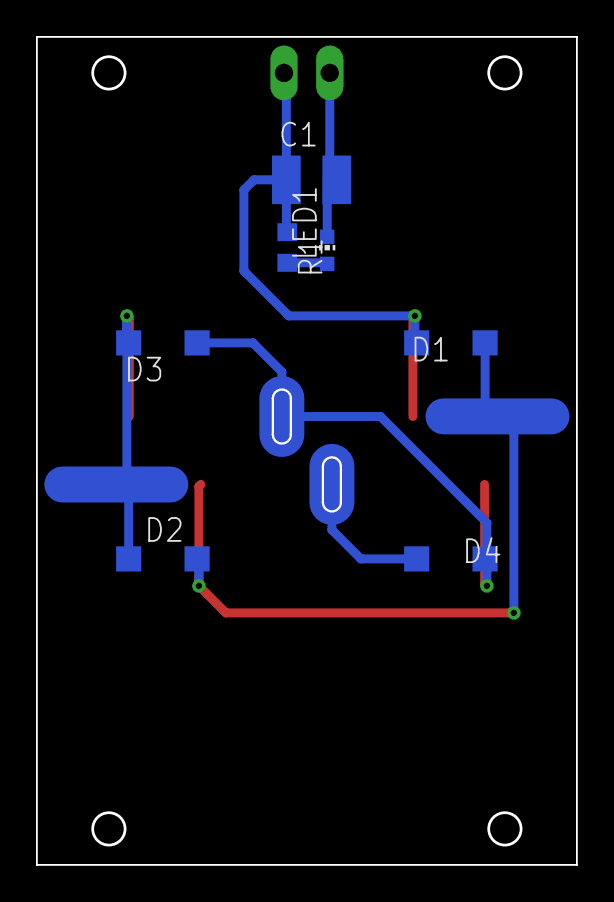
[picture p81: board SP1.brd from below]

Board: 2 copper layers, 30.0 x 46.0 mm, 12 parts (7 on the bottom side), 6 nets.
