cansat-tsniimash/KNPN-2023/src/board/KNPN_NNA/App/app_main.c

/*
 * app_main.c
 *
 *  Created on: Dec 17, 2022
 *      Author: Install
 */
#include "BME280/DriverForBME280.h"
#include "LSM6DS3/DLSM.h"
#include "LIS3MDL/DLIS3.h"
#include <stm32f4xx_hal.h>
#include "nRF24L01_PL/nrf24_upper_api.h"
#include "nRF24L01_PL/nrf24_lower_api_stm32.h"
#include "Photorezistor/photorezistor.h"
#include "1Wire_DS18B20/one_wire.h"
#include "ina219/inc/ina219_helper.h"
#include "I2C_crutch/i2c-crutch.h"
#include "fatfs.h"
#include "string.h"
#include "ATGM336H/nmea_gps.h"
#include "AD5593/ad5593.h"
#include "math.h"
extern SPI_HandleTypeDef hspi2;
extern ADC_HandleTypeDef hadc1;
extern I2C_HandleTypeDef hi2c1;
extern TIM_HandleTypeDef htim3;
extern UART_HandleTypeDef huart6;


#pragma pack(push, 1)

typedef struct paket_1{
	uint8_t flag;
	uint32_t time_pak;
	uint16_t n;
	int16_t temp_bme;
	uint32_t press;
	float height_bme;
	float current;
	int16_t bus_voltage;
	int8_t state;
	uint32_t photor;
	uint16_t crc;
}paket_1;

typedef struct paket_2{
	uint8_t flag;
	uint32_t time_pak;
	uint16_t n;
	int16_t lis_x;
	int16_t lis_y;
	int16_t lis_z;
	int16_t lsm_a_x;
	int16_t lsm_a_y;
	int16_t lsm_a_z;
	int16_t lsm_g_x;
	int16_t lsm_g_y;
	int16_t lsm_g_z;
	uint16_t crc;
}paket_2;

typedef struct paket_3{
	uint8_t flag;
	uint32_t time_pak;
	uint16_t n;
	int16_t temp;
	float latitude;
	float longitude;
	float height;
	uint32_t time_s;
	uint32_t time_us;
	int fix;
	uint16_t crc;
}paket_3;

#pragma pack(pop)

typedef struct INA219_DATA{
	uint16_t power;
	uint16_t current;
	uint16_t voltage;
	uint16_t shunt_voltage;
}INA219_DATA;

typedef struct motor_intf_sr
{
		int sr_pin;
		//Shift reg device
		shift_reg_t *sr;
}motor_intf_sr;

int _write(int file, char *ptr, int len)
{
	extern UART_HandleTypeDef huart1;
	HAL_UART_Transmit(
			&huart1,
			(uint8_t*)ptr, len,
			HAL_MAX_DELAY
	);
	return len;
}

uint16_t Crc16(uint8_t *buf, uint16_t len) {
    uint16_t crc = 0xFFFF;
    uint8_t i;
    while (len--) {
        crc ^= *buf++ << 8;
        for (i = 0; i < 8; i++)
            crc = crc & 0x8000 ? (crc << 1) ^ 0x1021 : crc << 1;
    }
    return crc;
}

typedef enum
{
	NRF_PACK_1,
	NRF_PACK_2,
	NRF_PACK_3,
	NRF_WAIT,

}nrf_state_t;

typedef enum
{
	STATE_BEFORE_LAUNCH = 0,
	STATE_IN_ROCKET = 1,
	STATE_PARACHUTE_DESENT = 2,
	STATE_DESENT = 3,
	STATE_LANDING = 4,
	STATE_OPEN_SP = 5,
	STATE_SUN_SEARCH = 6,
	STATE_ENERGY = 7,

}state_t;

int32_t prevCounter = 0;

shift_reg_t dop_sr;

void HAL_TIM_PWM_PulseFinishedCallback(TIM_HandleTypeDef * tim)
{
	//shift_reg_write_bit_16(&dop_sr, 2, 0);
}


void init() {
    // ... пропущено ...

    // так можно проставить начальное значение счетчика:
    // __HAL_TIM_SET_COUNTER(&htim1, 32760);

    // не забываем включить таймер!
    HAL_TIM_Encoder_Start(&htim3, TIM_CHANNEL_ALL);

    //__HAL_TIM_SET_COUNTER(&htim3, 1000);
    __HAL_TIM_SET_COMPARE(&htim3, TIM_CHANNEL_3, 16);
    __HAL_TIM_ENABLE_IT(&htim3, TIM_IT_CC3);
    //HAL_NVIC_EnableIRQ(TIM3_IRQn);
    //HAL_NVIC_SetPriority(TIM3_IRQn, 0, 0);

}
int32_t currCounter;
void loop() {
    currCounter = __HAL_TIM_GET_COUNTER(&htim3);
    //printf("value = %ld\n", currCounter);

    //currCounter = 32767 - ((currCounter-1) & 0xFFFF) ;
    if(currCounter > 32768) {
        // Преобразуем значения счетчика из:
        //  ... 32766, 32767, 0, 1, 2 ...
        // в значения:
        //  ... -2, -1, 0, 1, 2 ...
        currCounter = currCounter - 32768;
    }
    if(currCounter != prevCounter) {
        int32_t delta = currCounter-prevCounter;
        prevCounter = currCounter;
        // защита от дребезга контактов и переполнения счетчика
        // (переполнение будет случаться очень редко)
        if((delta > -10) && (delta < 10)) {
            // здесь обрабатываем поворот энкодера на delta щелчков
            // delta положительная или отрицательная в зависимости
            // от направления вращения

            // ...
        }
    }

    HAL_Delay(100);

}
FATFS fileSystem; // переменная типа FATFS


uint16_t sd_parse_to_bytes_pac1(char *buffer, paket_1 *paket1) {
    memset(buffer, 0, 300);
    uint16_t num_written = snprintf(
            buffer, 300,
			"%d;%ld;%d;%d;%ld;%f;4%f;%d;%d;%ld;%d\n",
			paket1->flag,paket1->time_pak,paket1->n,paket1->temp_bme,paket1->press, paket1->height_bme,
			paket1->current,paket1->bus_voltage,paket1->state,paket1->photor,paket1->crc);
    return num_written;
}
uint16_t sd_parse_to_bytes_pac2(char *buffer, paket_2 *paket2) {
    memset(buffer, 0, 300);
    uint16_t num_written = snprintf(
            buffer, 300,
            "%d;%ld;%d;%d;%d;%d;%d;%d;%d;%d;%d;%d;%d\n",
			paket2->flag,paket2->time_pak,paket2->n,paket2->lis_x,paket2->lis_y,
			paket2->lis_z,paket2->lsm_a_x,paket2->lsm_a_y,paket2->lsm_a_z,paket2->lsm_g_x,
			paket2->lsm_g_y,paket2->lsm_g_z,paket2->crc);
    return num_written;
}
uint16_t sd_parse_to_bytes_pac3(char *buffer, paket_3 *paket3) {
    memset(buffer, 0, 300);
    uint16_t num_written = snprintf(
            buffer, 300,
            "%d;%ld;%d;%d;%f;%f;%f;%ld;%ld;%d;%d;\n",
            paket3->flag,paket3->time_pak,paket3->n,paket3->temp,paket3->latitude,
			paket3->longitude,paket3->height,paket3->time_s,paket3->time_us,paket3->fix,paket3->crc );
    return num_written;
}


static ad5593_t adc;

static int setup_adc()
{
	ad5593_t * dev = &adc;
	int rc = ad5593_ctor(dev, AD5593_ADDR_A0_HIGH, &hi2c1);
	if (0 != rc)
	{
		perror("unable to ctor");
		return EXIT_FAILURE;
	}

	HAL_Delay(1);

	// Включаем питание на чем хотим
	printf("power config\n");
	rc = ad5593_power_config(dev, AD5593_POWER_DAC_REF, 0x00);
	if (0 != rc)
	{
		perror("unable to power config");
		return EXIT_FAILURE;
	}

	// Аналоговая конфигурация
	printf("analog config\n");
	ad5593_an_config_t an_config;
	an_config.adc_buffer_enable = false;
	an_config.adc_buffer_precharge = false;
	an_config.adc_range = AD5593_RANGE_1REF;
	rc = ad5593_an_config(dev, &an_config);
	if (0 != rc)
	{
		perror("unable to an config");
		return EXIT_FAILURE;
	}

	// Настройка пинов
	printf("pin config\n");
	rc = ad5593_pin_config(dev, 0xFF, AD5593_PINMODE_ADC);
	if (0 != rc)
	{
		perror("unable to setup pins");
		return EXIT_FAILURE;
	}

	return 0;
}

float foto_znach[8];



static void test_adc()
{
	ad5593_t * dev = &adc;

	ad5593_channel_id_t channels[] = {
			AD5593_ADC_0, AD5593_ADC_1, AD5593_ADC_2, AD5593_ADC_3,
			AD5593_ADC_4, AD5593_ADC_5, AD5593_ADC_6, AD5593_ADC_7,

	};
	for (int i = 0; i < sizeof(channels)/sizeof(channels[0]); i++)
	{
		uint16_t raw;
		ad5593_channel_id_t channel = channels[i];
		int rc = ad5593_adc_read(dev, channel, &raw);
		if (0 != rc)
			perror("bad read");

		float volts_ad = raw * 3.3 / 4095;	//Volts
		float ohms_ad = volts_ad*(3300)/(3.3-volts_ad);		//Ohms
		float lux_ad = exp((3.823-log(ohms_ad/1000))/0.816)*10.764;

		foto_znach[i] = lux_ad;

		//printf("%d, %d, %d, %f\n", i, rc, channel, lux_ad);
		//printf("%9.2f", lux_ad);
	}
	printf("\n");
}




int app_main(){


	FIL HenFile_1; // хендлер файла 1
	FIL HenFile_2; // хендлер файла 2
	FIL HenFile_3; // хендлер файла 3
	FIL HenFile_1csv; // хендлер файла 1
	FIL HenFile_2csv; // хендлер файла 2
	FIL HenFile_3csv; // хендлер файла 3
	//char Buffer[16] = "TestTestTestTest"; // данные для записи
	//UINT Ksbytes; // количество символов, реально записанных внутрь файла
	FRESULT res1; // результат выполнения функции
	FRESULT res2; // результат выполнения функции
	FRESULT res3; // результат выполнения функции
	FRESULT res1csv; // результат выполнения функции
	FRESULT res2csv; // результат выполнения функции
	FRESULT res3csv; // результат выполнения функции
	FRESULT resm; // результат выполнения функции



	char str_buf[300];
	uint16_t num_written;
	float current;
	float bus_voltage;
	float lsm_gyro[3];
	float lsm_temp;
	float lsm_accel[3];
	float lis[3];
	float lis_temp;
	struct bme280_data bme_data;
	struct bme280_dev bme;
	struct ina219_t ina219;

	float photor;

	float height = 0;
	uint16_t ds_temp;
	bool crc_ds = false;

	nrf24_fifo_status_t  rx_status;
	nrf24_fifo_status_t  tx_status;
	nrf_state_t nrf_state = NRF_PACK_1;
	int a = 0;
	uint Bytes;
	state_t state = STATE_BEFORE_LAUNCH;




	uint32_t tick;


	uint32_t nrf_start_time;
	uint32_t ds_start_time;


	uint64_t pack_time_s;



	float pack_latitude;
	float pack_longitude;
	float pack_height;
	uint32_t pack_time_us;
	int pack_fix;

	// Настройка сдвигового регистра IMU
	shift_reg_t imu_sr;
	imu_sr.latch_port = GPIOC;
	imu_sr.latch_pin = GPIO_PIN_1;
	imu_sr.oe_port = GPIOC;
	imu_sr.oe_pin = GPIO_PIN_13;
	imu_sr.value = 0;
	imu_sr.bus = &hspi2;
	shift_reg_init(&imu_sr);
	shift_reg_write_16(&imu_sr, 0xFFFF);


	// Настройка сдвигового регистра доп

	dop_sr.latch_port = GPIOB;
	dop_sr.latch_pin = GPIO_PIN_12;
	dop_sr.oe_port = GPIOB;
	dop_sr.oe_pin = GPIO_PIN_12;
	dop_sr.value = 0;
	dop_sr.bus = &hspi2;
	shift_reg_init(&dop_sr);
	shift_reg_write_16(&dop_sr, 0x0000);


	init();

	// Настройка сдвигового регистра NRF
	shift_reg_t nnrf_cfg;
	nnrf_cfg.latch_port = GPIOC;
	nnrf_cfg.latch_pin = GPIO_PIN_4;
	nnrf_cfg.oe_port = GPIOC;
	nnrf_cfg.oe_pin = GPIO_PIN_5;
	nnrf_cfg.value = 0;
	nnrf_cfg.bus = &hspi2;
	shift_reg_init(&nnrf_cfg);
	shift_reg_write_8(&nnrf_cfg, 0xFF);


	// Настройка nrf
	nrf24_spi_pins_sr_t nrf_cfg;
	nrf_cfg.pos_CE = 0;
	nrf_cfg.pos_CS = 1;
	nrf_cfg.this =  &nnrf_cfg;
	nrf24_lower_api_config_t nrf;

	nrf24_spi_init_sr(&nrf, &hspi2 ,&nrf_cfg );

	nrf24_rf_config_t nrf_config;
	nrf24_protocol_config_t nrf_protocol_config;

	nrf24_mode_power_down(&nrf);

	nrf_config.data_rate = NRF24_DATARATE_250_KBIT;
	nrf_config.rf_channel = 101;
	nrf_config.tx_power = NRF24_TXPOWER_MINUS_6_DBM;
	nrf24_setup_rf(&nrf, &nrf_config);

	nrf_protocol_config.address_width = NRF24_ADDRES_WIDTH_5_BYTES;
	nrf_protocol_config.auto_retransmit_count = 0;
	nrf_protocol_config.auto_retransmit_delay = 0;
	nrf_protocol_config.crc_size = NRF24_CRCSIZE_1BYTE;
	nrf_protocol_config.en_ack_payload = true;
	nrf_protocol_config.en_dyn_ack = true;
	nrf_protocol_config.en_dyn_payload_size = true;
	nrf24_setup_protocol(&nrf, &nrf_protocol_config);


	nrf24_pipe_set_tx_addr(&nrf,0xacacacacac);

	//настройка пайпа(штука , чтобы принимать)
	nrf24_pipe_config_t pipe_config;
	for (int i = 1; i < 6; i++)
	{
		pipe_config.address = 0xacacacacac;
		pipe_config.address = (pipe_config.address & ~((uint64_t)0xff << 32)) | ((uint64_t)(i + 7) << 32);
		pipe_config.enable_auto_ack = false;
		pipe_config.payload_size = -1;
		nrf24_pipe_rx_start(&nrf, i, &pipe_config);
	}

	pipe_config.address = 0xafafafaf01;
	pipe_config.enable_auto_ack = false;
	pipe_config.payload_size = -1;

	nrf24_pipe_rx_start(&nrf, 0, &pipe_config);

	nrf24_mode_standby(&nrf);
	nrf24_mode_tx(&nrf);


	// Настройка Lis
	stmdev_ctx_t lis_ctx;
	lis_spi_intf_sr lis_cfg;
	lis_cfg.spi = &hspi2;
	lis_cfg.sr = &imu_sr;
	lis_cfg.sr_pin = 3;

	lisset_sr(&lis_ctx, &lis_cfg);

	// Настройка Lsm
	stmdev_ctx_t stm_ctx;
	lsm_spi_intf_sr lsm_cfg;
	lsm_cfg.spi = &hspi2;
	lsm_cfg.sr = &imu_sr;
	lsm_cfg.sr_pin = 4;

	lsmset_sr(&stm_ctx, &lsm_cfg);

	// Настройка bme
	bme_spi_intf_sr bme_cfg;
	bme_cfg.spi = &hspi2;
	bme_cfg.sr = &imu_sr;
	bme_cfg.sr_pin = 2;

	bme_init_default_sr(&bme, &bme_cfg);

	// Настройка ds
	ds18b20_t ds_cfg;
	ds_cfg.onewire_pin = One_Wire_Pin;
	ds_cfg.onewire_port = One_Wire_GPIO_Port;

	// Настройка фоторезистора
	photorezistor_t phor_cfg;
	phor_cfg.hadc = &hadc1;
	phor_cfg.resist = 2000;

	// Инициализация ad5593
	setup_adc();
	//while(1){
	//}
	ina219_primary_data_t primary_data;

	ina219_secondary_data_t secondary_data;

	ina219_init_default(&ina219,&hi2c1,INA219_I2CADDR_A1_GND_A0_GND, HAL_MAX_DELAY);

	int comp;

	onewire_init(&ds_cfg);
	gps_init();
	__HAL_UART_ENABLE_IT(&huart6, UART_IT_RXNE);
	__HAL_UART_ENABLE_IT(&huart6, UART_IT_ERR);
	ds18b20_set_config(&ds_cfg, 100, -100, DS18B20_RESOLUTION_12_BIT);
	ds18b20_start_conversion(&ds_cfg);
	ds_start_time = HAL_GetTick();

	paket_1 p1_sr;
	paket_2 p2_sr;
	paket_3 p3_sr;

	p1_sr.n = 0;
	p2_sr.n = 0;
	p3_sr.n = 0;

	const char path1[] = "file1.bin"; // название файла
	const char path2[] = "file2.bin"; // название файла
	const char path3[] = "file3.bin"; // название файла
	const char csv1[] = "file1.csv"; // название файла
	const char csv2[] = "file2.csv"; // название файла
	const char csv3[] = "file3.csv"; // название файла


	extern Disk_drvTypeDef disk;
	disk.is_initialized[0] = 0;
	resm = f_mount(&fileSystem, SDPath, 1);

	if(resm == FR_OK)
	{
		HAL_GPIO_WritePin(GPIOB,GPIO_PIN_10, 1);

		res1 = f_open(&HenFile_1, path1, FA_WRITE | FA_OPEN_APPEND); // открытие файла, обязательно для работы с ним
		res2 = f_open(&HenFile_2, path2, FA_WRITE | FA_OPEN_APPEND); // открытие файла, обязательно для работы с ним
		res3 = f_open(&HenFile_3, path3, FA_WRITE | FA_OPEN_APPEND); // открытие файла, обязательно для работы с ним


		res1csv = f_open(&HenFile_1csv, csv1, FA_WRITE | FA_OPEN_APPEND); // открытие файла
		res2csv = f_open(&HenFile_2csv, csv2, FA_WRITE | FA_OPEN_APPEND); // открытие файла
		res3csv = f_open(&HenFile_3csv, csv3, FA_WRITE | FA_OPEN_APPEND); // открытие файла

		res1csv = f_puts("flag;time_pak;n;temp_bme;press;height_bme;current;bus_voltage;state;photor;crc\n", &HenFile_1csv);
		res1csv = f_sync(&HenFile_1);
		res2csv = f_puts("flag;time_pak;n;lis_x;lis_y;lis_z;lsm_a_x;lsm_a_y;lsm_a_z;lsm_g_x;lsm_g_y;lsm_g_z;crc\n",&HenFile_2csv );
		res2csv = f_sync(&HenFile_2);
		res3csv = f_puts("flag;time_pak;n;temp;latitude;longitude;height;time_s;time_us;fix;crc\n", &HenFile_3csv );
		res3csv = f_sync(&HenFile_3);

	}



	uint32_t perepar;
	uint32_t zemlya;
	uint32_t paneli;
	uint32_t doukladki;
	uint32_t trubki;
	uint32_t time_pishalka_off;
	uint32_t time_pishalka_on;


	int64_t cookie;


	int press_state;
	bme_data = bme_read_data(&bme);
	press_state = bme_data.pressure;


	test_adc();

	float foto_max;
	int i_max = 0;
	foto_max = foto_znach[0];
	float gradus;
	int time_gradus;
	float photor_state;
	int oborot = 3000;
	float max = 0;
	float now;

	int landing = 0;
	int opening = 0;
	int vertical = 0;
	int search = 0;
	int energy = 0;
	uint32_t time_pere_paneli;

	//shift_reg_write_bit_16(&dop_sr, 1, 1);

	//shift_reg_write_bit_16(&dop_sr, 0, 1);
	//shift_reg_write_bit_16(&dop_sr, 6, 1);
	//shift_reg_write_bit_16(&dop_sr, 7, 1);
	//shift_reg_write_bit_16(&dop_sr, 9, 1);




	while(1)
	{
		//loop();



		lsmread(&stm_ctx, &lsm_temp, &lsm_accel, &lsm_gyro);
		lisread(&lis_ctx, &lis_temp, &lis);
		bme_data = bme_read_data(&bme);
		height = 44330 * (1 - pow(bme_data.pressure / press_state, 1.0 / 5.255));
		test_adc();
		photor = foto_znach[0];
		//photor = photorezistor_get_lux(phor_cfg);

		if (HAL_GetTick() - ds_start_time > 750)
		{
			ds18b20_read_raw_temperature(&ds_cfg, &ds_temp, &crc_ds);
			ds18b20_start_conversion(&ds_cfg);
			ds_start_time = HAL_GetTick();
			p3_sr.temp = ds_temp/16;
		}



		int res = ina219_read_primary(&ina219,&primary_data);
		if (res == 2)
		{
			I2C_ClearBusyFlagErratum(&hi2c1, 20);
		}
		res = ina219_read_secondary(&ina219,&secondary_data);
		if (res == 2)
		{
			I2C_ClearBusyFlagErratum(&hi2c1, 20);
		}

		current = ina219_current_convert(&ina219, secondary_data.current) * 0.67034;

		bus_voltage = ina219_bus_voltage_convert(&ina219, primary_data.busv) * 1.0399;

		p1_sr.flag = 0xAA;
		p1_sr.press = bme_data.pressure;
		p1_sr.height_bme = height;
		p1_sr.photor = photor * 100;
		p1_sr.temp_bme = bme_data.temperature * 100;
		p1_sr.current = current * 1000;
		p1_sr.bus_voltage = bus_voltage * 1000;
		p1_sr.state = state;

		p2_sr.flag =0xBB;
		p2_sr.lis_x = lis[0] * 1000;
		p2_sr.lis_y = lis[1] * 1000;
		p2_sr.lis_z = lis[2] * 1000;
		p2_sr.lsm_a_x = lsm_accel[0] * 1000;
		p2_sr.lsm_a_y = lsm_accel[1] * 1000;
		p2_sr.lsm_a_z = lsm_accel[2] * 1000;
		p2_sr.lsm_g_x = lsm_gyro[0] * 1000;
		p2_sr.lsm_g_y = lsm_gyro[1] * 1000;
		p2_sr.lsm_g_z = lsm_gyro[2] * 1000;

		gps_work();
		gps_get_coords(&cookie, &pack_latitude, &pack_longitude, &pack_height, &pack_fix);
		gps_get_time(&cookie,&pack_time_s,&pack_time_us);

		p3_sr.flag = 0xCC;
		p3_sr.time_s = (uint32_t)pack_time_s;
		p3_sr.latitude = pack_latitude;
		p3_sr.longitude = pack_longitude;
		p3_sr.height = pack_height;
		p3_sr.time_us = pack_time_us;
		p3_sr.fix = pack_fix;


		if (resm == FR_OK){
			HAL_GPIO_WritePin(GPIOB,GPIO_PIN_10, 1);
			if(res1 != FR_OK){
				res1 = f_close(&HenFile_1); // закрытие файла
				res1 = f_open(&HenFile_1, path1, FA_WRITE | FA_OPEN_APPEND); // открытие файла

			}
			if(res2 != FR_OK){
				res2 = f_close(&HenFile_2); // закрытие файла
				res2 = f_open(&HenFile_2, path2, FA_WRITE | FA_OPEN_APPEND); // открытие файла
			}
			if(res3 != FR_OK){
				res3 = f_close(&HenFile_3); // закрытие файла
				res3 = f_open(&HenFile_3, path3, FA_WRITE | FA_OPEN_APPEND); // открытие файла
			}
			if(res1csv != FR_OK){
				res1csv = f_close(&HenFile_1csv); // закрытие файла
				res1csv = f_open(&HenFile_1csv, csv1, FA_WRITE | FA_OPEN_APPEND); // открытие файла
			}
			if(res2csv != FR_OK){
				res2csv = f_close(&HenFile_2csv); // закрытие файла
				res2csv = f_open(&HenFile_2csv, csv2, FA_WRITE | FA_OPEN_APPEND); // открытие файла
			}
			if(res3csv != FR_OK){
				res3csv = f_close(&HenFile_3csv); // закрытие файла
				res3csv = f_open(&HenFile_3csv, csv3, FA_WRITE | FA_OPEN_APPEND); // открытие файла
			}
		}


		if (resm != FR_OK || res3 != FR_OK || res2 != FR_OK || res1 != FR_OK || res3csv != FR_OK || res2csv != FR_OK || res1csv != FR_OK)

		{
			HAL_GPIO_WritePin(GPIOB,GPIO_PIN_10, 0);
			f_mount(0, 0, 1);

			extern Disk_drvTypeDef disk;
			disk.is_initialized[0] = 0;
			f_mount(&fileSystem, SDPath, 1);
			res1 = f_open(&HenFile_1, path1, FA_WRITE | FA_OPEN_APPEND); // открытие файла
			res2 = f_open(&HenFile_2, path2, FA_WRITE | FA_OPEN_APPEND); // открытие файла
			res3 = f_open(&HenFile_3, path3, FA_WRITE | FA_OPEN_APPEND); // открытие файла
			res1csv = f_open(&HenFile_1csv, csv1, FA_WRITE | FA_OPEN_APPEND); // открытие файла
			res2csv = f_open(&HenFile_2csv, csv2, FA_WRITE | FA_OPEN_APPEND); // открытие файла
			res3csv = f_open(&HenFile_3csv, csv3, FA_WRITE | FA_OPEN_APPEND); // открытие файла
		}





		switch(state){
			case STATE_BEFORE_LAUNCH:
			{
				uint8_t knopka = HAL_GPIO_ReadPin(GPIOA, GPIO_PIN_4);
				if(knopka == 1){
					press_state = bme_data.pressure;
					photor_state = photor;
					shift_reg_write_bit_16(&imu_sr, 12, 0);
					shift_reg_write_bit_16(&imu_sr, 11, 1);
					doukladki = HAL_GetTick();
					state = STATE_IN_ROCKET;
				}
			}
			break;
			case STATE_IN_ROCKET:
			{

				if((photor >= 0.8 * photor_state) && (HAL_GetTick() - doukladki >= 10000))
				{
					state = STATE_PARACHUTE_DESENT;
					shift_reg_write_bit_16(&imu_sr, 11, 0);
					shift_reg_write_bit_16(&imu_sr, 12, 1);
				}
			}
			break;
			case STATE_PARACHUTE_DESENT:
			{
				if(height <= 6.3){
					shift_reg_write_bit_16(&dop_sr, 6, 1);
					state = STATE_DESENT;
					perepar = HAL_GetTick();
				}
			}
			break;
			case STATE_DESENT:
			{
				if(HAL_GetTick() - perepar >= 1000)
				{
					shift_reg_write_bit_16(&dop_sr, 6, 0);
					if (landing == 0){
						zemlya = HAL_GetTick();
						landing = 1;
					}
					else {
						if(HAL_GetTick() - zemlya >= 2000){
							state = STATE_LANDING;
						}
					}
				}
			}
			break;
			case STATE_LANDING:
			{
				shift_reg_write_bit_16(&dop_sr, 7, 1);

				if (opening == 0){
					paneli = HAL_GetTick();
					opening = 1;
				}
				else
				{
					if(HAL_GetTick() - paneli >= 1000)
					{
						shift_reg_write_bit_16(&dop_sr, 7, 0);
						shift_reg_write_bit_16(&dop_sr, 1, 1);
						if (vertical == 0){
							trubki = HAL_GetTick();
							vertical = 1;
						}
						else {
							if (HAL_GetTick() - trubki >= 5000){
								state = STATE_OPEN_SP;
							}
						}
					}
				}
			}
			break;
			case STATE_OPEN_SP:
			{
				shift_reg_write_bit_16(&dop_sr, 1, 0);
				shift_reg_write_bit_16(&dop_sr, 0, 1);
				if(search == 0){
					time_pere_paneli = HAL_GetTick();
					search = 1;
				}
				if(HAL_GetTick() - time_pere_paneli >= 1000)
				{
					shift_reg_write_bit_16(&dop_sr, 0, 0);
					state = STATE_SUN_SEARCH;
				}
			}
			break;
			case STATE_SUN_SEARCH:
			{
				for(int i = 0;i < 8;i++ )
				{
					printf("%9.2f \n", foto_znach[i]);

					if(foto_znach[i] > foto_max)
					{
						foto_max = foto_znach[i];
						i_max = i;
					}
				}


				gradus = 67.5 + 45.0 * i_max;
				time_gradus = (6000.0 / 360.0) * gradus;

				shift_reg_write_bit_16(&dop_sr, 2, 1);
				HAL_Delay(time_gradus);
				shift_reg_write_bit_16(&dop_sr, 2, 0);



				uint32_t max_time = HAL_GetTick();
				shift_reg_write_bit_16(&dop_sr, 4, 1);
				uint32_t start_time = HAL_GetTick();
				while(HAL_GetTick() - start_time < oborot)
				{
					now = photorezistor_get_lux(phor_cfg);
					if (now > max)
					{
						max = now;
						max_time = HAL_GetTick();
					}
				}
				shift_reg_write_bit_16(&dop_sr, 4, 0);

				shift_reg_write_bit_16(&dop_sr, 5, 1);
				HAL_Delay(oborot-(max_time - start_time));
				shift_reg_write_bit_16(&dop_sr, 5, 0);

				HAL_Delay(100);

				state = STATE_ENERGY;

			}
			case STATE_ENERGY:
			{
				if (energy == 0){
				time_pishalka_off = HAL_GetTick() + 3000;
				time_pishalka_on = HAL_GetTick() + 5000;
				energy = 1;
			}
			if(HAL_GetTick() >= time_pishalka_off)
			{
				shift_reg_write_bit_16(&dop_sr, 9, 0);
				time_pishalka_off = HAL_GetTick() + 3000;
			}
			else
			{
				if (HAL_GetTick() >= time_pishalka_on){
					shift_reg_write_bit_16(&dop_sr, 9, 1);
								time_pishalka_on = HAL_GetTick() + 4000;
				}
			}
			}
		}




		switch(nrf_state) {
			case NRF_PACK_1:
				tick = HAL_GetTick()-tick;
				p1_sr.n++;
				//p2_sr.n++;
				p1_sr.time_pak = HAL_GetTick();
				//p2_sr.time_pak = HAL_GetTick();
				p1_sr.crc = Crc16((uint8_t *)&p1_sr, sizeof(p1_sr) - 2);
				//p2_sr.crc = Crc16((uint8_t *)&p2_sr, sizeof(p2_sr) - 2);
				nrf24_fifo_write(&nrf, (uint8_t *)&p1_sr,sizeof(p1_sr ),false);
				//nrf24_fifo_write(&nrf, (uint8_t *)&p2_sr,sizeof(p2_sr),false);

				a++;
				//nrf_state = NRF_WAIT;
				nrf_start_time = HAL_GetTick();

				if (resm == FR_OK){
					res1 = f_write(&HenFile_1,(uint8_t *)&p1_sr,sizeof(p1_sr), &Bytes); // отправка на запись в файл
					res1 = f_sync(&HenFile_1); // запись в файл (на sd контроллер пишет не сразу, а по закрытии файла. Также можно использовать эту команду)


					num_written = sd_parse_to_bytes_pac1(str_buf, &p1_sr);

					res1csv = f_write(&HenFile_1csv,str_buf,num_written, &Bytes); // отправка на запись в файл
					res1csv = f_sync(&HenFile_1csv); // запись в файл (на sd контроллер пишет не сразу, а по закрытии файла. Также можно использовать эту команду)

					//res2 = f_write(&HenFile_2,(uint8_t *)&p2_sr, sizeof(p2_sr), &Bytes); // отправка на запись в файл
					//res2 = f_sync(&HenFile_2); // запись в файл (на sd контроллер пишет не сразу, а по закрытии файла. Также можно использовать эту команду)

					//num_written = sd_parse_to_bytes_pac2(str_buf, &p2_sr);

					//res2csv = f_write(&HenFile_2csv,str_buf,num_written, &Bytes); // отправка на запись в файл
					//res2csv = f_sync(&HenFile_2csv); // запись в файл (на sd контроллер пишет не сразу, а по закрытии файла. Также можно использовать эту команду)
				}
				nrf_state = NRF_PACK_2;

			break;
			case NRF_PACK_2:
				tick = HAL_GetTick()-tick;
				p2_sr.n++;
				p2_sr.time_pak = HAL_GetTick();
				p2_sr.crc = Crc16((uint8_t *)&p2_sr, sizeof(p2_sr) - 2);
				nrf24_fifo_write(&nrf, (uint8_t *)&p2_sr,sizeof(p2_sr),false);

				nrf_state = NRF_WAIT;
				nrf_start_time = HAL_GetTick();

				if (resm == FR_OK){

					res2 = f_write(&HenFile_2,(uint8_t *)&p2_sr, sizeof(p2_sr), &Bytes); // отправка на запись в файл
					res2 = f_sync(&HenFile_2); // запись в файл (на sd контроллер пишет не сразу, а по закрытии файла. Также можно использовать эту команду)

					num_written = sd_parse_to_bytes_pac2(str_buf, &p2_sr);

					res2csv = f_write(&HenFile_2csv,str_buf,num_written, &Bytes); // отправка на запись в файл
					res2csv = f_sync(&HenFile_2csv); // запись в файл (на sd контроллер пишет не сразу, а по закрытии файла. Также можно использовать эту команду)
				}


			break;
			case NRF_PACK_3:
				tick = HAL_GetTick()-tick;
				p3_sr.n++;
				p3_sr.time_pak = HAL_GetTick();
				p3_sr.crc = Crc16((uint8_t *)&p3_sr, sizeof(p3_sr) - 2);
				nrf24_fifo_write(&nrf, (uint8_t *)&p3_sr,sizeof(p3_sr),false);
				a = 0;
				nrf_state = NRF_WAIT;
				nrf_start_time = HAL_GetTick();

				if (resm == FR_OK){
					res3 = f_write(&HenFile_3,(uint8_t *)&p3_sr,sizeof(p3_sr), &Bytes); // отправка на запись в файл
					res3 = f_sync(&HenFile_3); // запись в файл (на sd контроллер пишет не сразу, а по закрытии файла. Также можно использовать эту команду)

					num_written = sd_parse_to_bytes_pac3(str_buf, &p3_sr);


					res3csv = f_write(&HenFile_3csv, str_buf, num_written, &Bytes); // отправка на запись в файл
					res3csv = f_sync(&HenFile_3csv); // запись в файл (на sd контроллер пишет не сразу, а по закрытии файла. Также можно использовать эту команду)
				}

			break;
			case NRF_WAIT:
				if (HAL_GPIO_ReadPin(GPIOC, GPIO_PIN_2) == GPIO_PIN_RESET){
					nrf24_irq_get(&nrf, &comp);
					nrf24_irq_clear(&nrf, comp);
					nrf24_fifo_status(&nrf,&rx_status,&tx_status);

					if (tx_status == NRF24_FIFO_EMPTY)
					{
						if (a == 4)
						{
							nrf_state = NRF_PACK_3;
						}
						else
						{
							nrf_state = NRF_PACK_1;
						}
						break;
					}
				}
				if (HAL_GetTick() - nrf_start_time > 100)
				{
					nrf24_fifo_flush_tx(&nrf);
					if (a == 4)
					{
						nrf_state = NRF_PACK_3;
					}
					else
					{
						nrf_state = NRF_PACK_1;
					}
					break;

				}
				break;
			}


		/*
		printf("АКСЕЛЕРОМЕТР X %f\n АКСЕЛЕРОМЕТР Y %f\n АКСЕЛЕРОМЕТР Z %f\n", lsm_accel[0], lsm_accel[1], lsm_accel[2]);
		printf("ГИРОСКОП X %f\n ГИРОСКОП Y %f\n ГИРОСКОП Z %f\n", lsm_gyro[0], lsm_gyro[1], lsm_gyro[2]);
		printf("Температура %f\n\n\n\n", lsm_temp);
		printf("МАГНИТОМЕТР X %f\n МАГНИТОМЕТР Y %f\n МАГНИТОМЕТР Z %f\n", lis[0], lis[1], lis[2]);
		printf("Давление  %lf \n Температура %lf \n", bme_data.pressure, bme_data.temperature);
		printf("power %f\n current %f\n bus_voltage %f\n shunt_voltage %f\n" , power, current,bus_voltage,shunt_voltage);
		*/




	}


	return 0;
}
