cansat-tsniimash/KNPN-2023/src/board/KNPN_NNA/KNPN_NNA.ioc

Mcu.UserName=STM32F401RCTx
PA1.GPIO_Label=One_Wire
PA1.Signal=GPIO_Output
PA10.Signal=USART1_RX
PA4.Signal=GPIO_Input
PA5.Signal=ADCx_IN5
PA6.Signal=S_TIM3_CH1
PA7.Signal=S_TIM3_CH2
PA8.Signal=GPIO_Output
PA9.Signal=USART1_TX
PB10.Signal=GPIO_Output
PB12.Signal=GPIO_Output
PB13.Signal=SPI2_SCK
PB14.Signal=SPI2_MISO
PB15.Signal=SPI2_MOSI
PB8.Signal=I2C1_SCL
PB9.Signal=I2C1_SDA
PC1.Signal=GPIO_Output
PC12.Signal=SDIO_CK
PC13-ANTI_TAMP.Signal=GPIO_Output
PC14-OSC32_IN.Signal=RCC_OSC32_IN
PC15-OSC32_OUT.Signal=RCC_OSC32_OUT
PC2.Signal=GPIO_Input
PC4.Signal=GPIO_Output
PC5.Signal=GPIO_Output
PC6.Signal=USART6_TX
PC7.Signal=USART6_RX
PC8.Signal=SDIO_D0
PD2.Signal=SDIO_CMD
