cansat-tsniimash/KNPN-2023/src/board/KNPN_NNA/App/I2C_crutch/i2c-crutch.h

/*
 * i2c-crutch.h
 *
 *  Created on: 12 нояб. 2022 г.
 *      Author: Agnus
 */

#ifndef INC_I2C_CRUTCH_H_
#define INC_I2C_CRUTCH_H_

void I2C_ClearBusyFlagErratum(I2C_HandleTypeDef *hi2c, uint32_t timeout);
void reset_i2c_1();

#endif /* INC_I2C_CRUTCH_H_ */
