cansat-tsniimash/KNPN-2023/(commit log)

2023-02-04 Сабмодули
2023-02-11 код на LIS, LSM, BMP, начали радио
2023-02-11 начали делать доп. плату
    [dop.brd, dop.sch]
2023-02-16 Удалили плату
    [dop.brd]
2023-02-16 продолжаем делать доп плату
    [dop.brd, dop.sch]
2023-02-16 Добавили фоторезистор в библиотеку
2023-02-17 Убрали дебаг + прописали путь
2023-02-17 добавил фоторезисторы на плату
    [dop.brd, dop.sch]
2023-02-18 добавил фоторезистор и ds , начал заполнять пакеты радио
2023-02-18 начали писать код на наземку
2023-02-18 я шпион спорадика, почти забацал плату доп
    [dop.brd, dop.sch]
2023-02-19 Закинула все модели creo в папку construction
    [10dof_imu_sensor.prt, ad5593.prt, ads1115.prt, air-valve.prt, akkum_18350.prt, antenna_2_4ghz.prt, antenna_gps-slim.prt, barometer_bmp280_module.prt]
2023-02-19 Добавили стопор двигателя для трубок
    [blinchik-down_1.prt, blinchik-down_2.prt, blinchik_for_kreplenie.prt, blinchik_kernel_up.prt, button.prt, es_board.prt, ftoroplast-botom.prt, ftoroplast-top.prt]
2023-02-23 Создали stl нижней части
    [blinchik-down_1.prt, blinchik-down_1.stl, blinchik-down_2.prt, blinchik-down_2.stl, dop.brd, kreplenie_motor_i_akkum_niz.prt, kreplenie_motor_i_akkum_niz.stl, krishka_akkum.stl]
2023-02-23 Сделали новую плату для кнопок на нижнем двигателе
    [dop.brd, kreplenie_plata.prt, mtr.brd, mtr.sch]
2023-02-24 заполнил 3 пакета и добавил crc
2023-03-03 Начали делать платы СП
    [SP1.brd, SP1.sch, SP2.brd, SP2.sch, dop.brd, dop.sch, mtr.brd, mtr.sch]
2023-03-03 Добавлены пружины для отделения парашюта
    [blinchik_for_kreplenie.prt, blinchik_kernel_up.prt, blinchik_kernel_up.stl, detal_vrashenie.prt, detal_vrashenie_w_spring.prt, kreplenie_camera.prt, kreplenie_camera.stl, kreplenie_motor_i_akkum_niz.prt]
2023-03-03 Файлы stl перемещены в папку stl
    [blinchik-down_1.stl, blinchik-down_2.stl, blinchik_kernel_up.stl, kreplenie_camera.stl, kreplenie_motor_i_akkum_niz.stl, krishka_akkum.stl]
2023-03-04 развёл плату солнечных панелей(на деньги)
    [SP1.brd, SP1.sch, SP2.brd, SP2.sch]
2023-03-04 всё плохо ):
2023-03-11 добавил ину(всё плохо)
2023-03-16 Ина работает и откалибрована (коэффициент не потребовался)
2023-03-18 Радио шлет, принимаем мало
2023-03-18 ина больше не работает :(
2023-03-18 ина пашет как не в себя
2023-03-22 Доделаны платы dop и mtr
    [ad5593.prt, beacon_mini_rockwell_ibeacon.prt, connector_b2b-eh-a.prt, detal_vrashenie.stl, detal_vrashenie_w_spring.stl, dop.brd, dop.sch, drw0001.dxf]
2023-03-22 Добавлена плата мотора в сборку
    [SP1.brd, SP2.brd, kreplenie_plata.prt, plata_mtr.prt]
2023-03-25 Вроде бы то закомитил. Проверяйте
2023-03-25 Добавлен счетчик энкодера
2023-03-25 Подготовлены платы SP и mtr
    [SP2.brd, SP2.sch, blinchik-down_2.prt, es_board.prt, kreplenie_plata.prt, mtr.brd, plata_mtr.prt, vt93n1.dxf]
2023-03-25 энкодер
2023-03-26 Подготовлена плата dop
    [dop.brd, dop.sch, drw0001.dxf]
2023-04-06 SD работает, но в csv иногда пишет лишнее
    [KNPN_NNA Debug.cfg]
2023-04-08 Обновления в моделях
    [ad5593.prt, blinchik-down_1.stl, blinchik-down_2.stl, blinchik_for_kreplenie.prt, camera-sq11.prt, kreplenie_camera.prt, kreplenie_camera.stl, kreplenie_motor_i_akkum_niz.prt]
2023-04-08 радио работает но медленно и onewire не работает :(
2023-04-13 Демо-проект для съема показаний с энкодера
2023-05-03 чёта
2023-05-03 начал писать gps
2023-05-13 надеюсь будет работать
2023-05-20 ацп работает (Василий спасибо)
2023-05-27 Написали навдение по двум осям
2023-05-27 Обновления в модели
    [akkum_18350.prt, beacon_mini_rockwell_ibeacon.prt, blinchik-down_1.prt, blinchik-down_2.prt, blinchik_for_kreplenie.prt, blinchik_for_kreplenie.stl, blinchik_kernel_up.prt, blinchik_kernel_up.stl]
2023-05-27 Обновления в платах
    [SP.brd, SP.sch, dop.brd, dop.sch, mtr.brd, mtr.sch]
2023-05-27 Добавлен файл гитигнор
2023-06-03 АЦП в аппарате не работает
2023-06-04 Новые версии плат
    [SP.brd, SP.sch, blinchik_kernel_up.prt, dop.brd, dop.sch, kreplenie_plata.prt]
2023-06-05 STL для печати облегченной модели
    [blinchik-down_1.stl, blinchik-down_2.stl, blinchik_for_kreplenie.stl, blinchik_kernel_up.stl, cilindr.stl, detal_vrashenie_w_spring.stl, kreplenie_motor_i_akkum_niz.stl, kreplenie_plata.stl]
2023-06-05 Облегчение модели
    [blinchik-down_1.prt, blinchik-down_2.prt, blinchik_for_kreplenie-old.prt, blinchik_for_kreplenie.prt, blinchik_kernel_up.prt, cilindr.prt, detal_vrashenie_w_spring.prt, gear-bot-big.prt]
2023-06-10 Ина на плате работет. Коэффициенты: для тока (0,67034), для напряжения (1,0399).
2023-06-23 ну оно работало, а теперь нет :(
2023-06-25 Радио шлет первые пакеты на мощности -6dBm. На большей видимо не хватает питания
2023-06-26 Высота норм, фоторезистор норм. Не переходит в 4 состояние.
2023-06-27 Исправили циклы в 3 и 4 состояниях
    [app_main.c]
2023-06-29 Состояния работают
2023-06-30 Пока все работает
2023-07-01 иуууууууууууууууууууууууууууууууууууууууууууууууууу готово все с кайфом :D
2023-07-02 Актуальные модели
    [blinchik-down_1.prt, blinchik-down_1_final.stl, blinchik-down_1_low.prt, blinchik-down_1_low.stl, blinchik-down_2.prt, blinchik-down_2_final.stl, box.prt, box.stl]
