cansat-tsniimash/KNPN-2023/(notices)

Notices in the files:
src/research/encoder-demo/Core/Src/main.c:
Copyright (c) 2023 STMicroelectronics.
All rights reserved.
This software is licensed under terms that can be found in the LICENSE file
